W9JSW/Hermes-Lite/FR-Sense/FRSense-BOM.xls

Digi-Key Part Number | Manufacturer | Manufacturer Part Number | Customer Reference | Quantity | Description | Notes
311-1361-1-ND | YAGEO (VA) | CC0805ZRY5V9BB104 | C3 C5 C6 C7 C8 | 5 | CAP CER 0.1UF 50V Y5V 0805
S1011E-03-ND | SULLINS CONNECTOR SOLUTIONS (VA) | PBC03SAAN | P1 | 1 | CONN HEADER .100 SINGL STR 3POS
399-3797-1-ND | KEMET (VA) | T491D476M025AT | C4 | 1 | CAP TANT 47UF 25V 20% 2917
S1011E-02-ND | SULLINS CONNECTOR SOLUTIONS (VA) | PBC02SAAN | P2 | 1 | CONN HEADER .100 SINGL STR 2POS
490-6981-1-ND | MURATA ELECTRONICS (VA) | NFM21PC224R1C3D | C1 C2 | 2 | FILTER HIGH FREQ 220000PF 080
311-1.80KCRCT-ND | YAGEO (VA) | RC0805FR-071K8L | R1 R3 | 2 | RES SMD 1.8K OHM 1% 1/8W 0805
311-1.00KCRCT-ND | YAGEO (VA) | RC0805FR-071KL | R2 R5 | 2 | RES SMD 1K OHM 1% 1/8W 0805
311-220KCRCT-ND | YAGEO (VA) | RC0805FR-07220KL | R4 R6 | 2 | RES SMD 220K OHM 1% 1/8W 0805
311-100KCRCT-ND | YAGEO (VA) | RC0805FR-07100KL | R7 R8 | 2 | RES SMD 100K OHM 1% 1/8W 0805
311-49.9CRCT-ND | YAGEO (VA) | RC0805FR-0749R9L | R9 R10 | 1 | RES SMD 49.9 OHM 1% 1/8W 0805 | Substitute for 50.1 ohm values
490-5987-1-ND | MURATA ELECTRONICS (VA) | BLM21PG220SN1D | L1 | 1 | FERRITE CHIP 22 OHM 0805
1N5711W-FDICT-ND | DIODES INC | 1N5711W-7-F | D1 D2 D3 D4 | 4 | Schottky Diode | Install reversed – silkscreen incorrect
LMC6482IMX/NOPBCT-ND | TEXAS INSTRUMENTS | LMC6482IMX/NOPB | U1 | 1 | LMC6482A Dual Op-Amp
 | Amidon |  | T1 T2 | 2 | FT43-37 Toroid | Kits and Parts
WM5524-ND | MOLEX INC | 0731000105 | P3 P4 | 2 | CONN BNC JACK R/A 50 OHM PCB
