W9JSW/Hermes-Lite/power2/power2-bom.xls

Item | Quantity | Reference | Value | Item | Mfg Part Number | DigiKey Part Number | Notes
1 | 1 | C1 | 47uF 25V | Tantalum Cap | T491D476M025AT | 399-3797-1-ND
2 | 4 | C3 C9 C10 C11 | 100nF | Capacitor | CC0805ZRY5V9BB104 | 311-1361-1-ND | C11 optional
3 | 4 | C5 C6 C7 C8 | NFM21PC224R1C3D | Filter | NFM21PC224R1C3D | 490-6981-1-ND
4 | 2 | C2 C4 | 10uF | Capacitor | GRM219R61E106KA12D | 490-7207-1-ND
5 | 2 | D1 D2 | 1n5711 | Schottky Diode | 1N5711W-7-F | 1N5711W-FDICT-ND
6 | 1 | D3 | BZX84C 3V3 | Zener Diode | BZX84C3V3-TP | BZX84C3V3-TP-ND | Optional
7 | 2 | L1 L2 | BLM21PG220SN1D | Ferrite | BLM21PG220SN1D | 490-5987-1-ND
8 | 1 | P1 (P4) | 2x12 angled socket | can sub 2 2x6 sockets | PPPC122LJBN-RC | S5565-ND
9 | 2 | P2 P5 | CONN_01X02 | Sullins connector | PBC02SAAN | S1011E-02-ND
10 | 1 | P3 | CONN_01X03 | Sullins connector | PBC03SAAN | S1011E-03-ND
11 | 1 | P6 | CONN_01X05 | Can wire directly
12 | 2 | n/a | Socket 1x03 | Regulator Socket | PPPC031LFBN-RC | S7036-ND
13 | 1 | R1 R11 | 1k | resistor | RC0805FR-071KL | 311-1.00KCRCT-ND
14 | 1 | R10 | 820 | resistor | CRCW0805820RFKEA | 541-820CCT-ND | Optional
15 | 1 | R2 | 100 | resistor | RC0805FR-07100RL | 311-100CRCT-ND
16 | 3 | R3 R5 R7 | 100k | resistor | RC0805FR-07100KL | 311-100KCRCT-ND
17 | 1 | R4 | 220k | resistor | RC0805FR-07220KL | 311-220KCRCT-ND
18 | 2 | R6 R8 | 510k | resistor | RC0805JR-07510KL | 311-510KARCT-ND
19 | 1 | R9 | 4.7k | resistor | RC0805FR-074K7L | 311-4.70KCRCT-ND | Optional
20 | 1 | R12 | 270 | resistor | RC0805FR-07270R | 311-270CRCT-ND
21 | 3 | R13 R14 R15 | 10k | resistor | RC0805FR-0710KL | 311-10.0KCRCT-ND
22 | 1 | U1 | ADC78H90CIMT | ADC | ADC78H90CIMTX/NOPB | 296-35239-1-ND
23 | 1 | U2 | Oki 5V Reg | Vert Regulator | OKI-78SR-5/1.5-W36-C | 811-2196-5-ND
24 | 1 | U3 | Oki 3.3V Reg | Vert Regulator | OKI-78SR-3.3/1.5-W36-C | 811-2195-5-ND
25 | 1 | U4 | LMC6482A | Op-amp | LMC6482IMX/NOPB | LMC6482IMX/NOPBCT-ND
26 | 3 | U5 U6 U7 | LTV356 | Opto-isolator | LTV356T | 160-1337-1-ND
 |  | Optional components enable a 12v vs 13.8v sensor for PowerSDR. Not necessary at all...
