W9JSW/Hermes-Lite/FR-Sense/Converter-BOM.xls

Digi-Key Part Number | Manufacturer | Manufacturer Part Number | Customer Reference | Quantity 1 | Description
311-1361-1-ND | YAGEO (VA) | CC0805ZRY5V9BB104 | C3,C6,C8,C10 | 4 | CAP CER 0.1UF 50V Y5V 0805
445-7664-1-ND | TDK CORPORATION (VA) | C2012X5R1A226K125AB | C4,C9 | 2 | CAP CER 22UF 10V 10% X5R 0805
490-5986-1-ND | MURATA ELECTRONICS (VA) | BLM21PG121SN1D | L1,L4 | 2 | FERRITE CHIP 120 OHM 0805
S1011E-04-ND | SULLINS CONNECTOR SOLUTIONS (VA) | PBC04SAAN | P2 | 1 | CONN HEADER .100 SINGL STR 4POS
399-3797-1-ND | KEMET (VA) | T491D476M025AT | C5,C15 | 2 | CAP TANT 47UF 25V 20% 2917
S1011E-02-ND | SULLINS CONNECTOR SOLUTIONS (VA) | PBC02SAAN | P1 | 1 | CONN HEADER .100 SINGL STR 2POS
399-3734-1-ND | KEMET (VA) | T491C106K025AT | C1,C12 | 2 | CAP TANT 10UF 25V 10% 2413
490-6981-1-ND | MURATA ELECTRONICS (VA) | NFM21PC224R1C3D | C2,C11 | 2 | FILTER HIGH FREQ 220000PF 080
308-2342-1-ND | SUMIDA AMERICA COMPONENTS INC (VA) | 252012CDMCDS-1R0MC | L3 | 1 | FIXED IND 1UH 3.1A 35 MOHM SMD
308-2343-1-ND | SUMIDA AMERICA COMPONENTS INC (VA) | 252012CDMCDS-1R5MC | L2 | 1 | FIXED IND 1.5UH 2.5A 55 MOHM SMD
311-10.0KCRCT-ND | YAGEO (VA) | RC0805FR-0710KL | R2,R3 | 2 | RES SMD 10K OHM 1% 1/8W 0805
311-45.3KCRCT-ND | YAGEO (VA) | RC0805FR-0745K3L | R4 | 1 | RES SMD 45.3K OHM 1% 1/8W 0805
311-73.2KCRCT-ND | YAGEO (VA) | RC0805FR-0773K2L | R1 | 1 | RES SMD 73.2K OHM 1% 1/8W 0805
311-1449-1-ND | YAGEO (VA) | CC0603KRX5R5BB225 | C7 | 1 | CAP CER 2.2UF 6.3V 10% X5R 0603
490-5987-1-ND | MURATA ELECTRONICS (VA) | BLM21PG220SN1D | L5 | 1 | FERRITE CHIP 22 OHM 0805
