W9JSW/Hermes-Lite/frontend/v2-RX-Filter/v2rx-bom.xls

Quantity | Reference | Value | Description | Manufacturer | Manufacturer Part Number | Substitution allowed? | Comments | Supplier | Supplier PN | Cost | Sub-Total
5 | C1 C52 C74 C80 C81 | 0.1uF |  | Yageo | CC0805ZRY5V9BB104 | Yes | CAP CER 0.1UF 50V Y5V 0805 | Digi-Key | 311-1361-1-ND | $0.03 | $0.15
7 | C44 C75-C79 C82 | 0.01uF | SMT | Yageo | CC0805KRX7R9BB103 | Yes | CAP CER 10000PF 50V X7R 0805 | Digi-Key | 311-1136-1-ND | $0.71 | $4.97
5 | C18 C23 C37 C45 C62 | 120pF |  | Yageo | CC0805JRNPO9BN121 | Yes | CAP CER 120PF 50V 5% | Digi-Key | 311-1112-1-ND | $0.11 | $0.55
1 | C14 | 82pF |  | Yageo | CC0805JRNPO9BN820 | Yes | CAP CER 82PF 50V 5% | Digi-Key | 311-1110-1-ND | $0.10 | $0.10
4 | C19 C25 C47 C63 | 180pF |  | Yageo | CC0805JRNPO9BN181 | Yes | CAP CER 180PF 50V NPO 5% | Digi-Key | 311-1114-1-ND | $0.06 | $0.22
3 | C29 C43 C51 | 1500pF |  | Kemet | C0805C152J5GACTU | Yes | CAP CER 1500PF 50V NP0 0805 | Digi-Key | 399-8027-1-ND | $0.24 | $0.72
2 | C39 C40 | 270pF |  | Yageo | CC0805JRNPO9BN271 | Yes | CAP CER 270PF 50V 5% | Digi-Key | 311-1116-1-ND | $0.12 | $0.24
4 | C21 C27 C49 C65 | 560pF |  | Yageo | CC0805JRNPO9BN561 | Yes | CAP CER 560PF 50V 5% | Digi-Key | 311-1120-1-ND | $0.14 | $0.56
2 | C22 C66 | 1000pF |  | Yageo | CC0805JRNPO0BN102 | Yes | CAP CER 1000PF 100V NPO 0805 | Digi-Key | 311-1835-1-ND | $0.10 | $0.20
1 | C35 | 220pF |  | Yageo | CC0805JRNPO9BN221 | Yes | CAP CER 220PF 50V 5% | Digi-Key | 311-1115-1-ND | $0.12 | $0.12
2 | C16 C60 | 68pF |  | Yageo | CC0805JRNPO9BN680 | Yes | CAP CER 68PF 50V NPO 5% | Digi-Key | 311-1109-1-ND | $0.10 | $0.20
1 | C20 C26 C48 C64 | 330pF |  | Yageo | CC0805JRNPO9BN331 | Yes | CAP CER 330PF 50V NPO 0805 | Digi-Key | 311-1117-1-ND | $0.11 | $0.11
1 | C41 | 680pF |  | Yageo | CC0805JRNPO9BN681 | Yes | CAP CER 680PF 50V 5% NPO 0805 | Digi-Key | 311-1121-1-ND | $0.15 | $0.15
3 | C28 C42 C50 | 1200pF |  | Yageo | CC0805JRNPO0BN122 | Yes | CAP CER 1200PF 100V NPO 0805 | Digi-Key | 311-1837-1-ND | $0.10 | $0.30
1 | P1 |  | 2x7 header | Sullins | PRPC007DAAN-RC | Yes | CONN HEADER .100" DUAL STR 14POS | Digi-Key | S2011EC-07-ND | $0.46 | $0.46
3 | L1 L15 L8 | 680nH |  | Abracon | AIML-1206-R68 | No | FIXED IND 680NH 150MA 650 MOHM | Digi-Key | 535-11689-1-ND | $0.20 | $0.60
3 | L10 L17 L3 | 820nH |  | Abracon | AIML-1206-R82 | No | FIXED IND 820NH 150MA 650 MOHM | Digi-Key | 535-11690-1-ND | $0.20 | $0.60
3 | L4 L11 L18 | 1.5uH |  | Abracon | AIML-1206-1R5 | No | FIXED IND 1.5UH 50MA 450 MOHM | Digi-Key | 535-11663-1-ND | $0.20 | $0.60
3 | L5 L12 L19 | 2.2uH |  | Abracon | AIML-1206-2R2 | No | FIXED IND 2.2UH 50MA 550 MOHM | Digi-Key | 535-11667-1-ND | $0.20 | $0.60
3 | L6 L13 L20 | 3.9uH |  | Abracon | AIML-1206-3R9 | No | FIXED IND 3.9UH 50MA 700 MOHM | Digi-Key | 535-11672-1-ND | $0.20 | $0.60
3 | L7 L14 L21 | 8.2uH |  | Abracon | AIML-1206-8R2 | No | FIXED IND 8.2UH 25MA 800 MOHM | Digi-Key | 535-11676-1-ND | $0.20 | $0.60
1 | P2 | CONN_01X02 | 1x2 header | Sullins | PBC02SAAN | Yes | CONN HEADER .100" 2POS PCB | Digi-Key | S1011E-02-ND | $0.48 | $0.48
1 | P4 | CONN_01X02 | 1x2 header | Sullins | PBC02SAAN | Yes | CONN HEADER .100" 2POS PCB | Digi-Key | S1011E-02-ND | $0.48 | $0.48
2 | P3 P4 | CONN_02X03 | DNI-Jumper |  |  |  |  |  |  | $0.48 | $0.96
2 | U1 U9 | CD4504 |  | Fairchild | CD4504BM96 | Yes | IC VOLT-LVL SHIFTER HEX 16-SOIC | Digi-Key | 296-14150-1-ND | $0.24 | $0.48
14 | U2-U8 U10-U16 | PE4259-53 |  | Peregrine | 4259-63 | No | IC RF SWITCH SPDT 50 OHM SC70-6 | Digi-Key | 1046-1011-1-ND | $0.65 | $9.10
2 | FB1 FB2 | Ferrite Bead |  | Murata | BLM21PG220SN1D | No | FERRITE CHIP 22 OHM 0805 | Digi-Key | 490-5987-1-ND
 |  |  |  |  |  |  |  |  |  |  | $24.16
