W9JSW/Hermes-Lite/frontend/v2-PushPull-Amp/bom-pp-amp-v1.0.xls

Line Item | Quantity | Designator | Value/Description | Package | Type | Manufacturer | Manufacturer P/N | Substitution Allowed | Comments | Supplier | Supplier P/N | Supplier Price | Total Price
1 | 19 | C1,C7,C8,C9,C11-14, C15-18,C65-69,C85-87 | 0.1 uF | 0805 | SMT | Yageo | CC0805ZRY5V9BB104 |  | CAP CER 0.1UF 50V Y5V 0805 | Digi-Key | 311-1361-1-ND | $0.04 | $0.817
2 | 2 | C10,C84 | 1 uF | 0805 | SMT | Yageo | CC0805ZRY5V8BB105 |  | CAP CER 1UF 25V Y5V 0805 | Digi-Key | 311-1358-1-ND | $0.10 | $0.200
3 | 1 | C14 | 47uF 25v Tantalum | SMT | SMT | Kemet | T491D476M025AT |  | CAP TANT 47UF 25V 20% 2917 | Digi-Key | 399-3797-1-ND | $1.68 | $1.680
4 | 1 | C20 | 10uF 25V | 1206 | SMT | Kemet | T491C106K025AT |  | CAP TANT 10UF 25V 10% 2413 | Digi-Key | 399-3734-1-ND | $0.69 | $0.690
5 | 1 | C19 | 4700pF 50V | 0805 | SMT | Yageo | CC0805JKNPO9BN472 |  | CAP CER 4700PF 50V 5% NPO 0805 | Digi-Key | 311-1832-1-ND | $0.10 | $0.100
 | 1 | extra | 22pF | 0805 | SMT | Yageo | CC0805JRNPO9BN220 | Possible 17/15 filter | CAP CER 22PF 50V NPO 0805 | Digi-Key | 311-1103-1-ND | $0.10
6 | 1 | C30 | 43pF | 0805 | SMT | Johansen | 251R15S430JV4E |  | CAP CER 43PF 250V NP0 0805 | Digi-Key | 712-1389-1-ND | $0.34 | $0.340
 | 1 | extra | 47pF | 0805 | SMT | Yageo | CC0805JRNPO9BN470 | Possible 17/15 filter | CAP CER 47PF 50V NPO 0805 | Digi-Key | 311-1107-1-ND | $0.10
7 | 1 | C5 | 56pf | 0805 | SMT | Yageo | CC0805JRNPO9BN560 |  | CAP CER 56PF 50V 5% NPO 0805 | Digi-Key | 311-1108-1-ND | $0.10 | $0.100
 | 1 | extra | 68pF | 0805 | SMT | Yageo | CC0805JRNPO9BN680 | Possible 17/15 filter | CAP CER 68PF 50V NPO 0805 | Digi-Key | 311-1109-1-ND | $0.10
8 | 4 | C2,C26,C62,C64,extra | 82pF | 0805 | SMT | Yageo | CC0805JRNPO9BN820 | Possible 17/15 filter | CAP CER 82PF 50V 5% NPO 0805 | Digi-Key | 311-1110-1-ND | $0.10 | $0.400
9 | 17 | C25,C29,C61,C70-83 | 100pF | 0805 | SMT | Yageo | CC0805JRNPO9BN101 |  | CAP CER 100PF 50V 5% NPO 0805 | Digi-Key | 311-1111-1-ND | $0.05 | $0.816
10 | 2 | C42,C48 | 130pF | 0805 | SMT | Murata | GRM2165C2A131JA01D |  | CAP CER 130PF 100V NP0 0805 | Digi-Key | 490-1602-1-ND | $0.17 | $0.340
11 | 2 | C4,C6 | 150pF | 0805 | SMT | Yageo | CC0805JRNPO0BN151 |  | CAP CER 150PF 100V 5% NPO 0805 | Digi-Key | 311-1839-1-ND | $0.10 | $0.200
12 | 2 | C24,extra | 180pF | 0805 | SMT | Yageo | CC0805JRNPO9BN181 | Possible 17/15 filter | CAP CER 180PF 50V 5% NPO 0805 | Digi-Key | 311-1114-1-ND | $0.10 | $0.200
13 | 2 | C38,C50 | 220pF | 0805 | SMT | Yageo | CC0805JRNPO9BN221 |  | CAP CER 220PF 50V 5% NPO 0805 | Digi-Key | 311-1115-1-ND | $0.10 | $0.200
14 | 1 | C59 | 240pF | 0805 | SMT | Murata | GRM2165C2A241JA01D |  | CAP CER 240PF 100V NP0 0805 |  | 490-1608-1-ND | $0.20 | $0.200
15 | 4 | C37,C47,C49,C60 | 270pF | 0805 | SMT | Yageo | CC0805JRNPO0BN271 |  | CAP CER 270PF 100V 5% NPO 0805 | Digi-Key | 311-1843-1-ND | $0.10 | $0.400
16 | 2 | C36,C41 | 300pF | 0805 | SMT | Murata | GRM2165C2A301JA01D |  | CAP CER 300PF 100V NP0 0805 | Digi-Key | 490-3304-1-ND | $0.19 | $0.380
17 | 1 | C23 | 360pF | 0805 | SMT | Murata | GRM2165C2A361JA01D |  | CAP CER 360PF 100V NP0 0805 | Digi-Key | 490-3305-1-ND | $0.19 | $0.190
18 | 2 | C22,C58 | 470pF | 0805 | SMT | Yageo | CC0805JRNPO9BN471 |  | CAP CER 470PF 50V 5% NPO 0805 | Digi-Key | 311-1119-1-ND | $0.10 | $0.200
19 | 1 | C35 | 680pf | 0805 | SMT | Yageo | CC0805JRNPO9BN681 |  | CAP CER 680PF 50V 5% NPO 0805 | Digi-Key | 311-1121-1-ND | $0.10 | $0.100
20 | 2 | C21,C57 | 820pF | 0805 | SMT | Kemet | C0805C821J1GACTU |  | CAP CER 820PF 100V NP0 0805 | Digi-Key | 399-8118-1-ND | $0.36 | $0.720
21 | 17 | C3,C27-28,C31-32, C39-40,C43-44,C51-53,C55-56,C63,C88,C89 | DNI | 0805 | SMT | Yageo |  |  | Do not populate at this time | Digi-Key
22 | 2 | C34,C46 | 1200pf | 0805 | SMT | Yageo | CC0805JRNPO0BN122 |  | CAP CER 1200PF 100V 5% NPO 0805 | Digi-Key | 311-1837-1-ND | $0.10 | $0.200
23 | 2 | C33,C45 | 2200pF | 0805 | SMT | Kemet | C0805C222J5GACTU |  | CAP CER 2200PF 50V NP0 0805 | Digi-Key | 399-8042-1-ND | $0.10 | $0.200
24 | 1 | C54 | 0R Jumper | 0805 | SMT | Yageo | RC0805JR-070RL |  | RES SMD 0.0 OHM JUMPER 1/8W 0805 | Digi-Key | 311-0.0ARCT-ND | $0.10 | $0.100
25 | 15 | K1-K15 | 12V Relay |  | TH | HK4100 | HK4100F-DC12V-SHG |  |  | ebay | HK4100F-DC12V-SHG | $0.56 | $8.400
26 | 6 | L4,L5,L10,L11,L16,L17 | T37-2 |  |  | Amidon |  |  |  | Kits and Parts | T37-2 | $0.20 | $1.200
27 | 15 | L1,L2,L6-9,L12-15,L18-22 | T37-6 |  |  | Amidon |  |  |  | Kits and Parts | T37-6 | $0.20 | $3.000
28 | 9 | Opt Extra | T37-10 |  |  | Amidon |  |  |  | Kits and Parts | T37-10 | $0.20 | $1.800
28 | 1 | L3 | FT37-43 |  |  | Amidon |  |  |  | Kits and Parts | FT37-43 | $0.24 | $0.240
29 | 1 | P1 | BNC | BNC | TH | MOLEX INC | 0731000105 |  | CONN BNC JACK R/A 50 OHM PCB | Digi-Key | WM5524-ND | $1.48 | $1.48
30 | 1 | Cable | 2x06 ribbon cable assy |  |  |  |  |  | Connect PA P2 to V2 front end CN2 |  |  |  | $0.00
31 | 1 | P2 | straight 2x06 Pin Hdr |  |  | Sullins |  |  |  | Digi-Key |  | $0.48 | $0.480
32 | 4 | P3,P4,P5,P6 | Straight 2 pin header |  | TH | MOLEX INC | 22292021 | With lock | CONN HEADER 2POS .100 VERT GOLD | Digi-Key | WM2744-ND | $0.45 | $1.800
33 | 1 | Q1 | CZT2222A |  |  | Central Semi | CZT2222A TR |  | TRANS NPN 40V 0.6A SOT223 | Digi-Key | CZT2222A CT-ND | $0.94 | $0.940
34 | 1 | Q2 | RD16HHF1 | TO220 |  | Mitsubishi |  |  |  | PartsPlace | RD16HHF1 | $5.00 | $5.000
35 | 1 | R13 | 4.7 | 0805 | SMT | Yageo | RC0805JR-074R7L |  | RES SMD 4.7 OHM 5% 1/8W 0805 | Digi-Key | 311-4.7ARCT-ND | $0.10 | $0.100
36 | 1 | R15 | 6.8 | 0805 | SMT | Yageo | RC0805FR-076R8L |  | RES SMD 6.8 OHM 1% 1/8W 0805 | Digi-Key | 311-6.80CRCT-ND | $0.10 | $0.100
37 | 1 | R10 | 18 | 0805 | SMT | Yageo | RC0805FR-0718RL |  | RES SMD 18 OHM 1% 1/8W 0805 | Digi-Key | 311-18.0CRCT-ND | $0.10 | $0.100
38 | 2 | R18 | 47 | 0805 | SMT | Yageo | RC0805FR-0747RL |  | RES SMD 47 OHM 1% 1/8W 0805 | Digi-Key | 311-47.0CRCT-ND | $0.10 | $0.200
39 | 2 | R3,R26 | 51 | 0805 | SMT | Yageo | RC0805FR-0751RL |  | RES SMD 51 OHM 1% 1/8W 0805 | Digi-Key | 311-51.0CRCT-ND | $0.23 | $0.460
40 | 3 | R5,R6,R7 | 68 | 0805 | SMT | Yageo | RC0805FR-0768RL |  | RES SMD 68 OHM 1% 1/8W 0805 | Digi-Key | 311-68.0CRCT-ND | $0.00 | $0.000
41 | 2 | R2,R27 | 120 | 0805 | SMT | Yageo | RC0805FR-07120RL |  | RES SMD 120 OHM 1% 1/8W 0805 | Digi-Key | 311-120CRCT-ND | $0.10 | $0.200
42 | 3 | R8,R12,R17 | 270 | 0805 | SMT | Panasonic | ERJ-P06J271V |  | RES SMD 270 OHM 5% 1/2W 0805 | Digi-Key | P270ADCT-ND | $0.12 | $0.360
43 | 1 | R11 | 1k | 0805 | SMT | Yageo | RC0805FR-071KL |  | RES SMD 1K OHM 1% 1/8W 0805 | Digi-Key | 311-1.00KCRCT-ND | $0.10 | $0.100
44 | 1 | R9 | 1.2k | 0805 | SMT | Yageo | RC0805FR-071K2L |  | RES SMD 1.2K OHM 1% 1/8W 0805 | Digi-Key | 311-1.20KCRCT-ND | $0.10 | $0.100
45 | 2 | R1,R28 | 2.7k | 0805 | SMT | Yageo | RC0805JR-072K7L |  | RES SMD 2.7K OHM 5% 1/8W 0805 | Digi-Key | 311-2.70KARCT-ND | $0.10 | $0.200
46 | 3 | R14,R16,R19 | 10k | 0805 | SMT | Yageo | RC0805FR-0710KL |  | RES SMD 10K OHM 1% 1/8W 0805 | Digi-Key | 311-10.0KCRCT-ND | $0.10 | $0.300
47 | 1 | R4 | 39k | 0805 | SMT | Yageo | RC0805FR-0739KL |  | RES SMD 39K OHM 1% 1/8W 0805 | Digi-Key | 311-39.0KCRCT-ND | $0.10 | $0.100
48 | 1 | R10 extra | 5.6 | 0805 | SMT | Yageo | RC0805FR-075R6L | optional values | RES SMD 5.6 OHM 1% 1/8W 0805 | Digi-Key | 311-5.60CRCT-ND | $0.10 | $0.100
49 | 1 | R10 extra | 12 | 0805 | SMT | Yageo | RC0805FR-0712RL | optional values | RES SMD 12 OHM 1% 1/8W 0805 | Digi-Key | 311-12.0CRCT-ND | $0.10 | $0.100
50 | 1 | R10 extra | 24 | 0805 | SMT | Yageo | RC0805FR-0724RL | optional values | RES SMD 24 OHM 1% 1/8W 0805 | Digi-Key | 311-24.0CRCT-ND | $0.10 | $0.100
51 | 1 | R10 extra | 30 | 0805 | SMT | Yageo | RC0805FR-0730RL | optional values | RES SMD 30 OHM 1% 1/8W 0805 | Digi-Key | 311-30.0CRCT-ND | $0.10 | $0.100
52 | 2 | R8/12 extra | 180 | 0805 | SMT | Yageo | RC0805FR-07180RL | optional values | RES SMD 180 OHM 1% 1/8W 0805 | Digi-Key | 311-180CRCT-ND | $0.10 | $0.200
53 | 2 | R8/12 extra | 220 | 0805 | SMT | Yageo | RC0805FR-07220RL | optional values | RES SMD 220 OHM 1% 1/8W 0805 | Digi-Key | 311-220CRCT-ND | $0.10 | $0.200
54 | 2 | R8/12 extra | 430 | 0805 | SMT | Yageo | RC0805FR-07430RL | optional values | RES SMD 430 OHM 1% 1/8W 0805 | Digi-Key | 311-430CRCT-ND | $0.10 | $0.200
55 | 2 | R8/12 extra | 910 | 0805 | SMT | Yageo | RC0805FR-07910RL | optional values | RES SMD 910 OHM 1% 1/8W 0805 | Digi-Key | 311-910CRCT-ND | $0.10 | $0.200
56 | 1 | T2 | BN-43-2402 |  | TH | Amidon |  |  |  | Kits and Parts | BN-43-2402 | $0.24 | $0.240
57 | 2 | T1 | BN-43-202 |  | TH | Amidon |  |  |  | Kits and Parts | BN-43-202 | $0.50 | $1.000
58 | 1 | U1 | LP2951-50D | SOIC8 | SMT | TI | LP2951-50DR |  | IC REG LDO 5V/ADJ 0.1A 8SOIC | Digi-Key | 296-31677-1-ND | $0.62 | $0.620
59 | 1 | VR1 | 1k 25 Turn Potentiometer |  | TH | Murata | PV36W102C01B00 | yes | TRIMMER 1K OHM 0.5W TH | Digi-Key | 490-2874-ND | $1.51 | $1.510
60 |  | 22ft | #26 Enameled Wire |  |  |  |  |  |  |  |  |  |  | $40.003
61 |  |  | RG-316 coax |  |  |  |  |  | 10 inches, can buy on ebay by the foot
62 | 1 | Heatsink | ??mm??mm Aluminum |  |  |  |  | not determined yet | buy from china on ebay |  |  | $0.00 | $0.000
63 | 4 | Screws | 4-40 Slotted Head Pan Screws with nuts |  |  |  |  | yes, can sub M3 if you tap the heatsink | procure locally
64 | 4 | Nylon Standoff | #4 by 1/4in |  |  |  |  | not determined yet |  |  |  |  | $0.000
 |  |  |  |  |  |  |  |  |  |  |  |  | $40.003
