W9JSW/Hermes-Lite/frontend/BPF Superband/bom-superband v1.3.xls

Line Item | Quantity | Designator | Value/Description | Package | Type | Manufacturer | Manufacturer P/N | Substitution Allowed | Comments | Supplier | Supplier P/N | Supplier Price | Total Price
1 | 15 | C1,C2,C3,C4,C12,C15, C16,C18,C19,C20,C26, C29,C30 | 0.1 uF | 0805 | SMT | Yageo | CC0805ZRY5V9BB104 | Yes | Low ESR | Digi-Key | 311-1361-1-ND | $0.10 | $1.500
2 | 4 | C23,C24,C25,C27 | 0.01uF | 0805 | SMT | Yageo | CC0805KRX7R9BB103 | Yes | Low ESR | Digi-Key | 311-1136-1-ND | $0.10 | $0.400
3 | 2 | C17,C28 | 1 uF | 0805 | SMT | Yageo | CC0805ZRY5V8BB105 | Yes | Low ESR | Digi-Key | 311-1358-1-ND | $0.10 | $0.200
4 | 1 | C7 | 47uF 25v Tantalum | SMT | SMT | Kemet | T491D476M025AT | Yes | CAP TANT 47UF 25V 20% 2917 | Digi-Key | 399-3797-1-ND | $1.68 | $1.680
5 | 1 | C22 | 10uF 25V | 1206 | SMT | Kemet | T491C106K025AT | Yes | CAP TANT 10UF 25V 10% 2413 | Digi-Key | 399-3734-1-ND | $0.69 | $0.690
6 | 1 | C21 | 4700pF 50V | 0805 | SMT | Yageo | CC0805KRX7R9BB472 |  | CAP CER 4700PF 50V 10% | Digi-Key | 311-1133-1-ND | $0.10 | $0.100
7 | 1 | D1 | LED Yellow | 0805 | SMT | Rohm | SML-212YTT86 | Yes, any 0805 | LED 591NM YLW WTR CLR 0805 | Digi-Key | 511-1296-1-ND | $0.58 | $0.580
8 | 1 | D2 | LED Red | 0805 | SMT | Rohm | SML-212VTT86 | Yes, any 0805 | LED 639NM RED WTR CLR 0805 | Digi-Key | 511-1295-1-ND | $0.58 | $0.580
9 | 1 | D3 | LED Green | 0805 | SMT | Rohm | SML-212MTT86 | Yes, any 0805 | LED 570NM GREEN WTR CLR 0805 | Digi-Key | 511-1287-1-ND | $0.54 | $0.540
10 |  | D4 | TVS Diode | SOD323 | SMT | Bourns Inc. | CDSOD323-T05LC | No | TVS DIODE 5VWM 9.8VC SOD323 | Digi-Key | CDSOD323-T05LCCT-ND | $0.91 | $0.000
11 | 1 | FB1 | Ferrite Chip | 0805 | SMT | TDK Corporation | MPZ2012S221A | Yes |  | Digi-Key | 445-1568-1-ND | $0.10 | $0.101
12 | 2 | K1,K2 | 12V Relay | DIP10 |  | TE | D3002 | Yes | NEC EA2-12NJ avail Mouser $2.39 | Digi-Key | PB1067-ND | $2.64 | $5.280
13 | 1 | L10 | FT37-43 |  |  | Amidon |  | Yes, 6T BN43-2402 | 11 Turns #26 Wire | Kits and Parts | FT37-43 | $0.24 | $0.240
14 | 1 | P1 | BNC | BNC | TH | Molex | 731000105 | Yes | CONN BNC JACK R/A 50 OHM PCB | Digi-Key | WM5524-ND | $1.48 | $1.48
15 | 3 | P2,P3,P4 | Straight 2 pin header |  |  | Sullins | PBC02SAAN | Yes | CONN HEADER .100" 2POS PCB | Digi-Key | S1011E-02-ND | $0.48 | $1.440
16 | 2 | Q1,Q2 | FDV301 |  |  | Fairchild | FDV301N | No | MOSFET N-CH 25V 220MA SOT-23 | Digi-Key | FDV301NCT-ND | $0.21 | $0.420
17 | 1 | Q3 | RD16HHF1 | TO220 |  | Mitsubishi | RD16HHF1 | No |  | KitsandParts | RD16HHF1 | $5.00 | $5.000
18 | 2 | R1,R2 | 499 Ohm | 0805 | SMT | Yageo | RC0805FR-07499RL | Yes | RES SMD 499 OHM 1% 1/8W 0805 | Digi-Key | 311-499CRCT-ND | $0.10 | $0.200
19 | 4 | R3,R9,R13,R14 | 4.99k | 0805 | SMT | Yageo | RC0805FR-074K99L | Yes | RES SMD 4.99K OHM 5% 1/8W | Digi-Key | 311-4.99KCRCT-ND | $0.10 | $0.400
20 | 1 | R4 | 0 Ohm | 0805 | SMT | Yageo | RC0805JR-070RL | Yes | Select to limit TX current | Digi-Key | 311-0.0ARCT-ND | $0.10 | $0.100
21 | 1 | R5 | 6.8 | 0805 | SMT | Yageo | RC0805FR-076R8L | Yes | RES SMD 6.8 OHM 5% 1/8W | Digi-Key | 311-6.80CRCT-ND | $0.10 | $0.100
22 | 2 | R6,R8,R15,R16 | 10k | 0805 | SMT | Yageo | RC0805FR-0710KL | Yes | RES SMD 10K OHM 5% 1/8W | Digi-Key | 311-10.0KCRCT-ND | $0.10 | $0.200
23 | 3 | R10,R12,R7 | 270 | 0805 | SMT | Panasonic | ERJ-P06J271V | Yes | RES SMD 270 OHM 5% 1/2W 0805 | Digi-Key | P270ADCT-ND | $0.23 | $0.690
24 | 1 | R11 | 18 | 0805 | SMT | Yageo | RC0805FR-0718RL | Yes | RES SMD 18 OHM 1% 1/8W 0805 | Digi-Key | 311-18.0CRCT-ND | $0.00 | $0.000
25 | 2 | T2,T3 | BN-43-2402 |  | TH | Amidon | BN-43-2402 | Yes, BN61 60/40 and higher freq |  | Kits and Parts | BN-43-2402 | $0.24 | $0.480
26 | 1 | T4 | BN-43-202 |  | TH | Amidon | BN-43-202 | No |  | Kits and Parts | BN-43-202 | $0.50 | $0.500
27 | 1 | U1 | LP2951-50D | SOIC8 | SMT | TI | LP2951-50DR | Yes | IC REG LDO 5V/ADJ 0.1A 8SOIC | Digi-Key | 296-31677-1-ND | $0.60 | $0.600
28 | 1 | VR1 | Bourns 3296W 1k 25 Turn |  | TH | Bourns | 3296W-1-102LF | Yes | TRIMMER 1K OHM 0.5W PC PIN | Digi-Key | 3296W-102LF-ND | $2.41 | $2.410
 |  |  | #26 Enameled Wire |  |  |  |  |  | Kitsandparts, radioshack |  |  |  |  | $25.911
 |  |  | #32 Enameled Wire |  |  |  |  | #30 works if careful | Kitsandparts, radioshack
 |  |  | RG-316 coax |  |  |  |  | Yes, Use RG-174 | Procure from ebay, avail by ft.
29 |  | Heatsink | 60mmx60mm Aluminum |  |  |  |  |  | Procure from ebay |  |  | $2.36
30 | 4 | Screws | 4-40 Slotted Head Pan Screws with nuts |  |  |  |  |  | Procure locally
31 | 4 | Nylon Standoff | #4 by 1/4in |  |  |  |  |  | Procure locally |  |  |  | $0.000
 |  | 160M Filter
32 | 3 | L5,L7,L8 | T37-2 |  |  |  |  |  | See Band Configuration 1.2.xls | Kits and Parts | T37-2 | $0.20 | $0.600
33 | 1 | L6 | T50-2 |  |  |  |  |  | See Band Configuration 1.2.xls | Kits and Parts | T50-2 | $0.20 | $0.200
34 | 1 | C10 | 1500pF | 0805 | SMT | Yageo | CC0805KRX7R9BB152 |  | CAP CER 1500PF 50V 10% | Digi-Key | 311-1128-1-ND | $0.10 | $0.100
35 | 1 | C11.1 | 470pF | 0805 | SMT | Yageo | CC0805JRNPO9BN471 |  | CAP CER 470PF 50V 5% | Digi-Key | 311-1119-1-ND | $0.12 | $0.120
36 | 1 | C11.2 | 220pF | 0805 | SMT | Yageo | CC0805JRNPO9BN221 |  | CAP CER 220PF 50V 5% | Digi-Key | 311-1115-1-ND | $0.12 | $0.120
37 | 1 | C13 | 4700pF | 0805 | SMT | Yageo | CC0805KRX7R9BB472 |  | CAP CER 4700PF 50V 10% | Digi-Key | 311-1133-1-ND | $0.10 | $0.100
38 | 1 | C14 | 2200pF | 0805 | SMT | Yageo | CC0805KRX7R9BB222 |  | CAP CER 2200PF 50V 10% | Digi-Key | 311-1129-1-ND | $0.10 | $0.100
 |  | 80/75M Filter
39 | 3 | L1,L3,L4 | T37-2 |  |  |  |  |  | See Band Configuration 1.2.xls | Kits and Parts | T37-2 | $0.20 | $0.600
40 | 1 | L2 | T50-2 |  |  |  |  |  | See Band Configuration 1.2.xls | Kits and Parts | T50-2 | $0.20 | $0.200
41 | 1 | C5.1 | 330pF | 0805 | SMT | Yageo | CC0805JRNPO9BN331 |  | CAP CER 330PF 50V 5% | Digi-Key | 311-1117-1-ND | $0.12 | $0.120
42 | 1 | C5.2 | 220pF | 0805 | SMT | Yageo | CC0805JRNPO9BN221 |  | CAP CER 220PF 50V 5% | Digi-Key | 311-1115-1-ND | $0.12 | $0.120
43 | 2 | C6 | 270pF | 0805 | SMT | Yageo | CC0805JRNPO9BN271 |  | CAP CER 270PF 50V 5% | Digi-Key | 311-1116-1-ND | $0.12 | $0.240
44 | 1 | C8 | 2700pF | 0805 | SMT | Yageo | CC0805KRX7R9BB272 |  | CAP CER 2700PF 50V 10% | Digi-Key | 311-1130-1-ND | $0.10 | $0.100
45 | 1 | C9 | 1500pF | 0805 | SMT | Yageo | CC0805KRX7R9BB152 |  | CAP CER 1500PF 50V 10% | Digi-Key | 311-1128-1-ND | $0.10 | $0.100
 |  | 60/40M Filter
46 | 4 | L5,L6,L7,L8 | T37-2 |  |  |  |  |  | See Band Configuration 1.2.xls | Kits and Parts | T37-2 | $0.20 | $0.800
47 | 1 | C10 | 100pF | 0805 | SMT | Yageo | CC0805JRNPO9BN101 |  | CAP CER 100PF 50V 5% | Digi-Key | 311-1111-1-ND | $0.10 | $0.100
48 | 1 | C11.1 | 150pF | 0805 | SMT | Yageo | CC0805JRNPO9BN151 |  | CAP CER 150PF 50V 5% | Digi-Key | 311-1113-1-ND | $0.11 | $0.110
49 | 1 | C11.2 | 150pF | 0805 | SMT | Yageo | CC0805JRNPO9BN151 |  | CAP CER 150PF 50V 5% | Digi-Key | 311-1113-1-ND | $0.11 | $0.110
50 | 1 | C13.1 | 1500pF | 0805 | SMT | Yageo | CC0805KRX7R9BB152 |  | CAP CER 1500PF 50V 10% | Digi-Key | 311-1128-1-ND | $0.10 | $0.100
51 | 1 | C13.2 | 100pF | 0805 | SMT | Yageo | CC0805JRNPO9BN101 |  | CAP CER 100PF 50V 5% | Digi-Key | 311-1111-1-ND | $0.05 | $0.054
52 | 1 | C14 | 820pF | 0805 | SMT | Yageo | CC0805KRX7R9BB821 |  | CAP CER 820PF 50V 10% | Digi-Key | 311-1194-1-ND | $0.10 | $0.100
 |  | 30/20M Filter
53 | 4 | L1,L2,L3,L4 | T37-6 |  |  |  |  |  | See Band Configuration 1.2.xls | Kits and Parts | T37-6 | $0.20 | $0.800
54 | 1 | C5 | 150pF | 0805 | SMT | Yageo | CC0805JRNPO9BN151 |  | CAP CER 150PF 50V 5% | Digi-Key | 311-1113-1-ND | $0.11 | $0.110
55 | 1 | C6 | 82pF | 0805 | SMT | Yageo | CC0805JRNPO9BN820 |  | CAP CER 82PF 50V 5% | Digi-Key | 311-1110-1-ND | $0.10 | $0.100
56 | 1 | C8.1 | 470pF | 0805 | SMT | Yageo | CC0805JRNPO9BN471 |  | CAP CER 470PF 50V 5% | Digi-Key | 311-1119-1-ND | $0.12 | $0.120
57 | 1 | C8.2 | 220pF | 0805 | SMT | Yageo | CC0805JRNPO9BN221 |  | CAP CER 220PF 50V 5% | Digi-Key | 311-1115-1-ND | $0.12 | $0.120
58 | 1 | C9 | 390pF | 0805 | SMT | Yageo | CC0805JRNPO9BN391 |  | CAP CER 390PF 50V 5% | Digi-Key | 311-1118-1-ND | $0.11 | $0.110
 |  | 17/15M Filter
59 | 4 | L5,L6,L7,L8 | T37-6 |  |  |  |  |  | See Band Configuration 1.2.xls | Kits and Parts | T37-6 | $0.20 | $0.800
60 | 1 | C10 | 100pF | 0805 | SMT | Yageo | CC0805JRNPO9BN101 |  | CAP CER 100PF 50V 5% | Digi-Key | 311-1111-1-ND | $0.10 | $0.100
61 | 1 | C11 | 47pF | 0805 | SMT | Yageo | CC0805JRNPO9BN470 |  | CAP CER 47PF 50V 5% | Digi-Key | 311-1107-1-ND | $0.10 | $0.100
62 | 1 | C13.1 | 560pF | 0805 | SMT | Yageo | CC0805JRNPO9BN561 |  | CAP CER 560PF 50V 5% | Digi-Key | 311-1120-1-ND | $0.14 | $0.140
63 | 1 | C13.2 | 68pF | 0805 | SMT | Yageo | CC0805JRNPO9BN680 |  | CAP CER 68PF 50V 5% | Digi-Key | 311-1109-1-ND | $0.10 | $0.100
64 | 1 | C14 | 270pF | 0805 | SMT | Yageo | CC0805JRNPO9BN271 |  | CAP CER 270PF 50V 5% | Digi-Key | 311-1116-1-ND | $0.12 | $0.120
 |  | 12/10M Filter
65 | 4 | L1,L2,L3,L4 | T37-6 |  |  |  |  |  | See Band Configuration 1.2.xls | Kits and Parts | T37-6 | $0.20 | $0.800
66 | 1 | C5 | 68pF | 0805 | SMT | Yageo | CC0805JRNPO9BN680 |  | CAP CER 68PF 50V 5% | Digi-Key | 311-1109-1-ND | $0.10 | $0.100
67 | 1 | C6 | 33pF | 0805 | SMT | Yageo | CC0805JRNPO9BN330 |  | CAP CER 33PF 50V 5% | Digi-Key | 311-1105-1-ND | $0.10 | $0.100
68 | 1 | C8.1 | 390pF | 0805 | SMT | Yageo | CC0805JRNPO9BN391 |  | CAP CER 390PF 50V 5% | Digi-Key | 311-1118-1-ND | $0.11 | $0.110
69 | 1 | C8.2 | 82pF | 0805 | SMT | Yageo | CC0805JRNPO9BN820 |  | CAP CER 82PF 50V 5% | Digi-Key | 311-1110-1-ND | $0.10 | $0.100
70 | 1 | C9.1 | 100pF | 0805 | SMT | Yageo | CC0805JRNPO9BN101 |  | CAP CER 100PF 50V 5% | Digi-Key | 311-1111-1-ND | $0.11 | $0.110
71 | 1 | C9.2 | 82pF | 0805 | SMT | Yageo | CC0805JRNPO9BN820 |  | CAP CER 82PF 50V 5% | Digi-Key | 311-1110-1-ND | $0.10 | $0.100
 |  |  |  |  |  |  |  |  |  |  |  |  | $34.245 | $1.389
