W9JSW/Hermes-Lite/frontend/Megabasic/bom.xls

Line Item | Quantity | Designator | Value/Description | Package | Type | Manufacturer | Manufacturer P/N | Substitution Allowed | Comments | Supplier | Supplier P/N | Supplier Price | Total Price
1 | 4 | C1,C2,C3,C4 | 0.1 uF | 0805 | SMT | Yageo | CC0805ZRY5V9BB104 | Yes | Low ESR | Digi-Key | 311-1361-1-ND | 0.022 | 0.09
2 | 1 | FB1 | Ferrite Chip | 0805 | SMT | TDK Corporation | MPZ2012S221A | Yes |  | Digi-Key | 445-1568-1-ND | 0.101 | 0.10
3 | 1 | R1 | 0 Ohm | 0805 | SMT | Yageo | RC0805JR-070RL | Yes | Select to limit TX current | Digi-Key | 311-0.0ARCT-ND | 0.018 | 0.02
4 | 1 | D1 | TVS Diode | SOD323 | SMT | Bourns Inc. | CDSOD323-T05LC | See Comments | May adjust to limit peak voltages | Digi-Key | CDSOD323-T05LCCT-ND | 0.910 | 0.91
5 | 2 | T1,T2 | BN-43-2402 |  | TH | Amidon | BN-43-2402 | See Comments | May change to improve balun | Amidon | BN-43-2402 | 0.700 | 1.40
6 | 2 | P1,P2 | BNC Connector | BNC | TH | Molex Inc. | 731000105 | Yes |  | Digi-Key | WM5524-ND | 1.480 | 2.96
7 | 2 | J1,J2 | Copper Wire Jumper |  |  |  |  |  |  |  |  | 0.000 | 0.00
 | 13 |  |  |  |  |  |  |  |  |  |  |  | 5.48
