W9JSW/Hermes-Lite/frontend/Megabasic/frontend-bom.xls

Reference | Value | Footprint | Description | Digikey
CN1 | EDGE | HERMESLITE:EDGE | PCI-E Board Edge connector
T2 | 8:1 | HERMESLITE:TRANSFREV | BN43-2402 core
T1 | 4:1 | HERMESLITE:TRANSFREV | BN43-2402 core
C3 | 0.1 uF | SMD_Packages:SMD-0805 | Ceramic Capacitor | 311-1361-1-ND
C4 | 0.1 uF | SMD_Packages:SMD-0805 | Ceramic Capacitor | 311-1361-1-ND
C2 | 0.1 uF | SMD_Packages:SMD-0805 | Ceramic Capacitor | 311-1361-1-ND
D1 | DIODESCH2 | HERMESLITE:SOD323 | TVS Diode as in basic frontend | CDSOD323-T05LCCT-ND
R1 | 0 | Resistors_SMD:R_0805_HandSoldering | Resistor
C1 | 0.1 uF | SMD_Packages:SMD-0805 | Ceramic Capacitor | 311-1361-1-ND
FB1 | FB | SMD_Packages:SMD-0805 | Ferrite Bead as in basic frontend
Q1 | FDV301 | HERMESLITE:SOT-23-GDS | MOSFET Fairchild
D2 | GREEN LED (PWR ON) | LEDs:LED-0805 | LED
R3 | 4.99K | Resistors_SMD:R_0805_HandSoldering | Resistor
R4 | 4.99k | Resistors_SMD:R_0805_HandSoldering | Resistor
D3 | RED LED (PTT) | LEDs:LED-0805 | LED
R2 | 10k | Resistors_SMD:R_0805_HandSoldering | Resistor
P3 | CONN_01X12 | Pin_Headers:Pin_Header_Straight_1x12 | Optional pin header
U2 | 74LS145 | Housings_SOIC:SOIC-16_3.9x9.9mm_Pitch1.27mm | TI 74LS145 SOIC-16 package | 296-26504-5-ND
U1 | 4050 | Housings_SOIC:SOIC-16_3.9x9.9mm_Pitch1.27mm | CD4050 hex buffer SOIC-16 package | 296-31503-1-ND
RR1 | RR9 - 10k | Discret:r_pack9 | resistor pack | 4610X-AP1-103LFCT-ND
R5 | 10k | Resistors_SMD:R_0805_HandSoldering | Resistor
P1 | CONN_01X02 | Pin_Headers:Pin_Header_Straight_1x02
P2 | CONN_01X02 | Pin_Headers:Pin_Header_Straight_1x02
J2 | CONN_02X01 | HERMESLITE:JUMPER | optional grounding jumper
J1 | CONN_02X01 | HERMESLITE:JUMPER | optional grounding jumper
P4 | Control for Megaband | Pin_Headers:Pin_Header_Straight_1x07 | Optional pin header
