W9JSW/Hermes-Lite/frontend/v2-RX-Filter/v2rx.csv

Reference | Value | Footprint | Datasheet
P5 | CONN_01X02 | Pin_Headers:Pin_Header_Straight_1x02
P2 | CONN_01X02 | Pin_Headers:Pin_Header_Straight_1x02
C7 | DNI | HERMESLITE:C_0805
C21 | 560pF | HERMESLITE:C_0805
C28 | 1200pF | HERMESLITE:C_0805
C42 | 1200pF | HERMESLITE:C_0805
C72 | DNI | HERMESLITE:C_0805
L20 | 3.9uH | HERMESLITE:Choke_SMD_1206_Standard
L6 | 3.9uH | HERMESLITE:Choke_SMD_1206_Standard
U8 | PE4259-53 | HERMESLITE:sc70-6
U16 | PE4259-53 | HERMESLITE:sc70-6
U15 | PE4259-53 | HERMESLITE:sc70-6
U7 | PE4259-53 | HERMESLITE:sc70-6
U6 | PE4259-53 | HERMESLITE:sc70-6
U5 | PE4259-53 | HERMESLITE:sc70-6
U4 | PE4259-53 | HERMESLITE:sc70-6
U14 | PE4259-53 | HERMESLITE:sc70-6
U13 | PE4259-53 | HERMESLITE:sc70-6
U12 | PE4259-53 | HERMESLITE:sc70-6
U1 | 4504 | Housings_SOIC:SOIC-16_3.9x9.9mm_Pitch1.27mm
P1 | CONN_02X07
L13 | 3.9uH | HERMESLITE:Choke_SMD_1206_Standard
C50 | 1200pF | HERMESLITE:C_0805
C65 | 560pF | HERMESLITE:C_0805
C58 | DNI | HERMESLITE:C_0805
C14 | DNI | HERMESLITE:C_0805
C35 | DNI | HERMESLITE:C_0805
C8 | DNI | HERMESLITE:C_0805
C22 | 1000pF | HERMESLITE:C_0805
C29 | 1500pF | HERMESLITE:C_0805
C43 | 1500pF | HERMESLITE:C_0805
C73 | DNI | HERMESLITE:C_0805
L21 | 8.2uH | HERMESLITE:Choke_SMD_1206_Standard
L7 | 8.2uH | HERMESLITE:Choke_SMD_1206_Standard
L14 | 8.2uH | HERMESLITE:Choke_SMD_1206_Standard
C51 | 1500pF | HERMESLITE:C_0805
C66 | 1000pF | HERMESLITE:C_0805
C59 | DNI | HERMESLITE:C_0805
C15 | DNI | HERMESLITE:C_0805
C36 | DNI | HERMESLITE:C_0805
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
C45 | 120pF | HERMESLITE:C_0805
C60 | 68pF | HERMESLITE:C_0805
C53 | DNI | HERMESLITE:C_0805
C9 | DNI | HERMESLITE:C_0805
C30 | DNI | HERMESLITE:C_0805
U9 | 4504 | Housings_SOIC:SOIC-16_3.9x9.9mm_Pitch1.27mm
P4 | CONN_02X03
P3 | CONN_02X03
C52 | 0.1uF | HERMESLITE:C_0805
C44 | 10uF
