W9JSW/Hermes-Lite/frontend/LPF Superband/Band Configuration v1.3.xls

 |  |  |  |  | Original Filter Values using Band Pass Filters (obsolete)
 | 160 |  | 80/75 |  | 60/40 |  | 30/20 |  | 17/15 |  | 12/10
L5 | 5.184uH 36T | L1 | 3.364uH 29T | L5 | 1.936uH 22T | L1 | 1.083uH 19T | L5 | 0.675uH 15T | L1 | 0.507uH 13T
 | T37-2 20" #26 |  | T37-2 13" #26 |  | T37-2 13" #26 |  | T37-6 11" #26 |  | T37-6 10" #26 |  | T37-6 9" #26
L6 | 11.664uH 54T | L2 | 7.396uH 43T | L6 | 3.600uH 30T | L2 | 2.028uH 26T | L6 | 1.452 uH 22T | L2 | 1.083uH 19T
 | T37-2 29" #26 |  | T37-2 24" #26 |  | T37-2 17" #26 |  | T37-6 15" #26 |  | T37-6 13" #26 |  | T37-6 12" #26
L7 | 3.364uH 29T | L3 | 1.296uH 18T | L7 | 0.784uH 14T | L3 | 0.432uH 12T | L7 | 0.243uH 9T | L3 | 0.192uH 8T
 | T37-2 17" #26 |  | T37-2 11" #26 |  | T37-2 9" #26 |  | T37-6 8" #26 |  | T37-6 7" #26 |  | T37-6 6" #26
L8 | 1.600uH 20T | L4 | 0.676uH 10T | L8 | 0.400uH 10T | L4 | 0.243uH 9T | L8 | 0.108uH 6T | L4 | 0.075uH 5T
 | T37-2 12" #26 |  | T37-2 9" #26 |  | T37-2 7" #26 |  | T37-6 6" #26 |  | T37-6 5" #26 |  | T37-6 5" #26
C10 | 1500pF | C5 | 550pF (330+220) | C10 | 330pF | C5 | 150pF | C10 | 100pF | C5 | 68pF
C11 | 690pF (470+220) | C6 | 270pf | C11 | 183pF (150+33) | C6 | 82pF | C11 | 47pF | C6 | 33pF
C13 | 4700pF | C8 | 2700pf | C13 | 1600pf (1500+100) | C8 | 690pF (470+220) | C13 | 628pF (560+68) | C8 | 472pF (390+82)
C14 | 2200pF | C9 | 1500pf | C14 | 820pF | C9 | 390pF | C14 | 270pF | C9 | 182pF (100+82)
 |  |  | The nomenclature of e.g. (300+220) denotes that 2 values are stacked one upon the other to install
 |  |  |  |  | Filter values for Superband LPF v1.3
 | 160 |  | 80/75 |  | 60/40 |  | 30/20 |  | 17/15 |  | 12/10
L3 | jumper across | L1 | jumper across | L3 | 1.02uH 16T | L1 | 430nH 12T | L3 | 300nH 10T | L1 | 240nH 9T
 |  |  |  |  | T37-2 11” #26 |  | T37-6 9" #26 |  | T37-6 8" #26 |  | T37-6 7" #26
L4 | 2.92uH 27T | L2 | 1.44uH 19T | L4 | 1.02uH 16T | L2 | 360nH 11T | L4 | 300nH 10T | L2 | 240nH 9T
 | T37-2 20" #26 |  | T37-2 12" #26 |  | T37-2 11” #26 |  | T37-6 9" #26 |  | T37-6 8" #26 |  | T37-6 7" #26
C10 | jumper across | C5 | jumper across | C10 | jumper across | C5 | 437pf (390+47) | C10 | 82pf | C5 | jumper across
C11 | jumper across | C6 | jumper across | C11 | jumper across | C6 | 68pf | C11 | 27pf | C6 | jumper across
C13 | 3300pf | C8 | 1800pf | C13 | 560pf | C8 | 690pF (470+220) | C13 | 470pf | C8 | 270pf
C14 | 3300pf | C9 | 1800pf | C14 | 300pf (150+150) | C9 | 390pF | C14 | 253pf (220+33) | C9 | 150pf
C33 | 220pf | C32 | 150pf | C33 | 150pf | C32 | 120pf | C33 | 220pf | C32 | none
 | invalid |  | invalid |  | invalid |  | untested |  | untested |  | invalid
