W9JSW/Hermes-Lite/frontend/v2-PushPull-Amp/INtegration_pre_V2_drawing.pdf

## BASIC RF BOARD v1.2

# Pre V2 INTERWIRING (Ribbon cable)

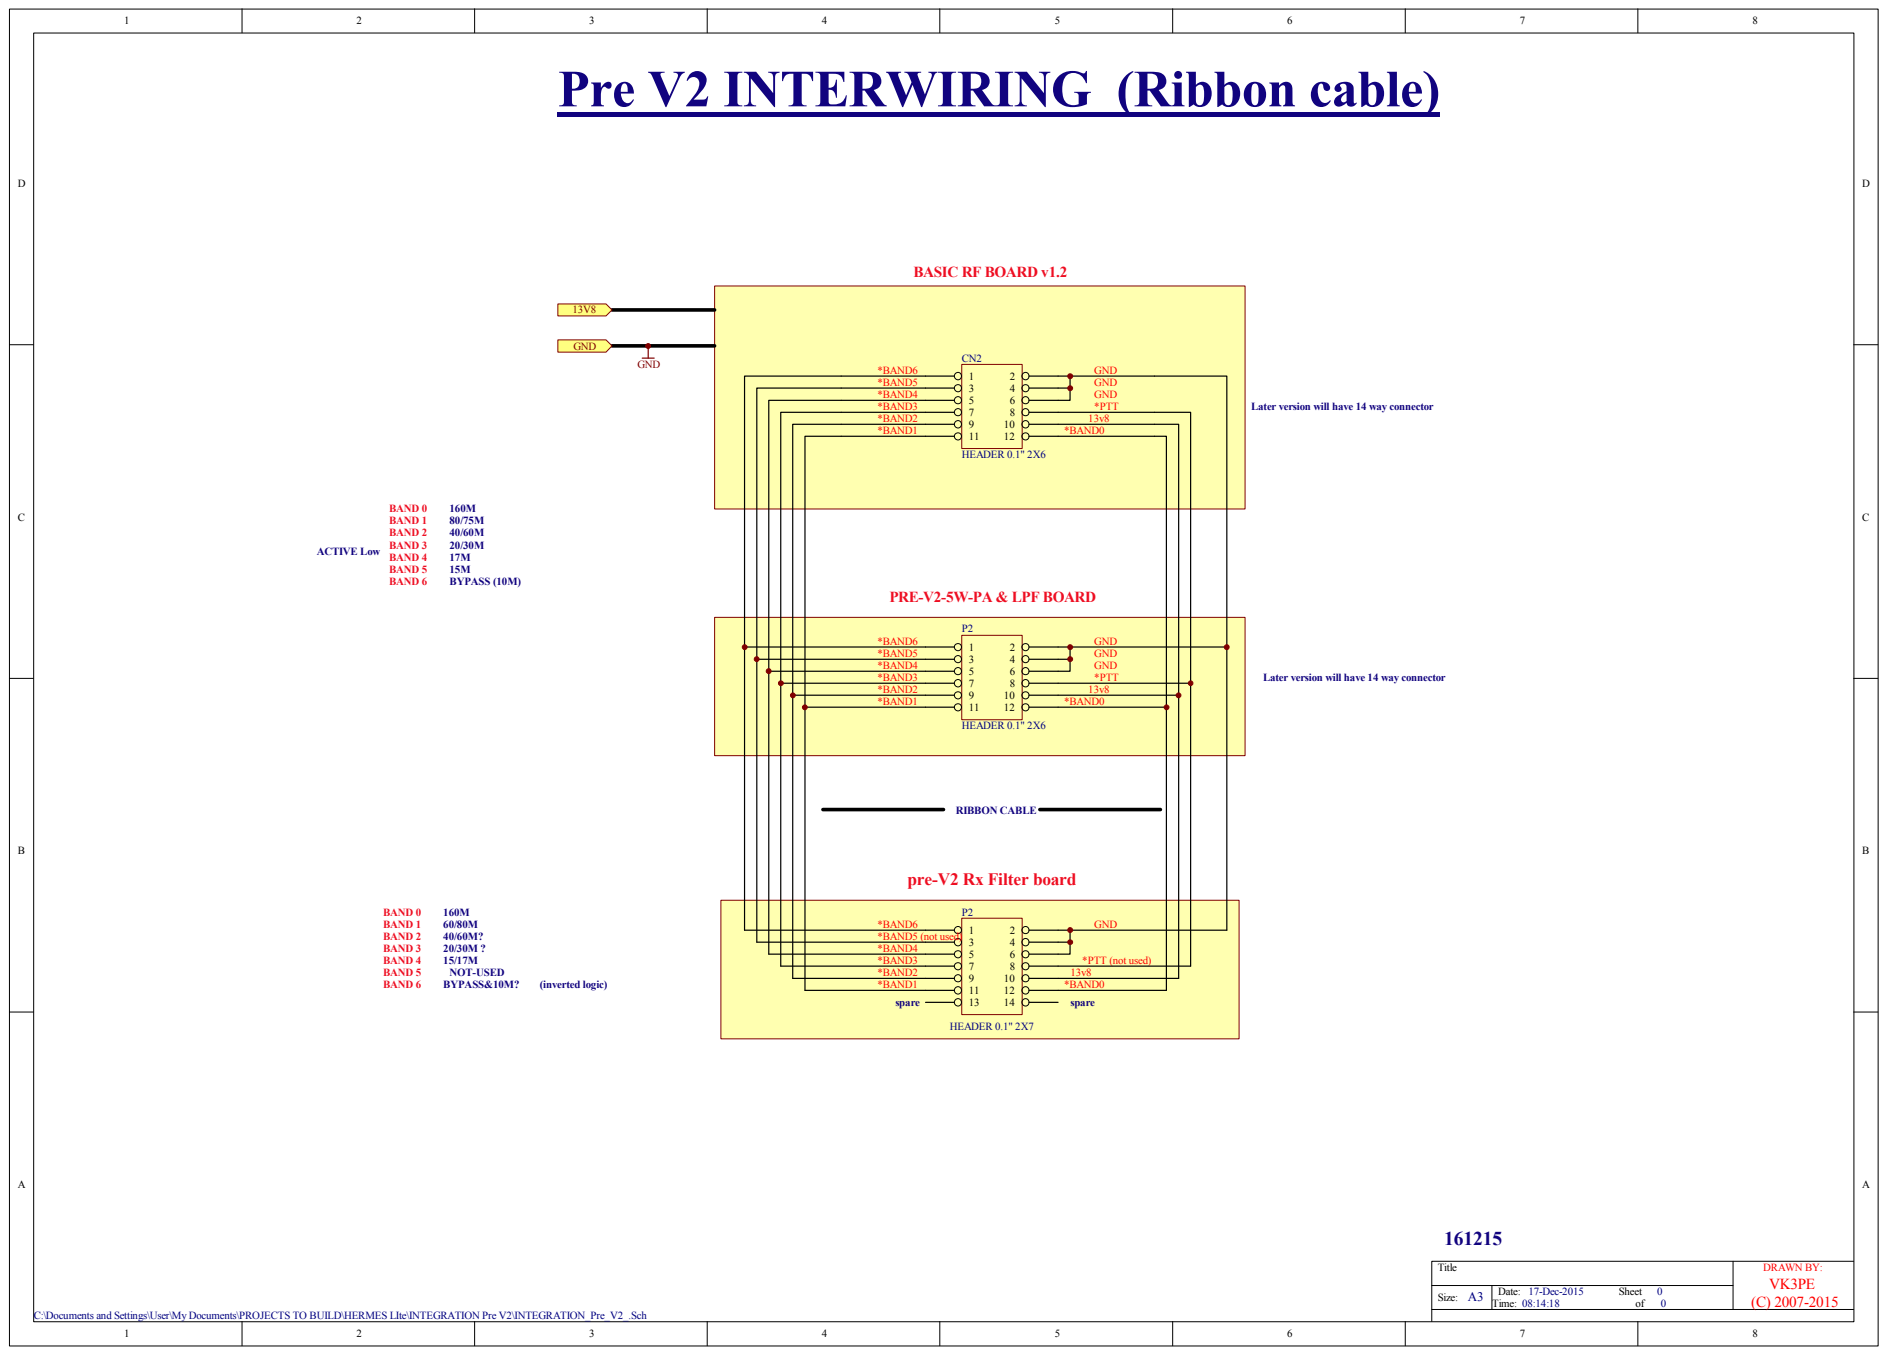
[picture p9: page 1]
17-Dec-2015 08:14:18; Title; Size:; Date:; Sheet Time:; DRAWN BY: VK3PE (C) 2007-2015; HEADER 0.1" 2X6; *BAND1; *BAND0; *BAND2; *BAND3; *BAND4; *BAND5; *BAND6; GND; GND GND *PTT; BAND 0 BAND 1 BAND 2 BAND 3 BAND 4 BAND 5 BAND 6; 160M 80/75M 40/60M 20/30M 17M 15M BYPASS (10M); BYPASS&10M?; NOT-USED; RIBBON CABLE; ACTIVE Low; HEADER 0.1" 2X7; *BAND5 (not used); (inverted logic); spare

Later version will have 14 way connector

PRE-V2-5W-PA & LPF BOARD

pre-V2 Rx Filter board

*PTT (not used)

C:\Documents and Settings\User\My Documents\PROJECTS TO BUILD\HERMES LIte\INTEGRATION Pre V2\INTEGRATION_Pre_V2_.Sch
