W9JSW/Hermes-Lite/frontend/v2-PushPull-Amp/Filters/Elsie 40M-60M adding 33pf.pdf

## QRP Labs 40M Low Pass Filter (1) and (2) adding 33pf across C29, C41 and C53

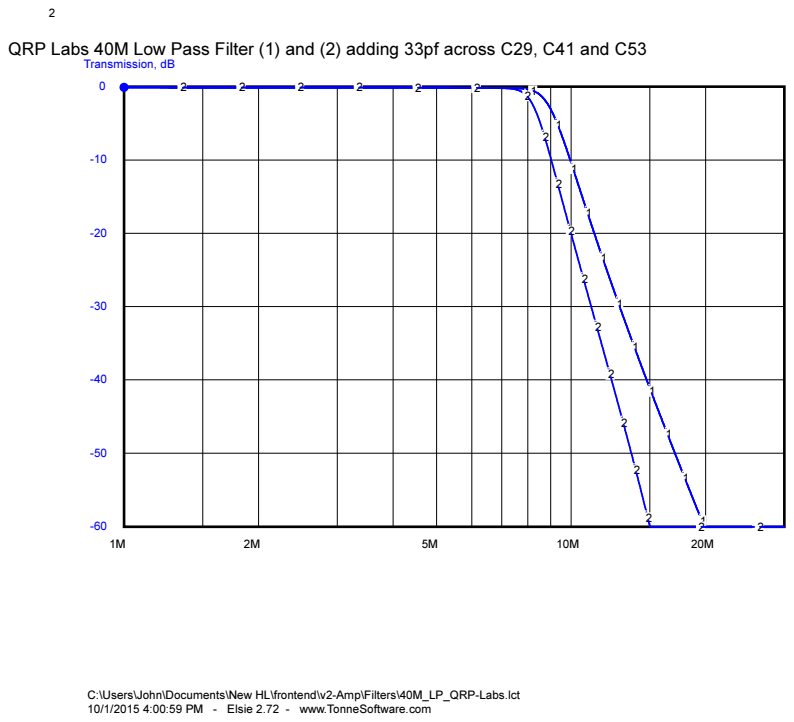
[picture p10: page 1]
Transmission, dB

C:\Users\John\Documents\New HL\frontend\v2-Amp\Filters\40M_LP_QRP-Labs.lct
10/1/2015 4:00:59 PM - Elsie 2.72 - www.TonneSoftware.com
