W9JSW/Hermes-Lite/power2/Power2 ADC Power Schematic v1.4.pdf

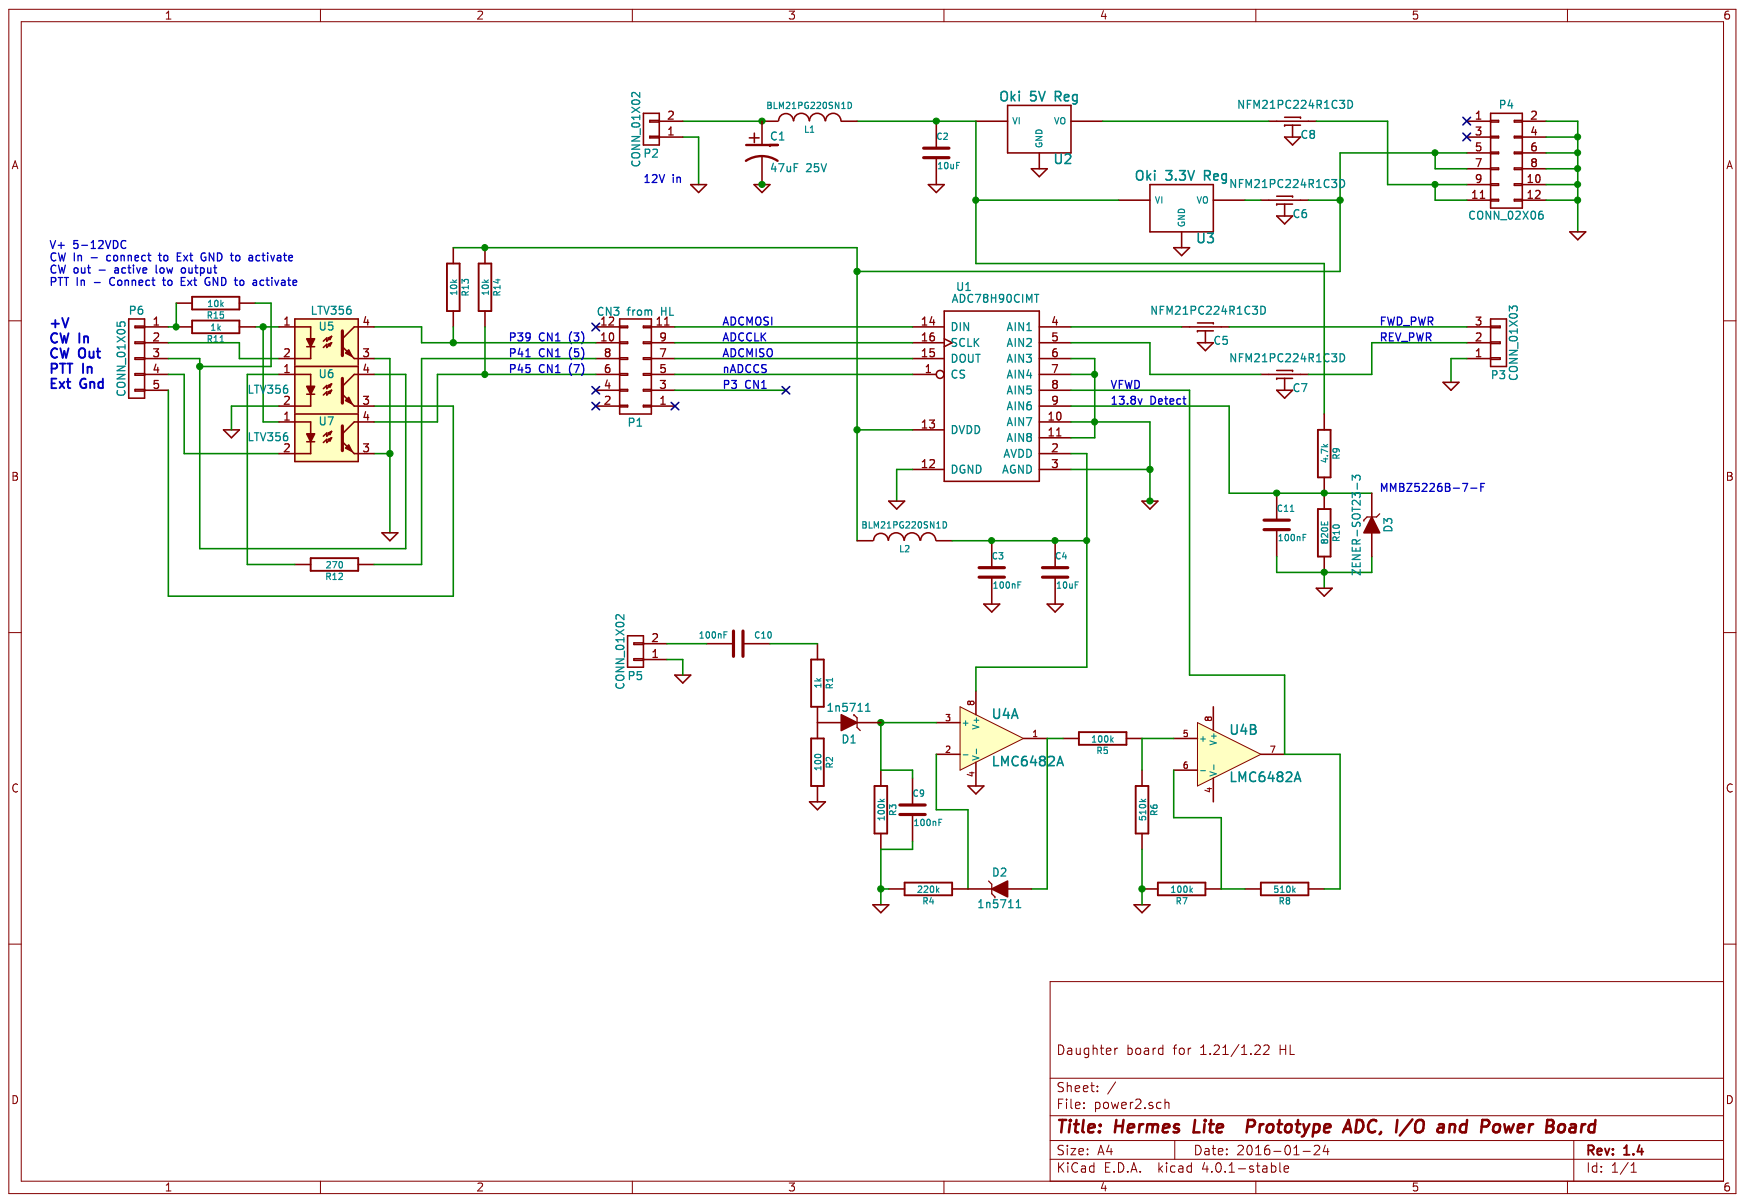
[picture p11: page 1]
