W9JSW/Hermes-Lite/FR-Sense/Power2 ADC Power Schematic.pdf

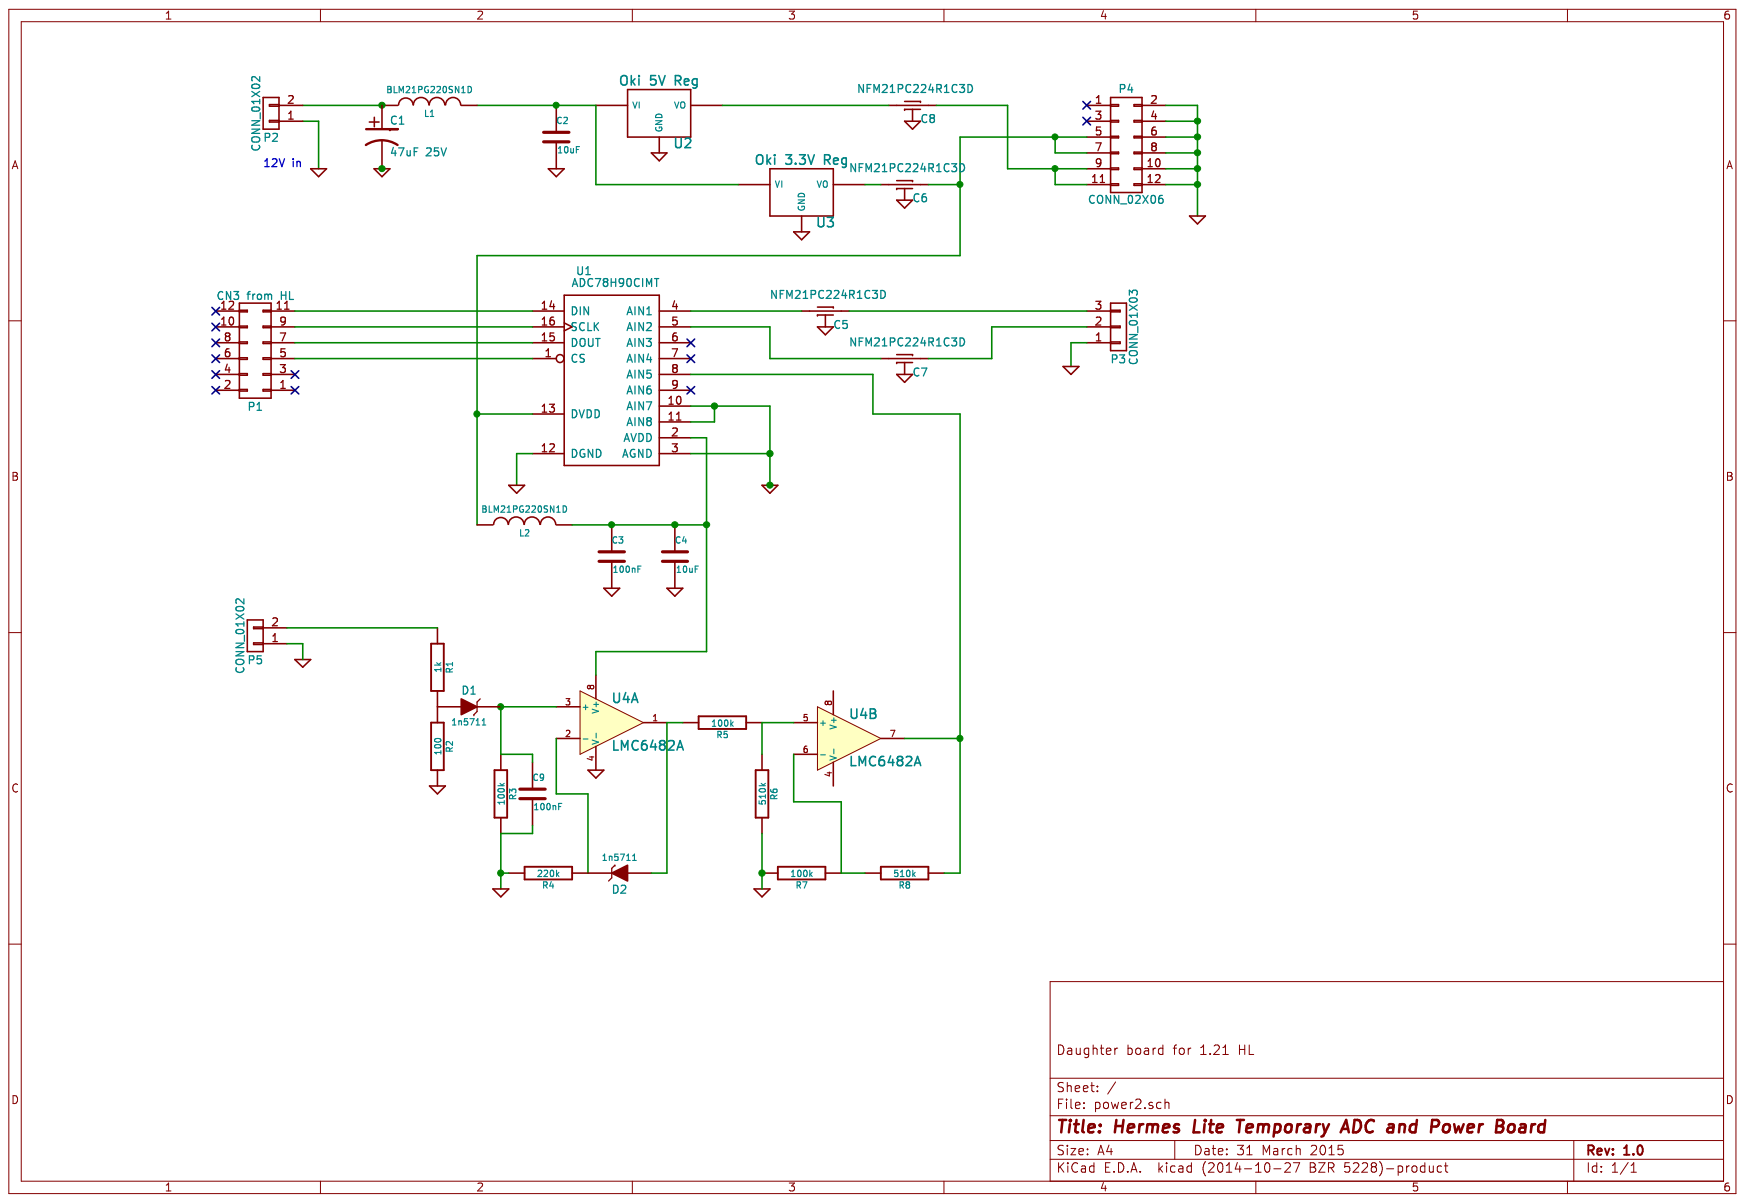
[picture p12: page 1]
