W9JSW/Hermes-Lite/frontend/Megabasic/gerber-print.pdf

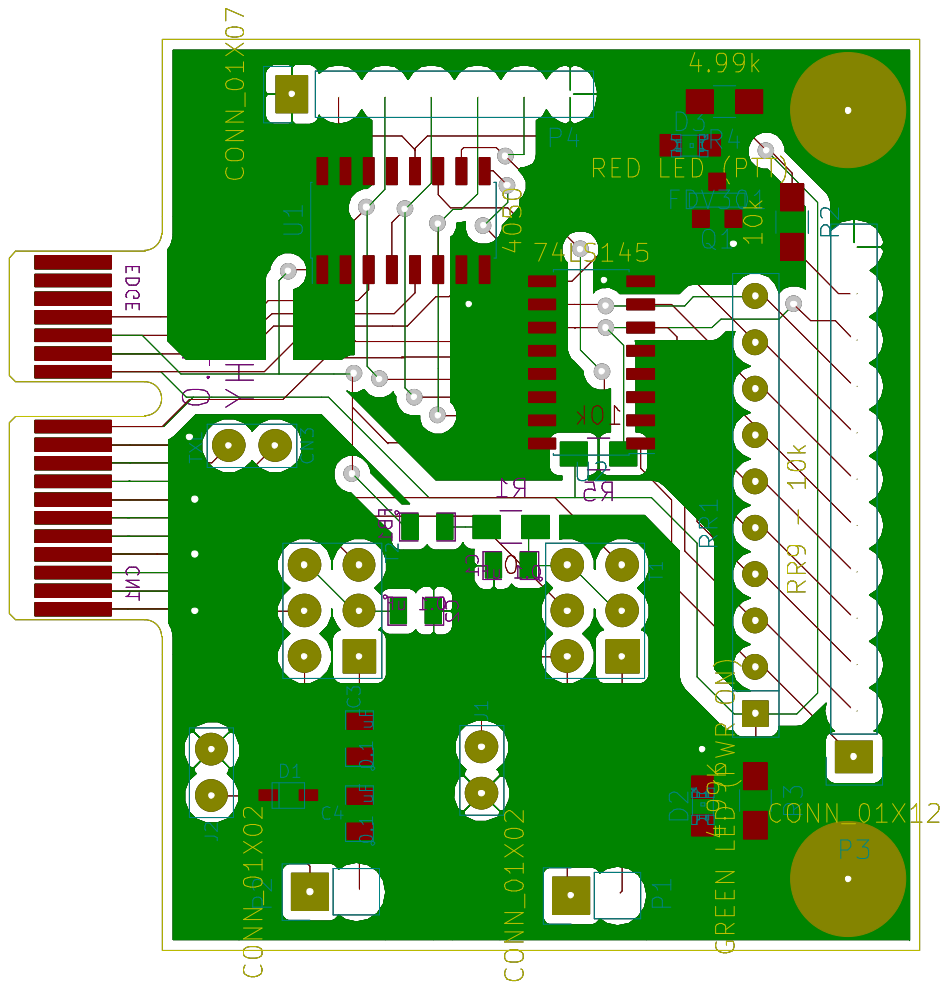
[picture p13: page 1]
