W9JSW/Hermes-Lite/FR-Sense/Fwd Rev Sense Board.pdf

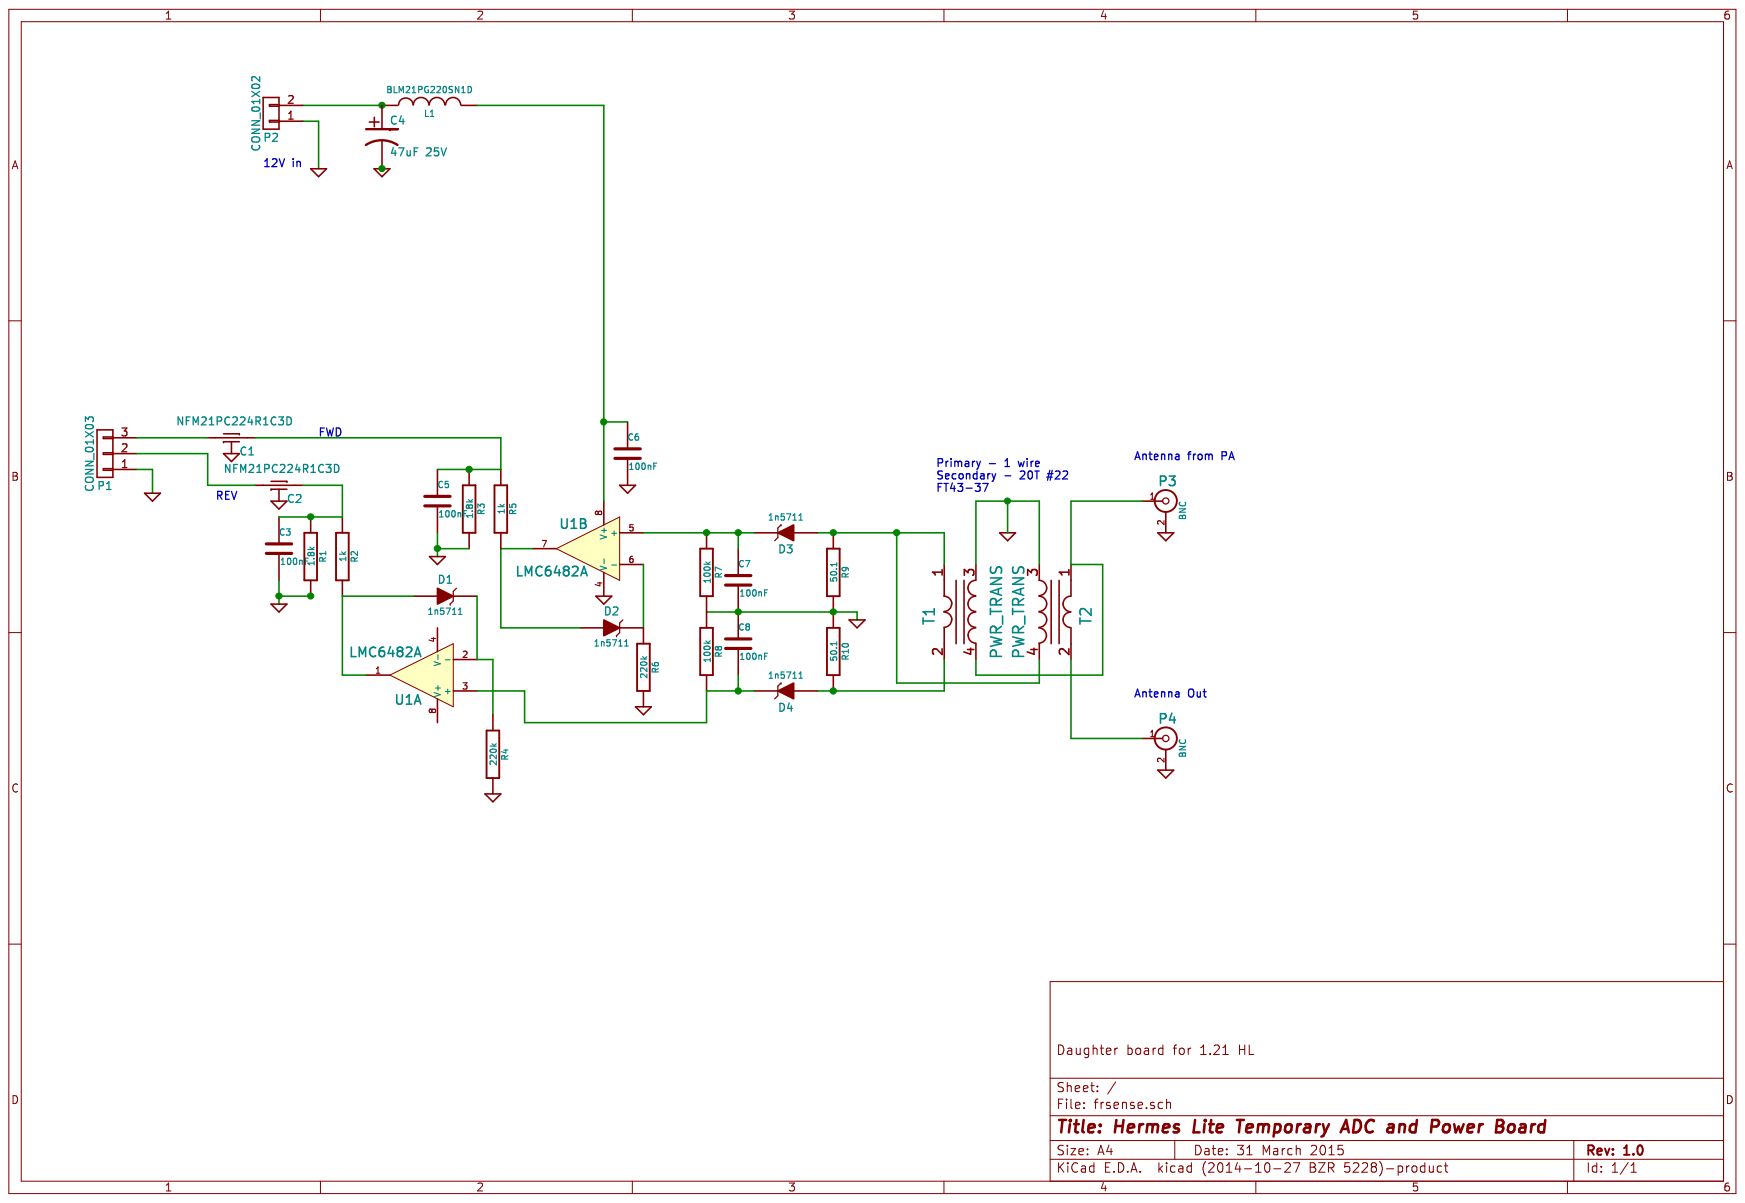
[picture p14: page 1]
