W9JSW/Hermes-Lite/frontend/v2-Amp/Pre-V2 5W Power Amplifier V1.1.pdf

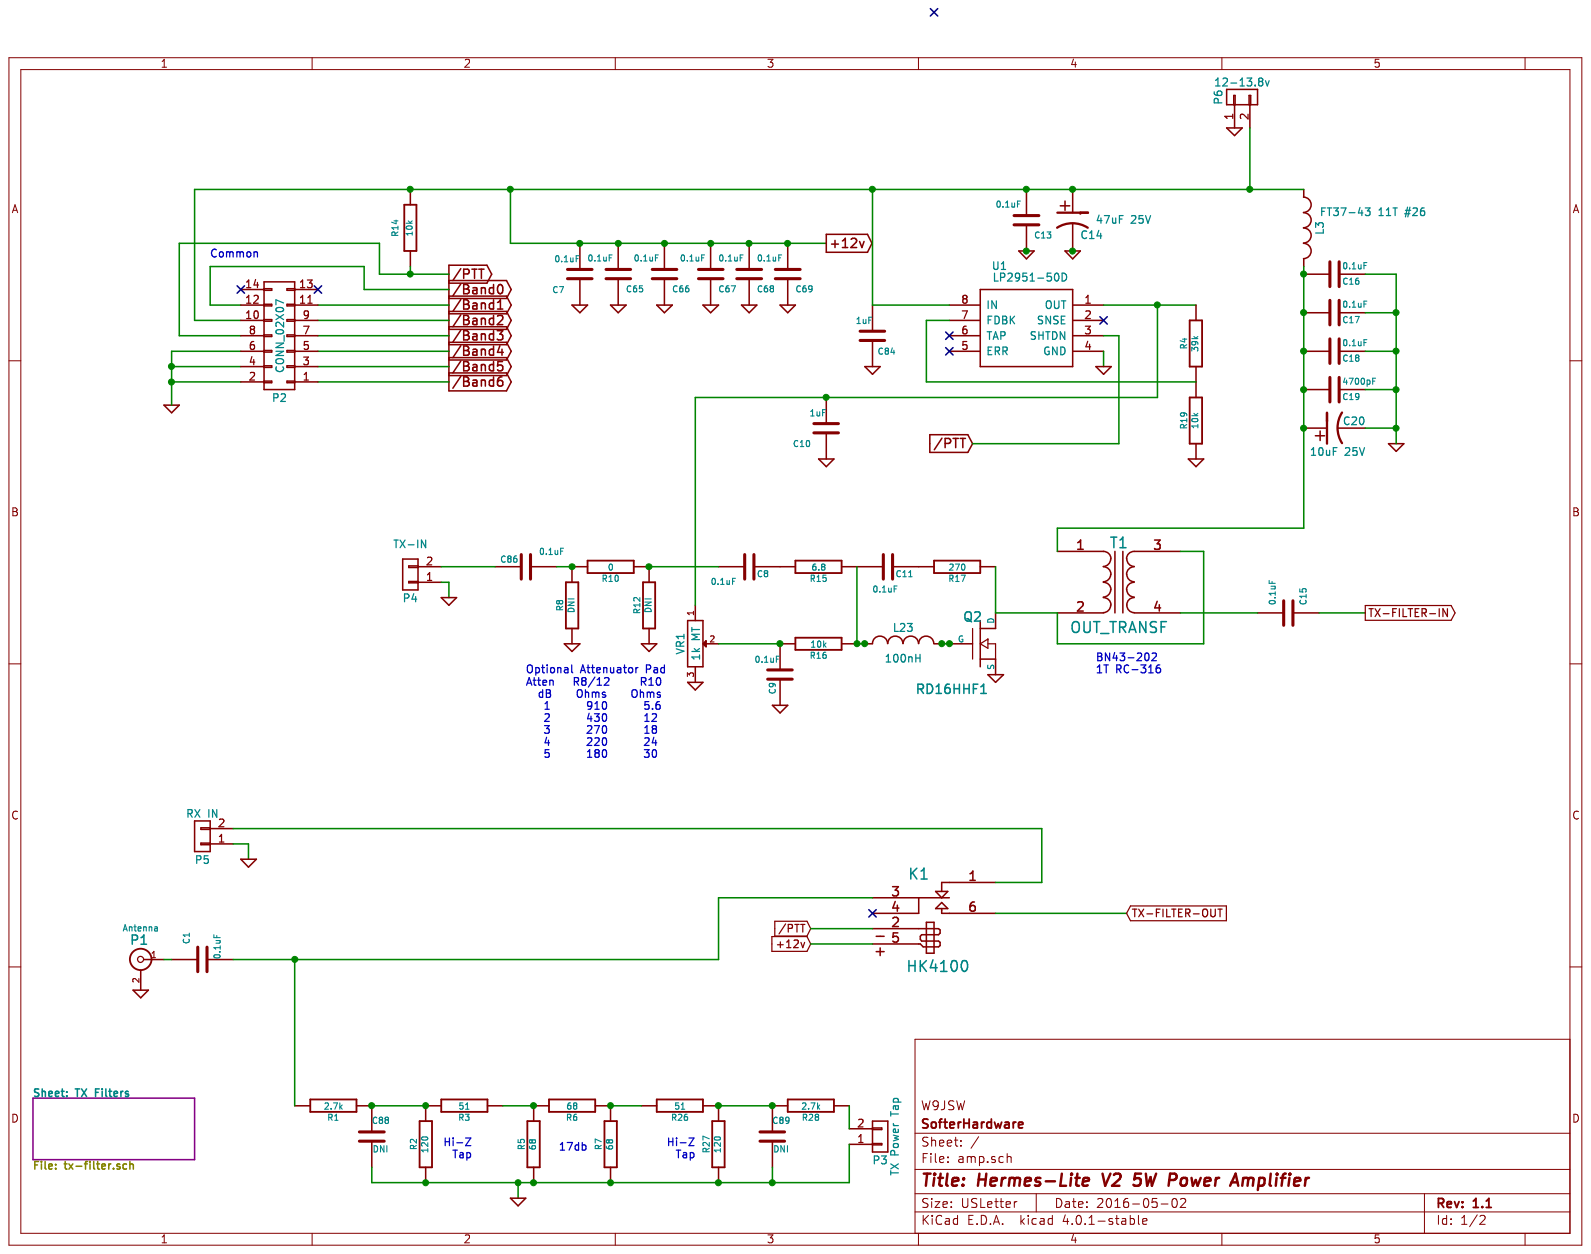
[picture p15: page 1]

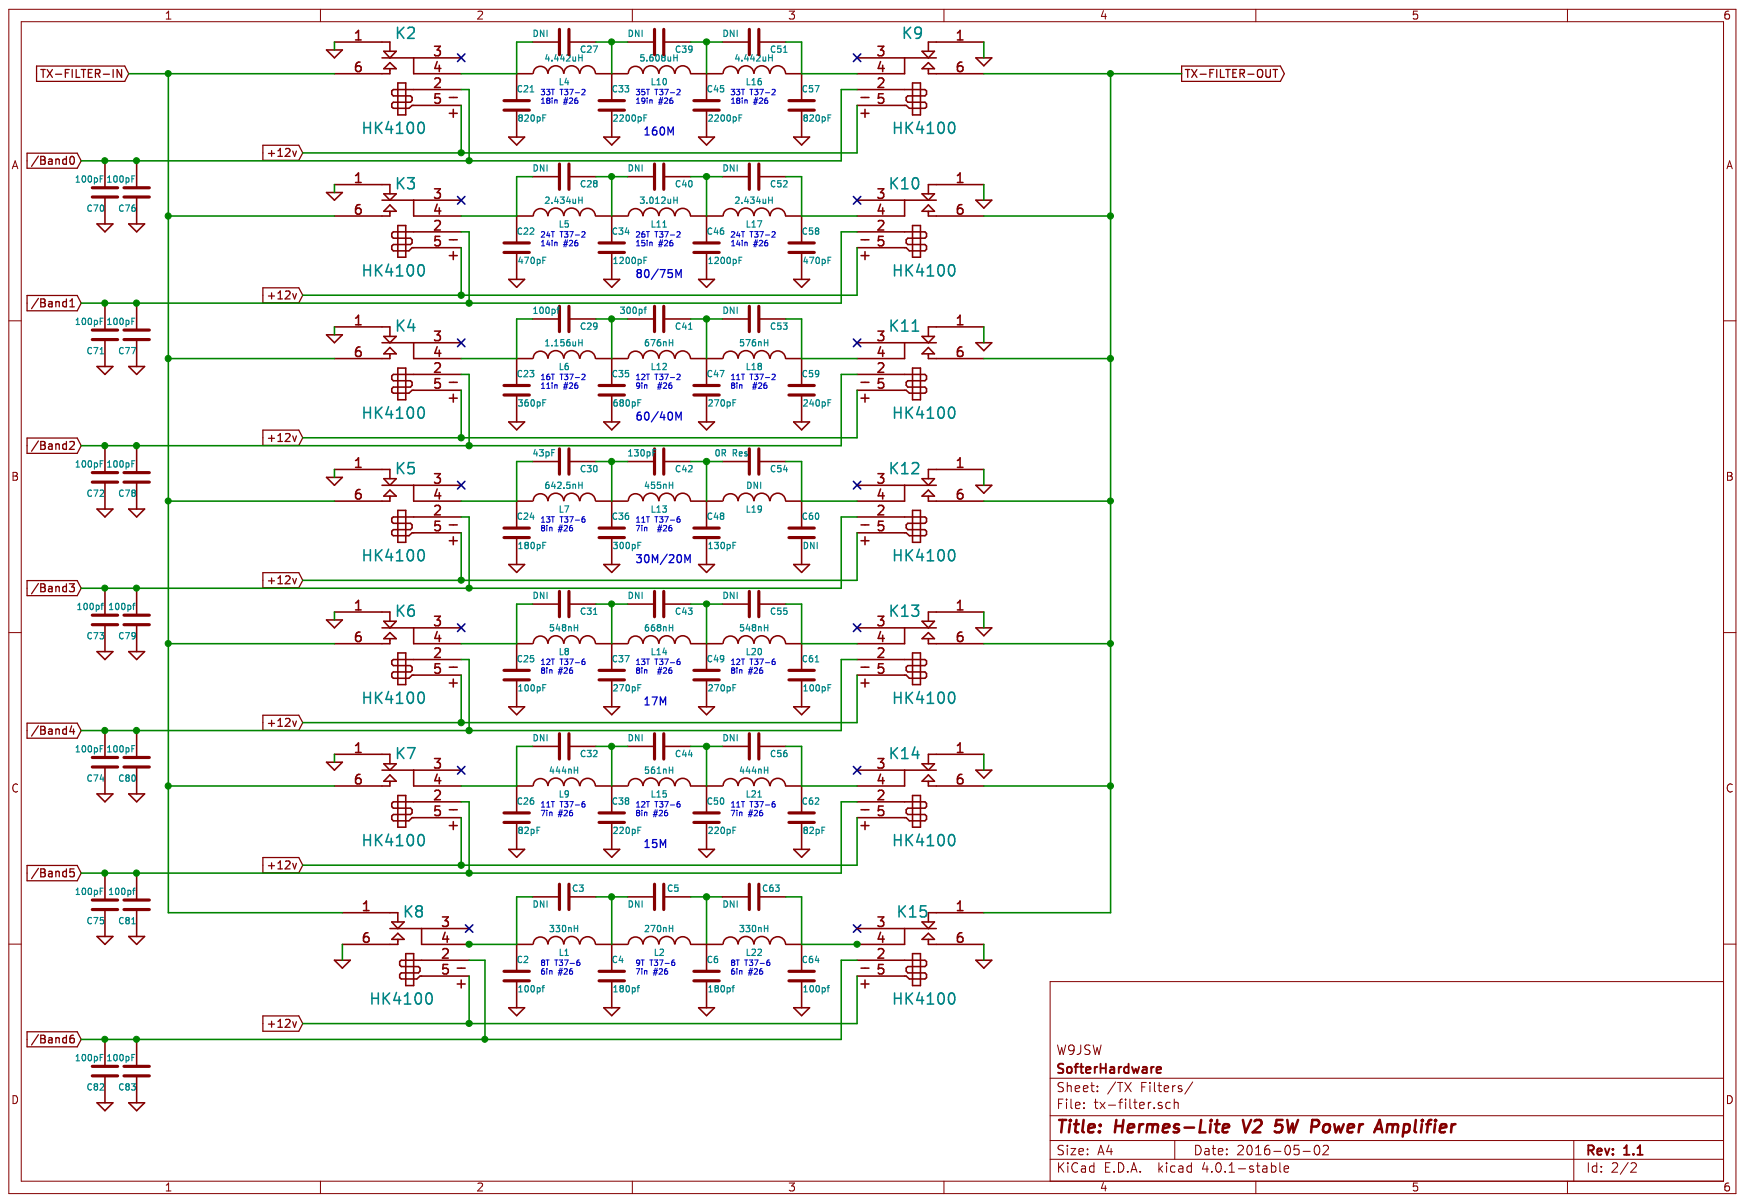
[picture p16: page 2]
