W9JSW/Hermes-Lite/frontend/v2-PushPull-Amp/Pre-V2 10W Push-Pull Power Amplifier V1.0.pdf

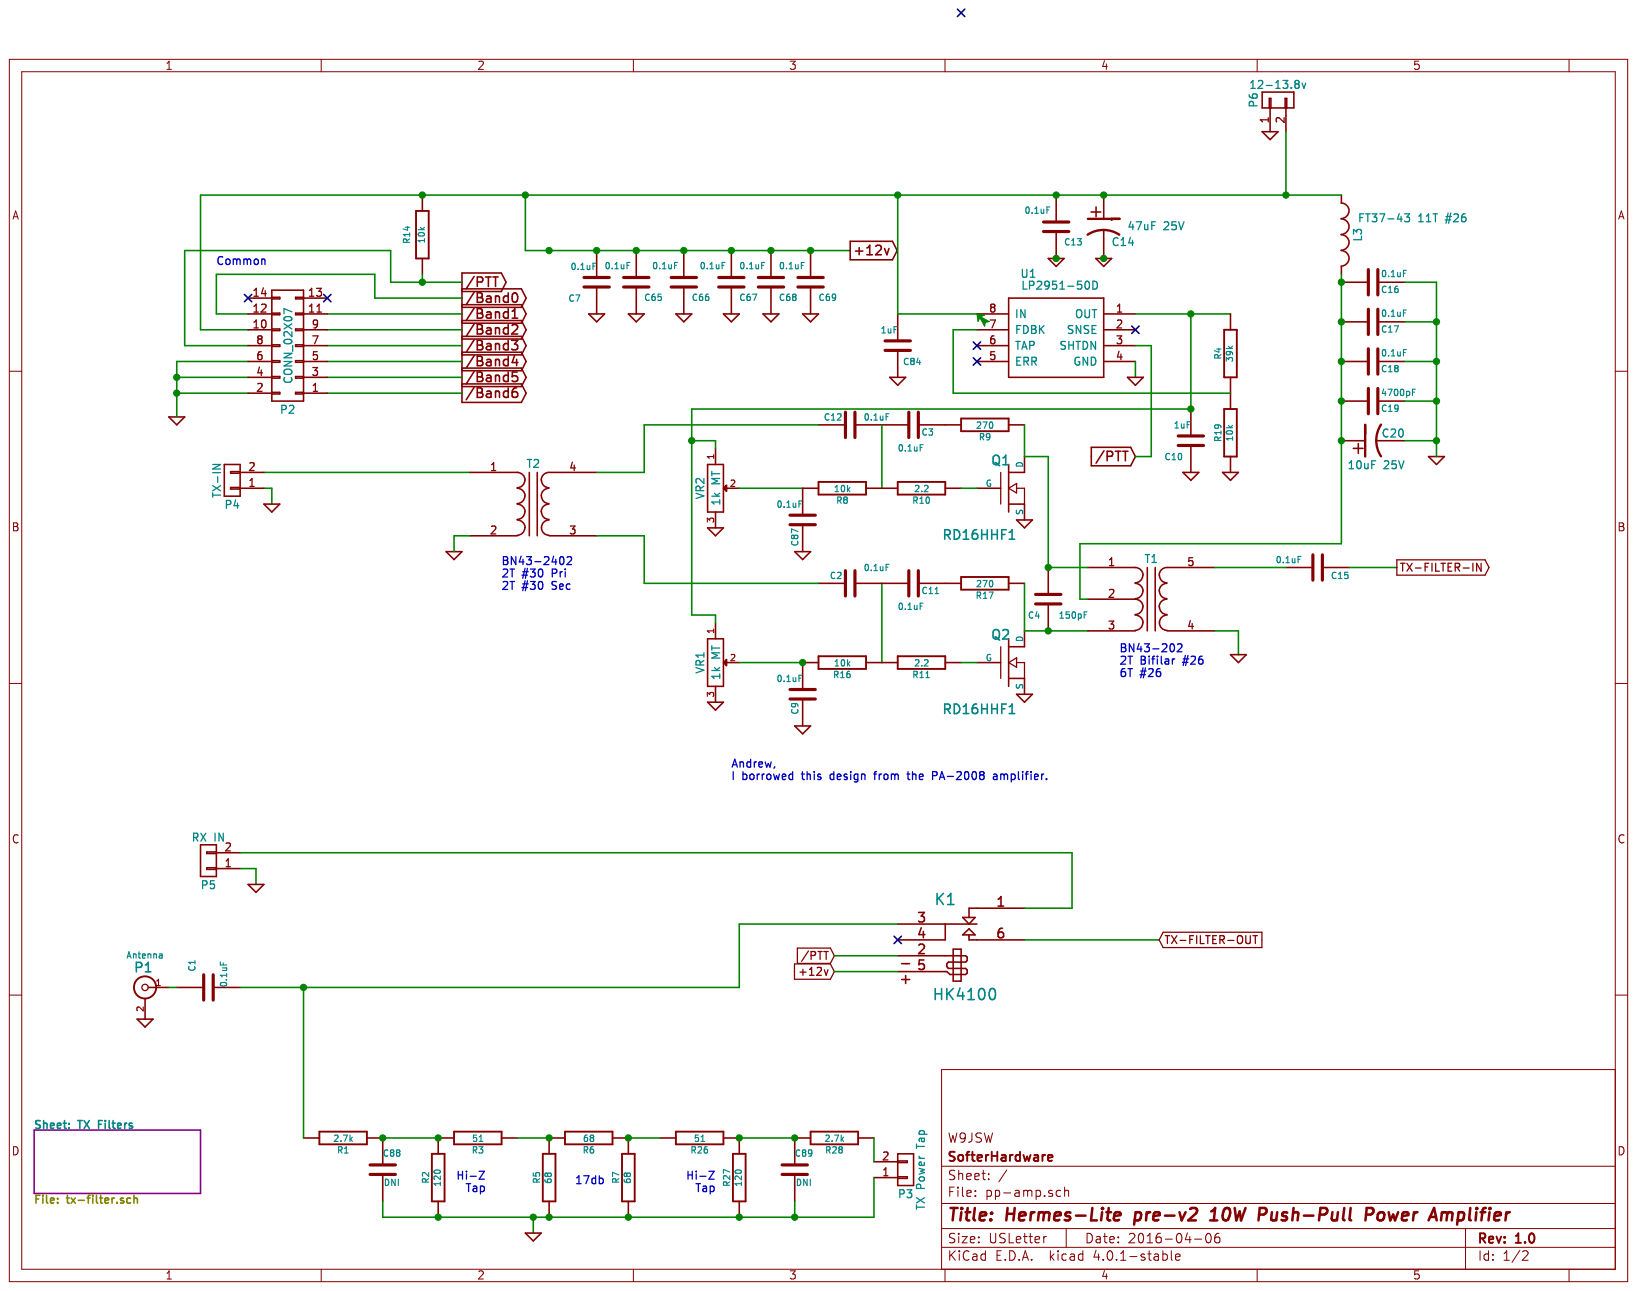
[picture p17: page 1]

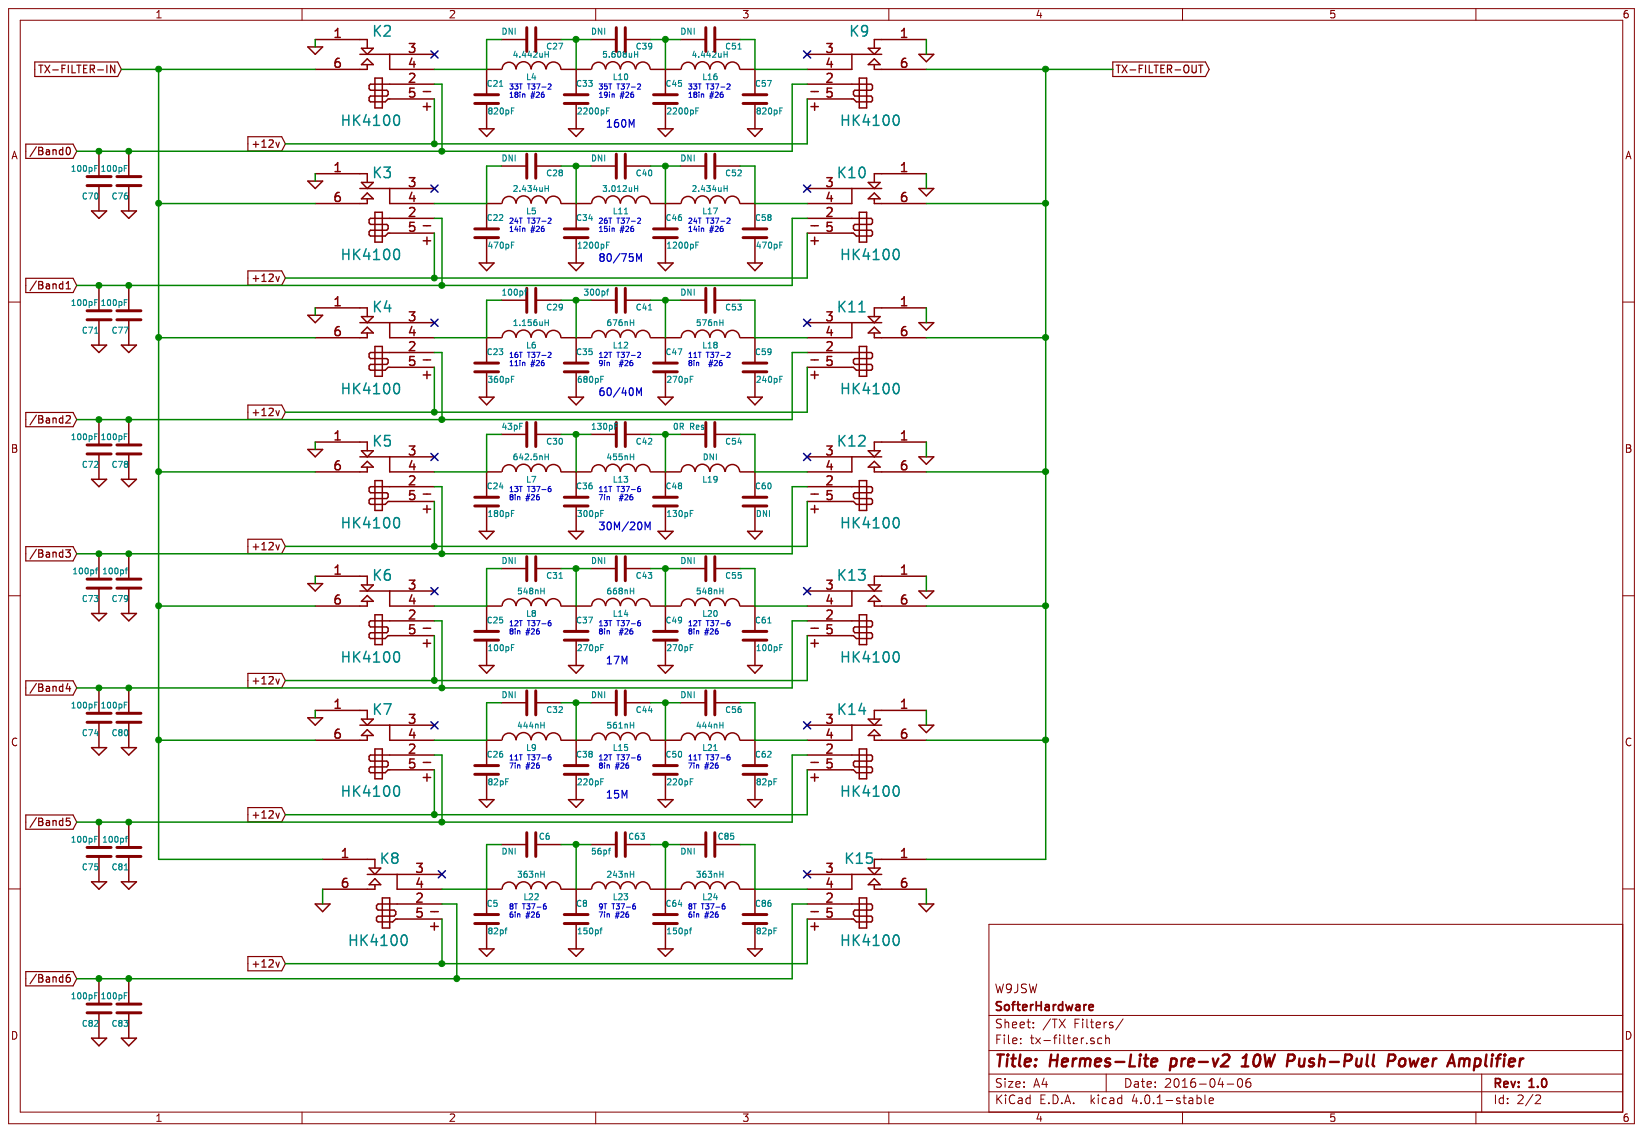
[picture p18: page 2]
