W9JSW/Hermes-Lite/frontend/v2-RX-Filter/pre-V2 RX Filter Board v1.0.pdf

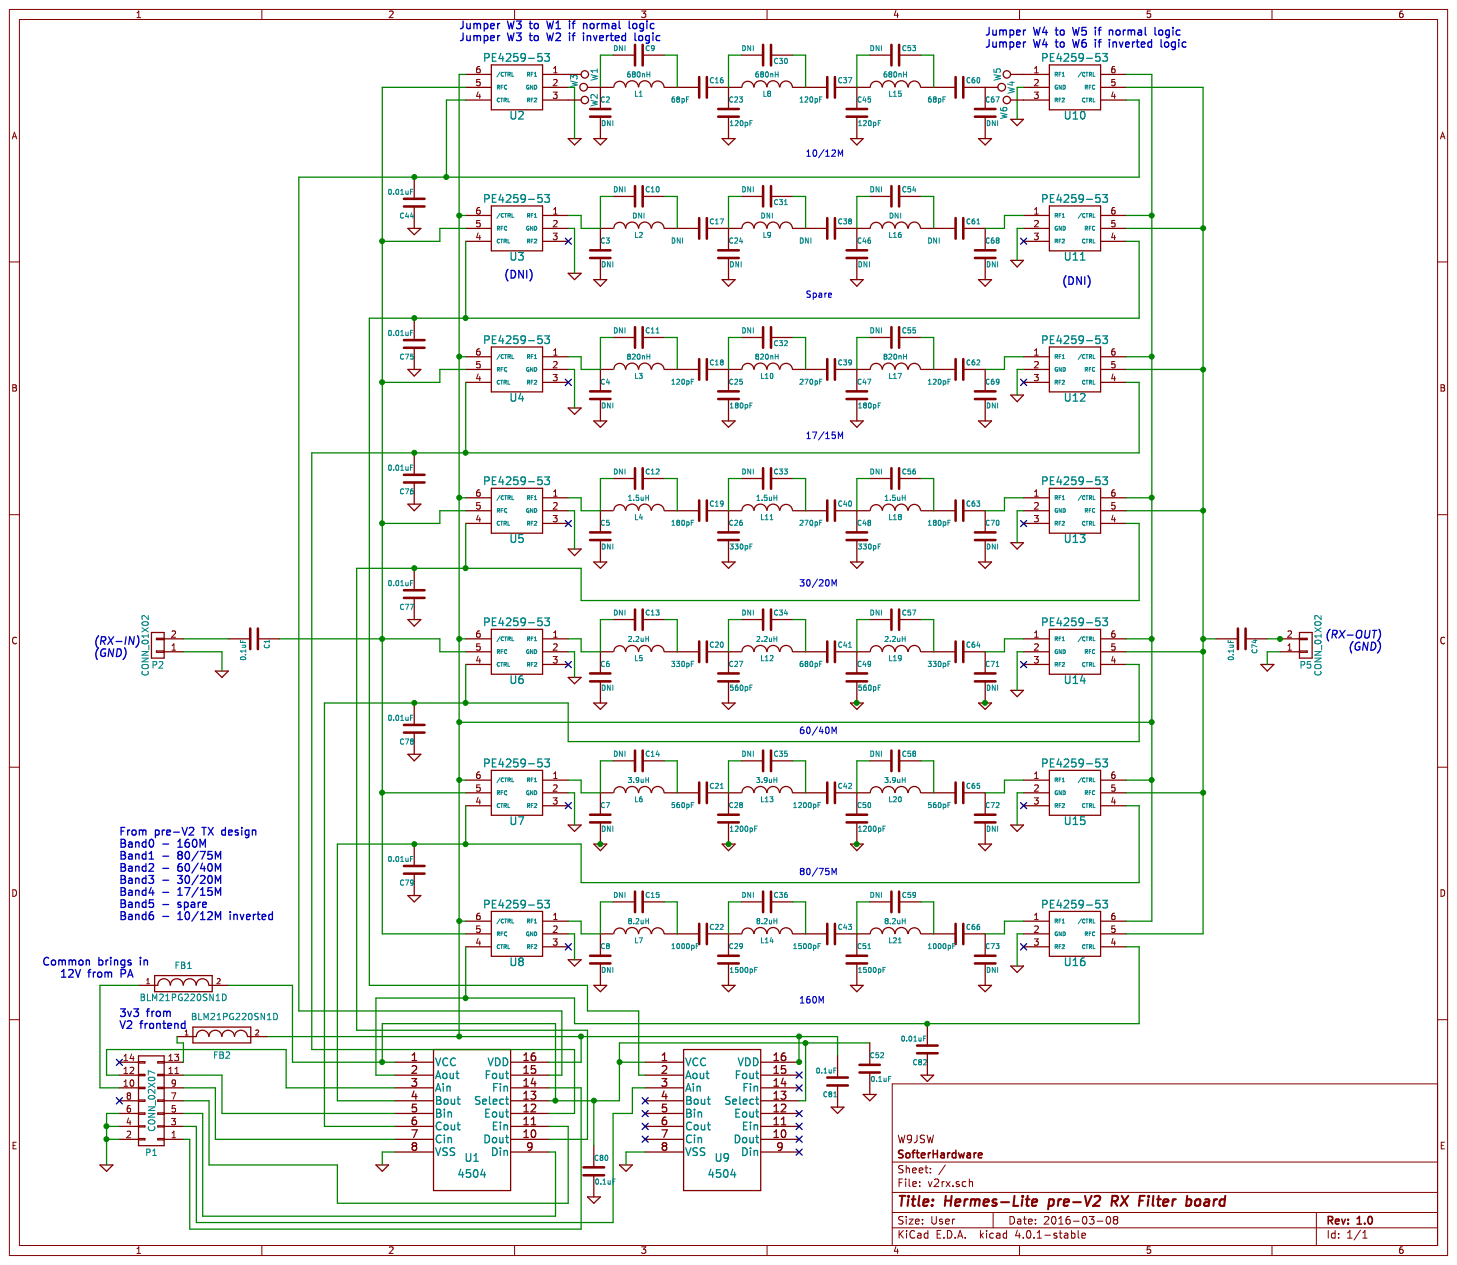
[picture p19: page 1]
