W9JSW/Hermes-Lite/frontend/BPF Superband/RF Frontend - Basic Superband 5W Power Amplifier V1.3.pdf

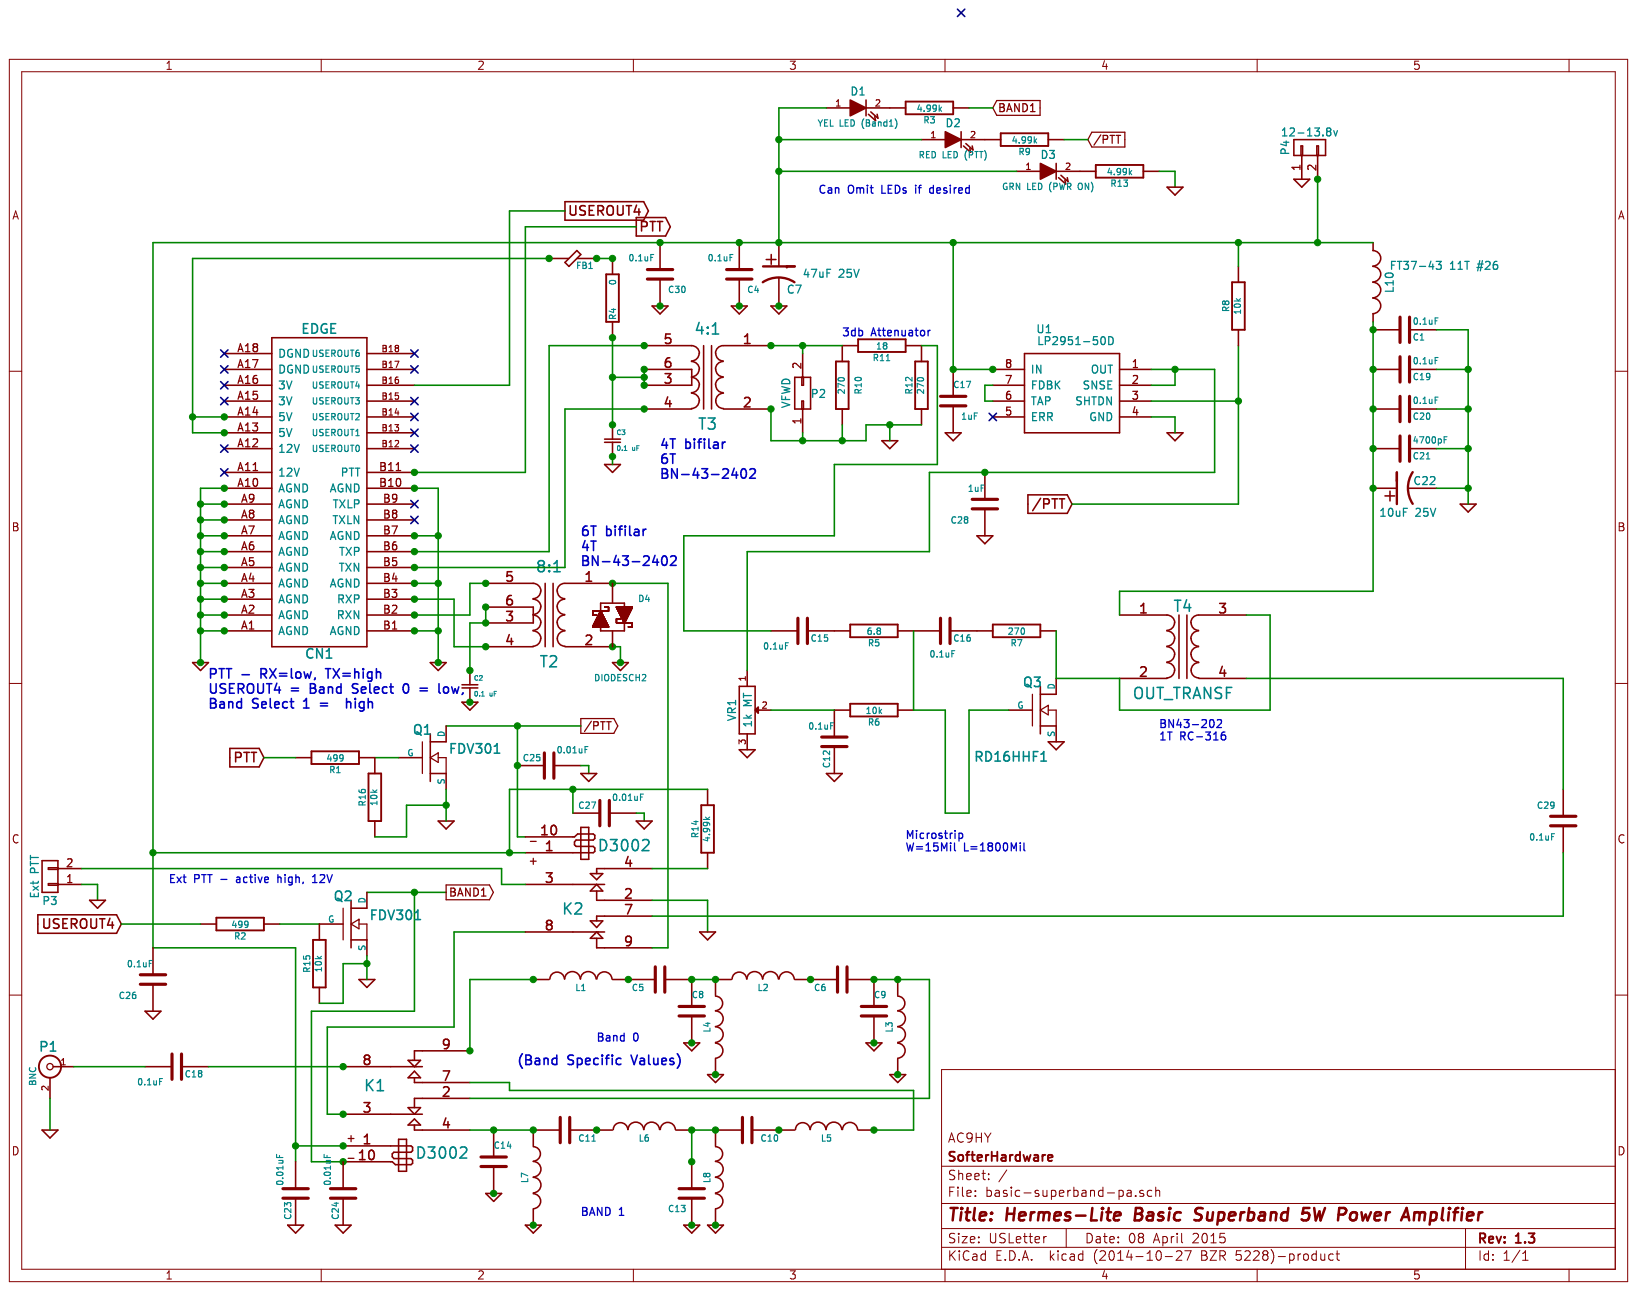
[picture p20: page 1]
