W9JSW/Hermes-Lite/frontend/BPF Superband/10-12-sharper-plot-rev2.pdf

## 12m/10m sharper shoulders Rev 2

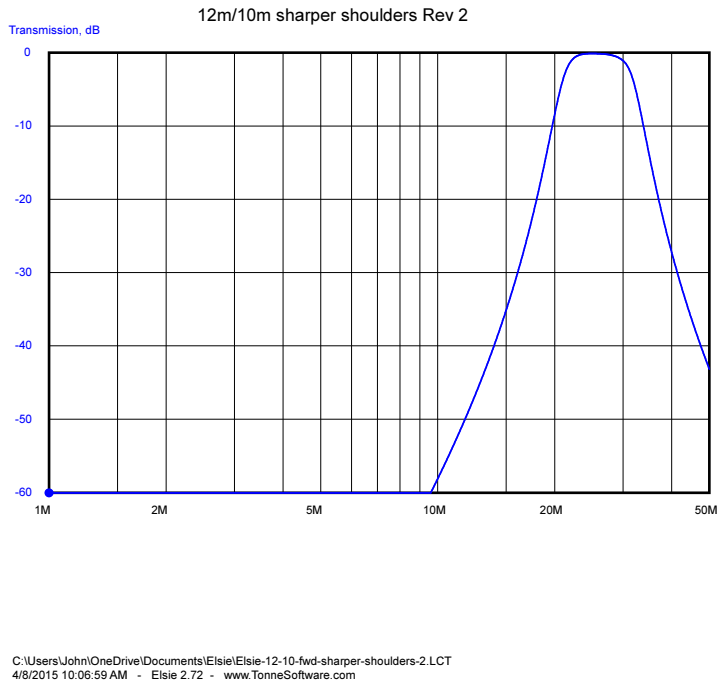
[picture p21: page 1]
Transmission, dB

C:\Users\John\OneDrive\Documents\Elsie\Elsie-12-10-fwd-sharper-shoulders-2.LCT
4/8/2015 10:06:59 AM - Elsie 2.72 - www.TonneSoftware.com
