W9JSW/Hermes-Lite/frontend/BPF Superband/10-12-sharper-plot.pdf

## 12m/10m sharper shoulders

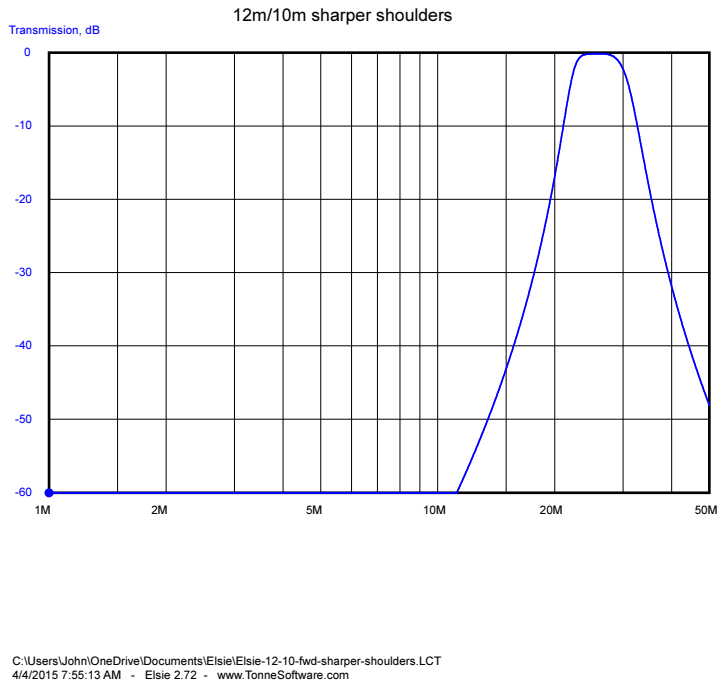
[picture p22: page 1]
Transmission, dB

C:\Users\John\OneDrive\Documents\Elsie\Elsie-12-10-fwd-sharper-shoulders.LCT
4/4/2015 7:55:13 AM - Elsie 2.72 - www.TonneSoftware.com
