W9JSW/Hermes-Lite/frontend/BPF Superband/30 MHz Filter Plot rev 2.pdf

### 30Mz Low Pass

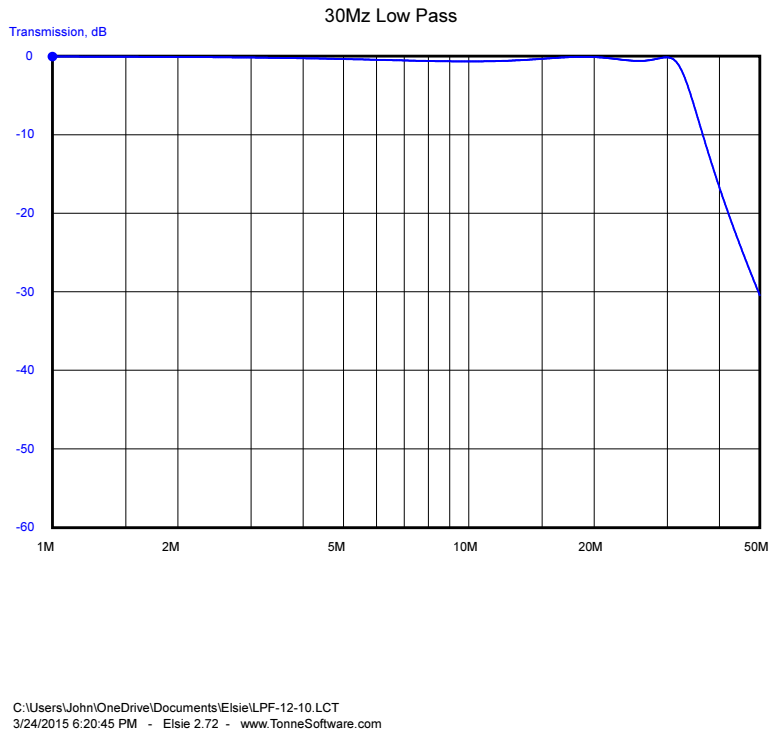
[picture p23: page 1]
Transmission, dB

C:\Users\John\OneDrive\Documents\Elsie\LPF-12-10.LCT
3/24/2015 6:20:45 PM - Elsie 2.72 - www.TonneSoftware.com
