W9JSW/Hermes-Lite/frontend/BPF Superband/30 MHz Filter Plot.pdf

### 30 MHz Low Pass

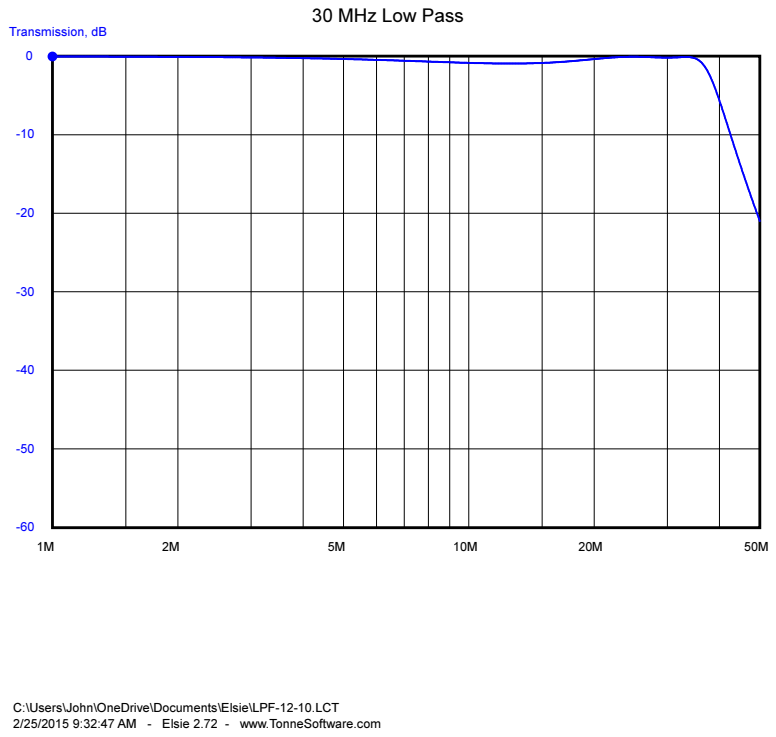
[picture p24: page 1]
Transmission, dB

C:\Users\John\OneDrive\Documents\Elsie\LPF-12-10.LCT
2/25/2015 9:32:47 AM - Elsie 2.72 - www.TonneSoftware.com
