W9JSW/Hermes-Lite/frontend/BPF Superband/all-bands.pdf

## 160m, 80/75m, 60/40m, 30/20m,17/15m and 12/10m Bands Composite View

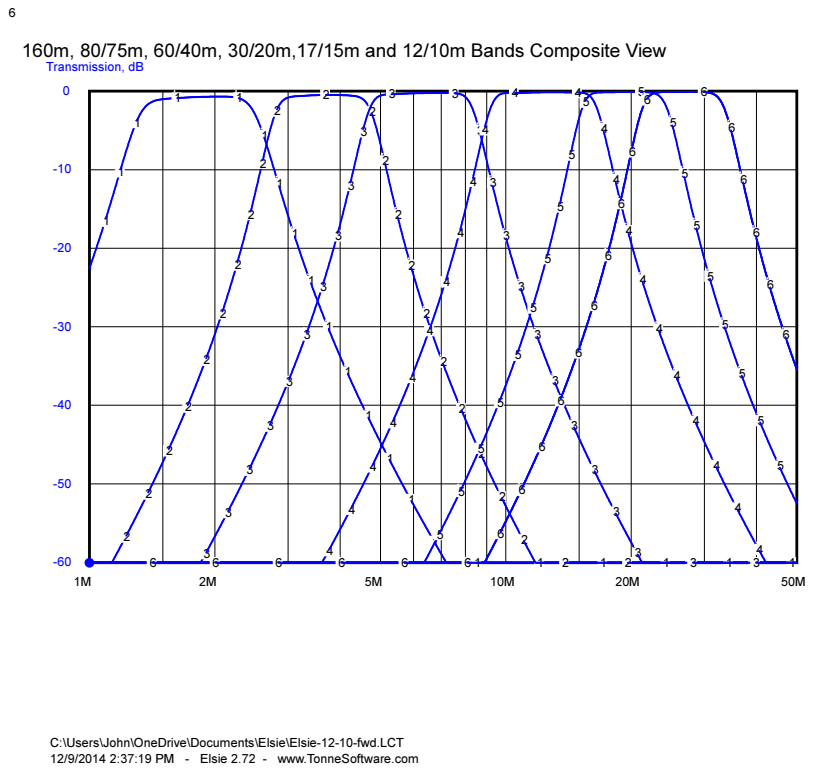
[picture p25: page 1]
Transmission, dB

C:\Users\John\OneDrive\Documents\Elsie\Elsie-12-10-fwd.LCT
12/9/2014 2:37:19 PM - Elsie 2.72 - www.TonneSoftware.com
