W9JSW/Hermes-Lite/frontend/BPF Superband/Elsie-17-15-lpf.pdf

### 17m/15m LPF

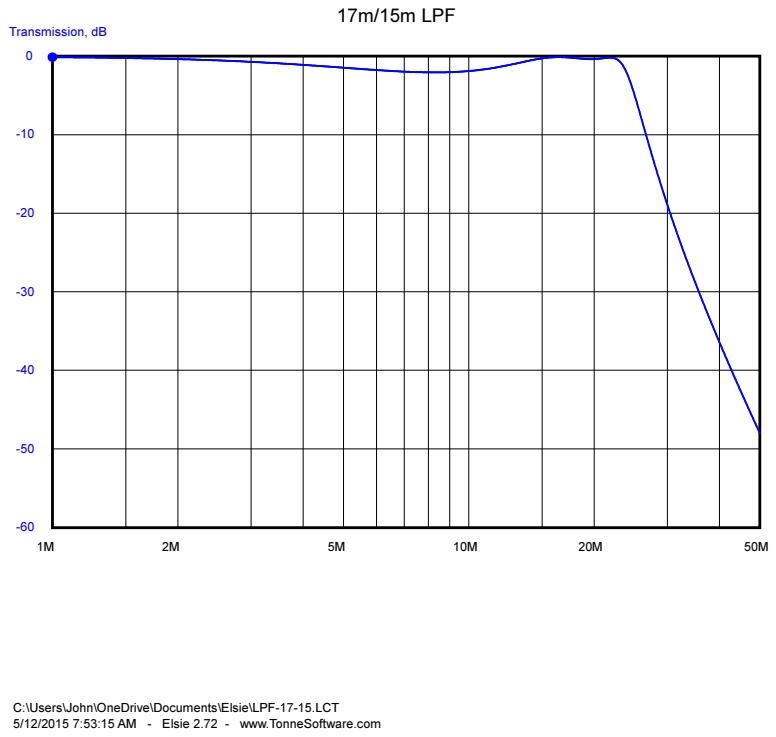
[picture p26: page 1]
Transmission, dB

C:\Users\John\OneDrive\Documents\Elsie\LPF-17-15.LCT
5/12/2015 7:53:15 AM - Elsie 2.72 - www.TonneSoftware.com
