W9JSW/Hermes-Lite/frontend/BPF Superband/Input LPF Plot.pdf

## Input LPF to PA

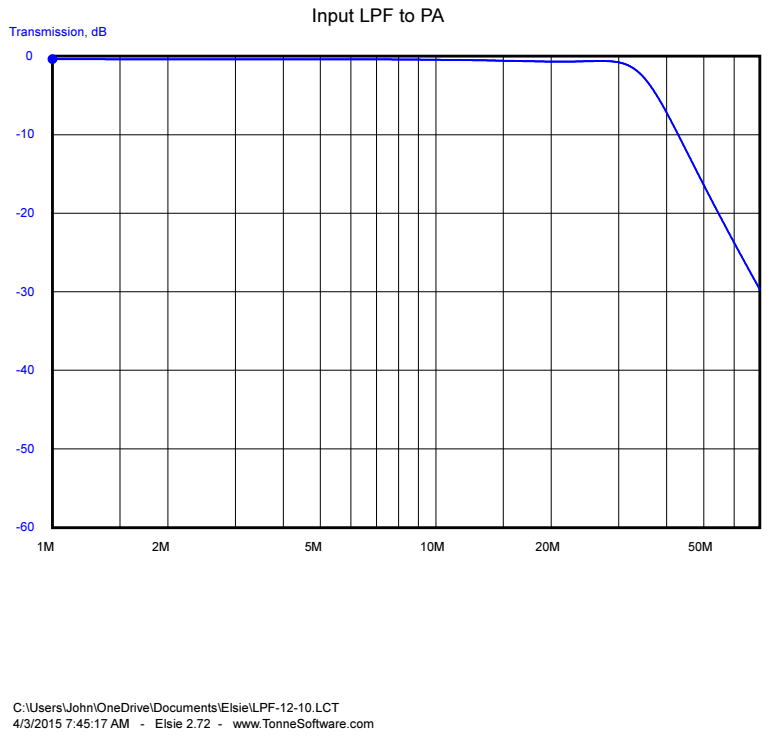
[picture p27: page 1]
Transmission, dB

C:\Users\John\OneDrive\Documents\Elsie\LPF-12-10.LCT
4/3/2015 7:45:17 AM - Elsie 2.72 - www.TonneSoftware.com
