W9JSW/Hermes-Lite/frontend/LPF Superband/RF Frontend - Basic Superband 5W Power Amplifier V1.3.pdf

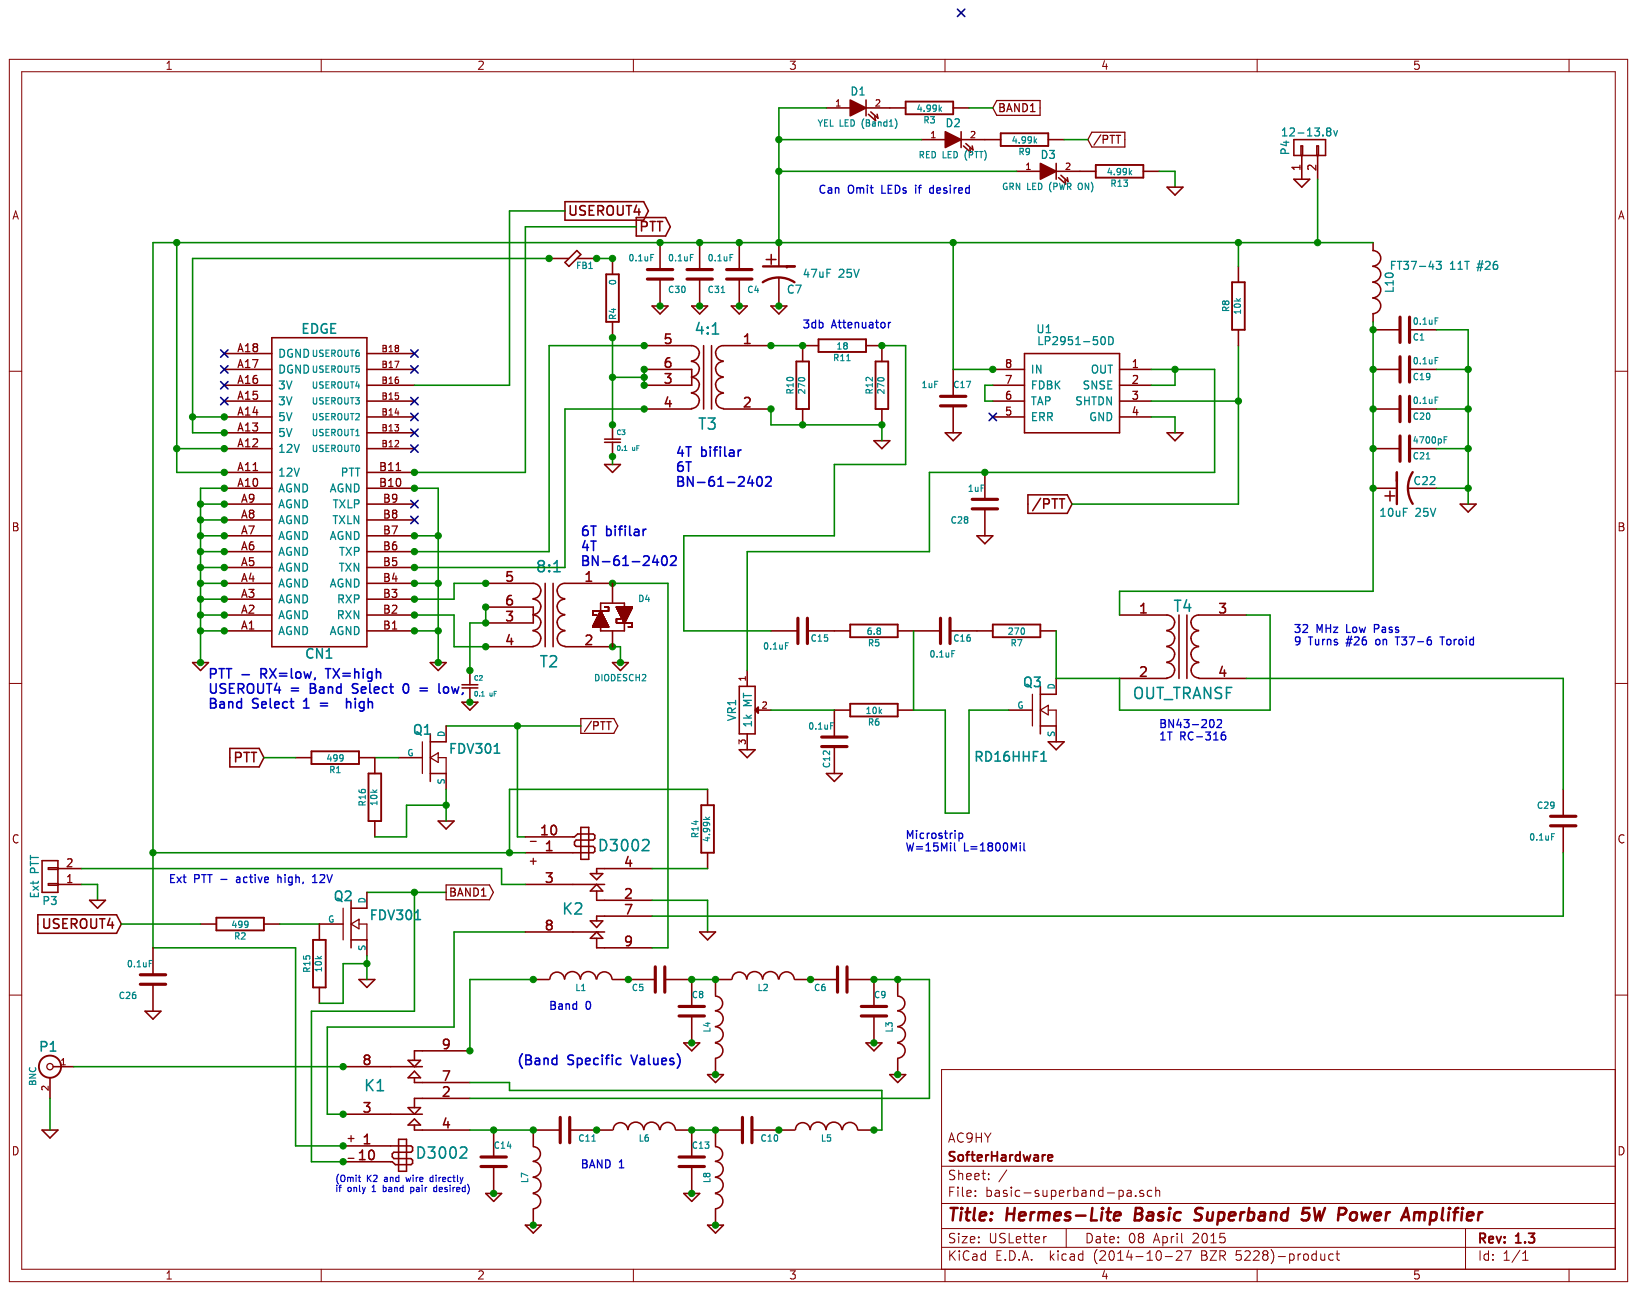
[picture p28: page 1]
