W9JSW/Hermes-Lite/frontend/LPF Superband/RF Frontend - Basic Superband LPF 5W Power Amplifier V1.3.pdf

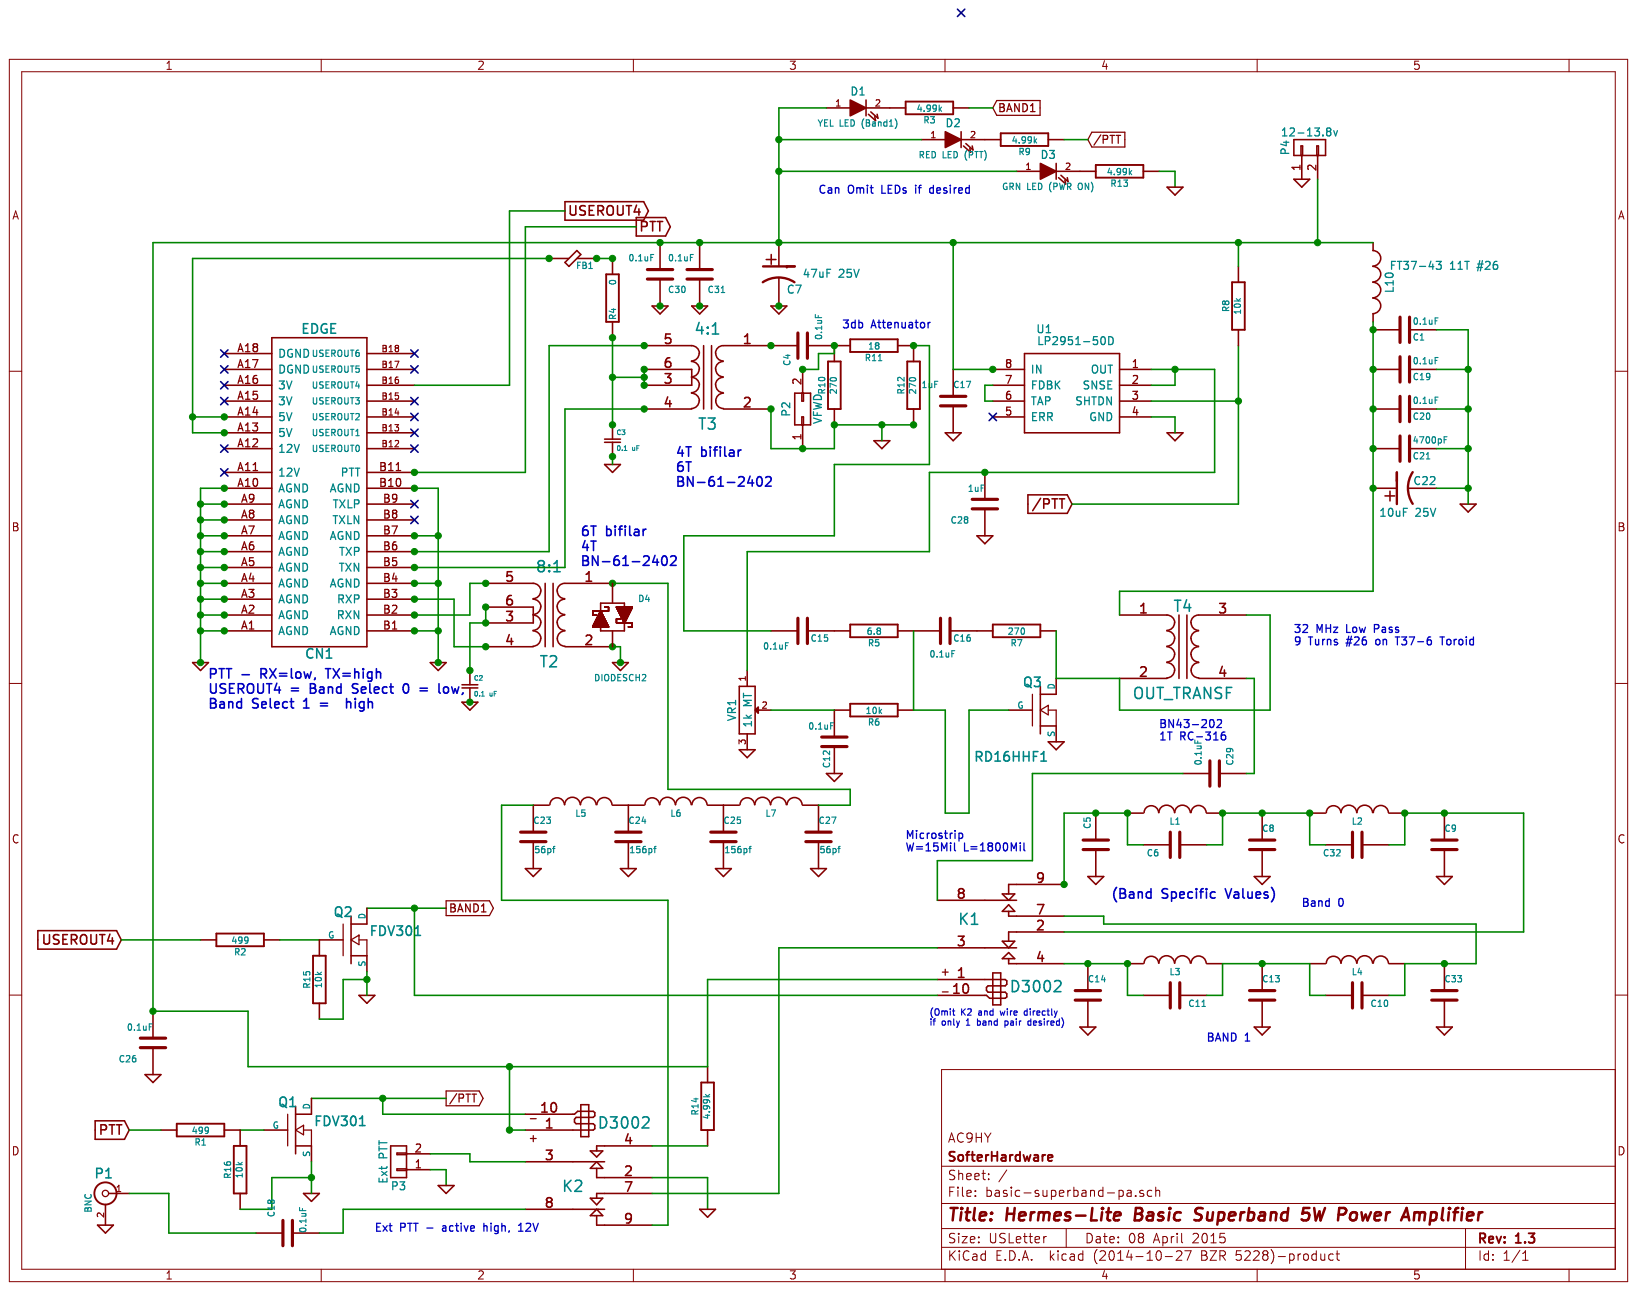
[picture p29: page 1]
