W9JSW/Hermes-Lite/frontend/Megaband-v2/Hermes Lite Megaband2 5W Power Amplifier.pdf

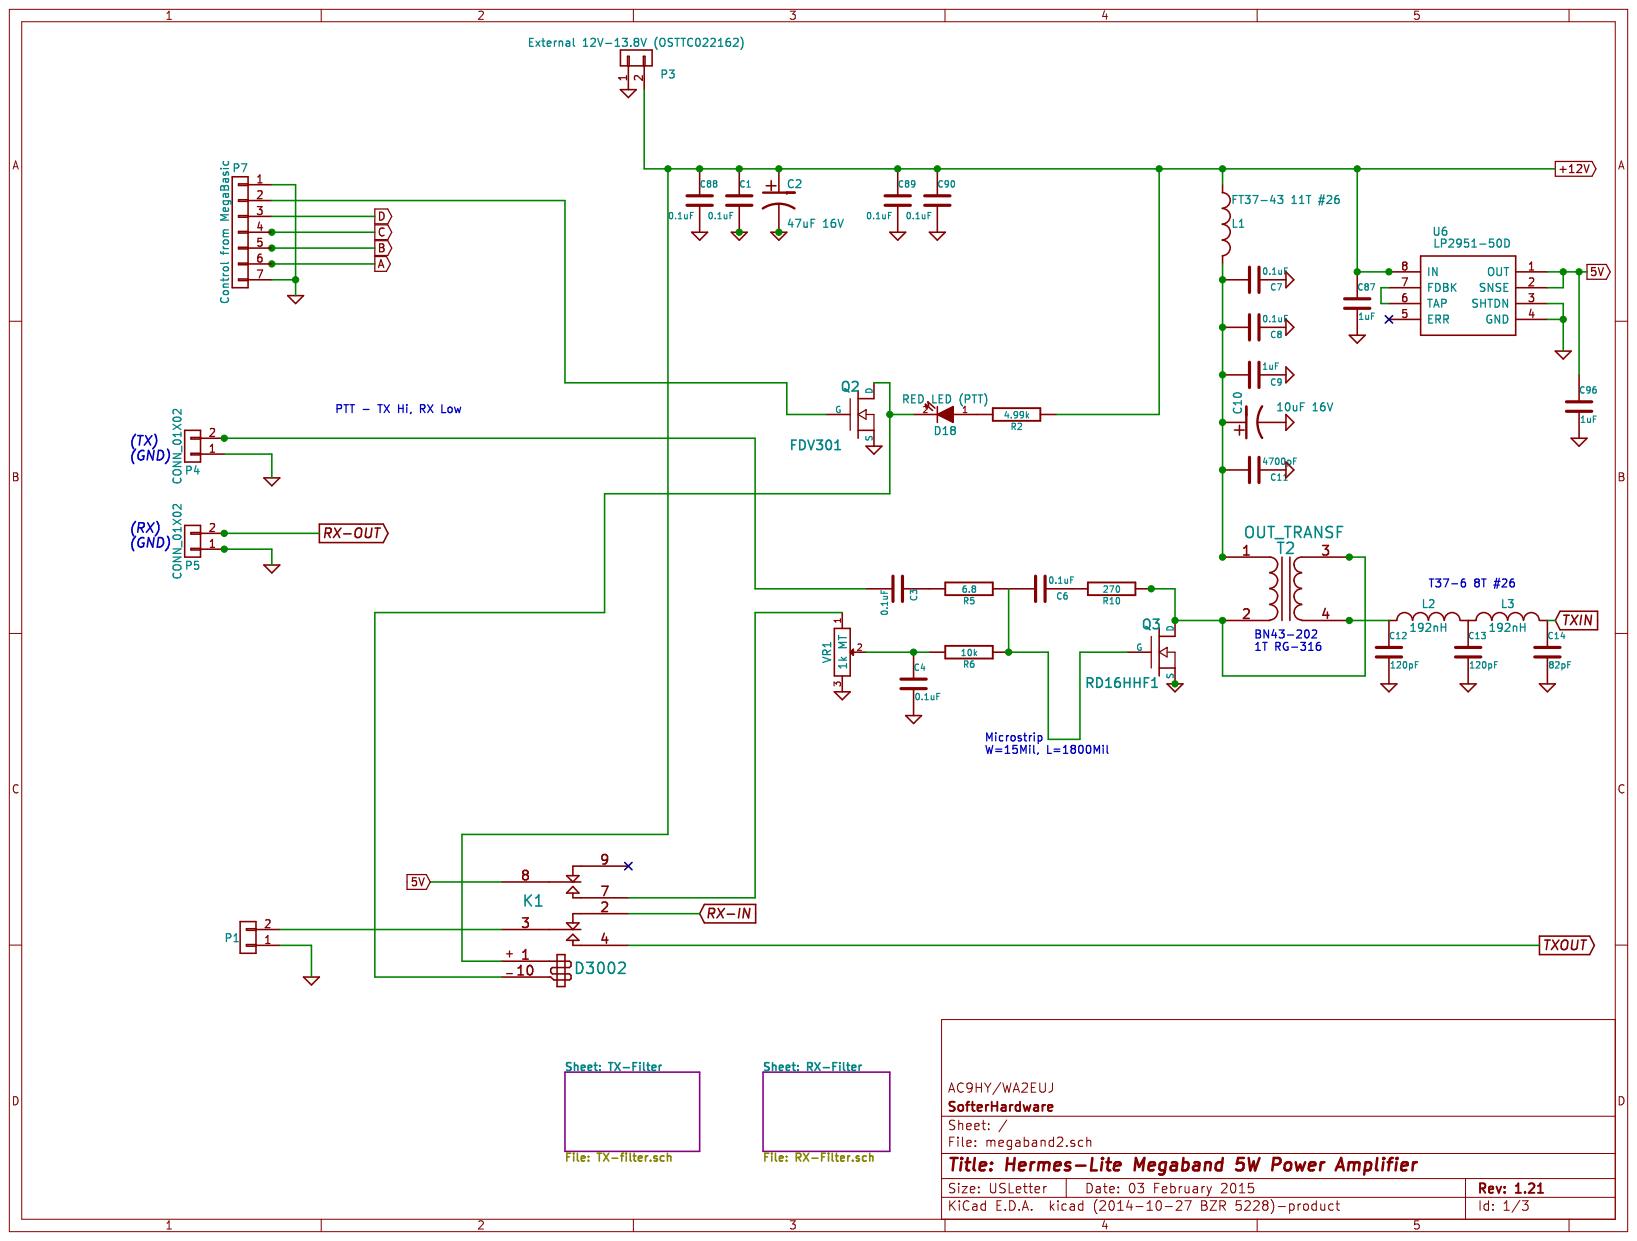
[picture p30: page 1]

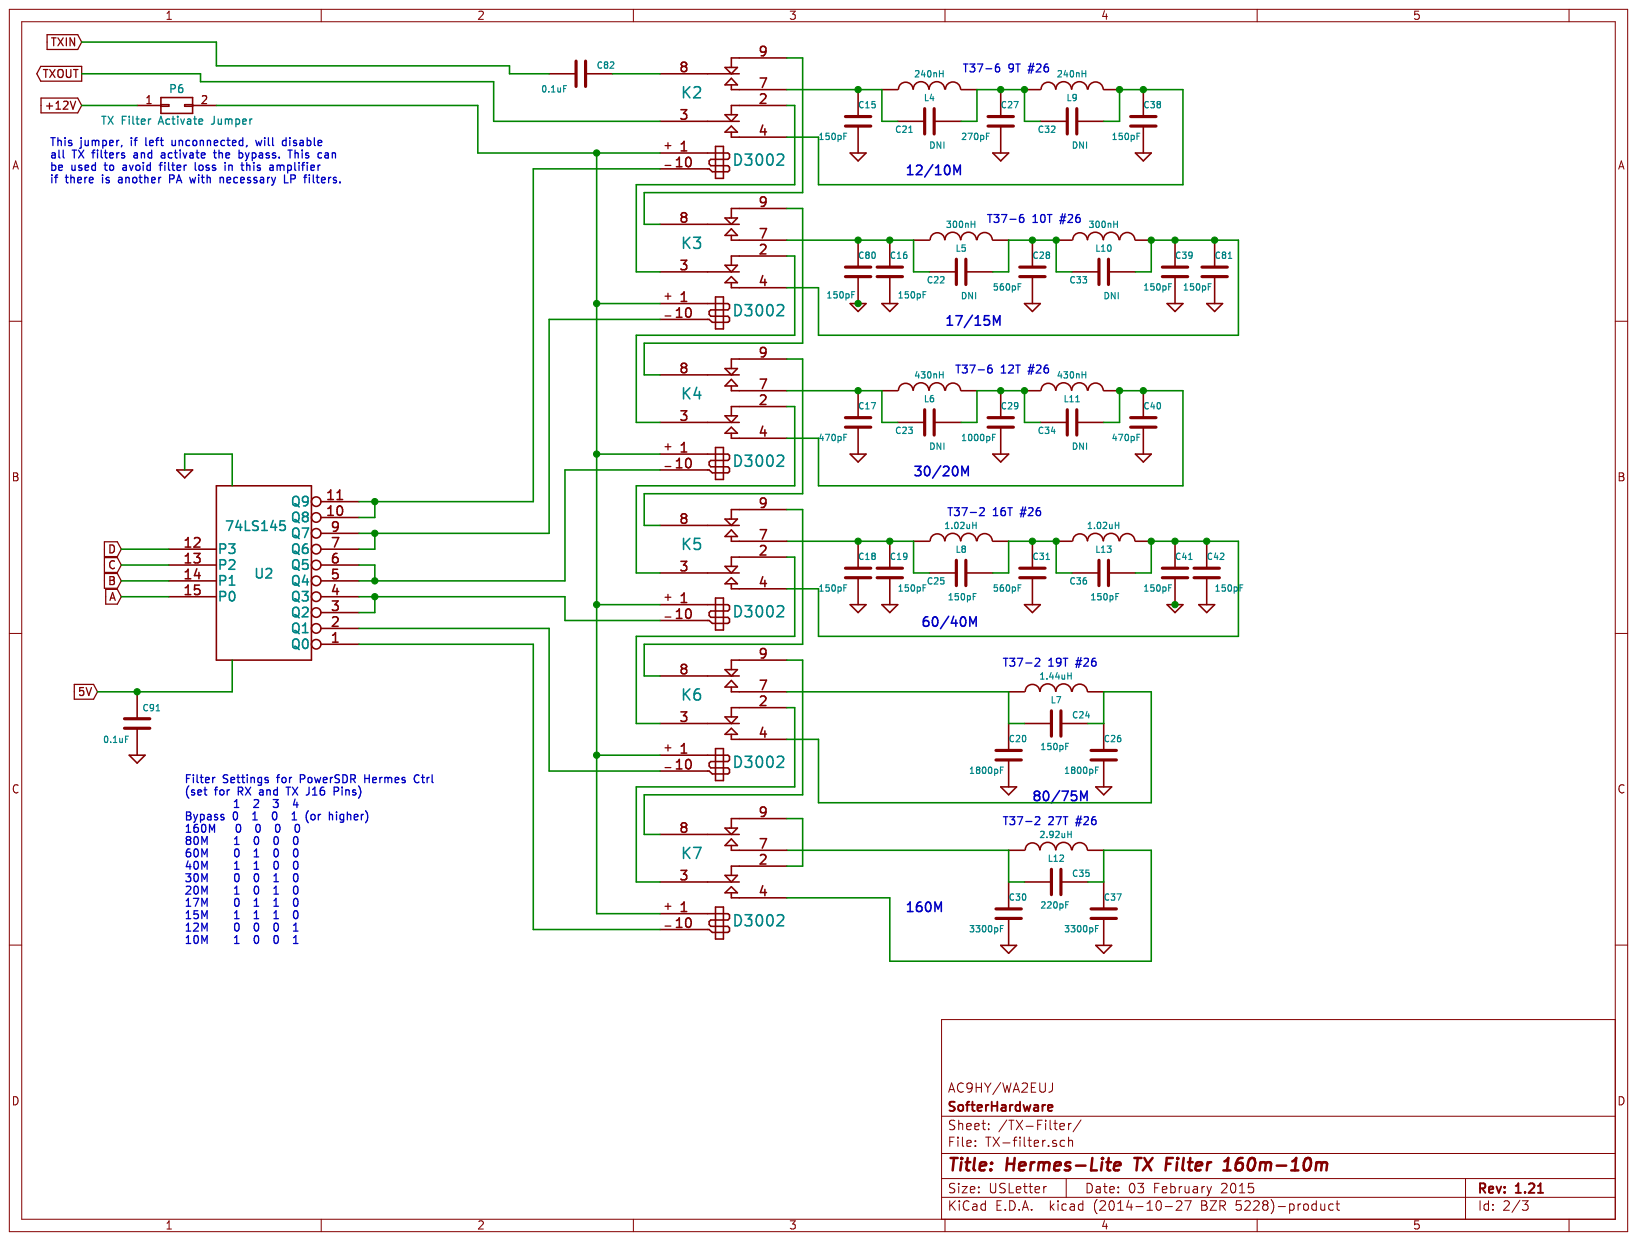
[picture p31: page 2]

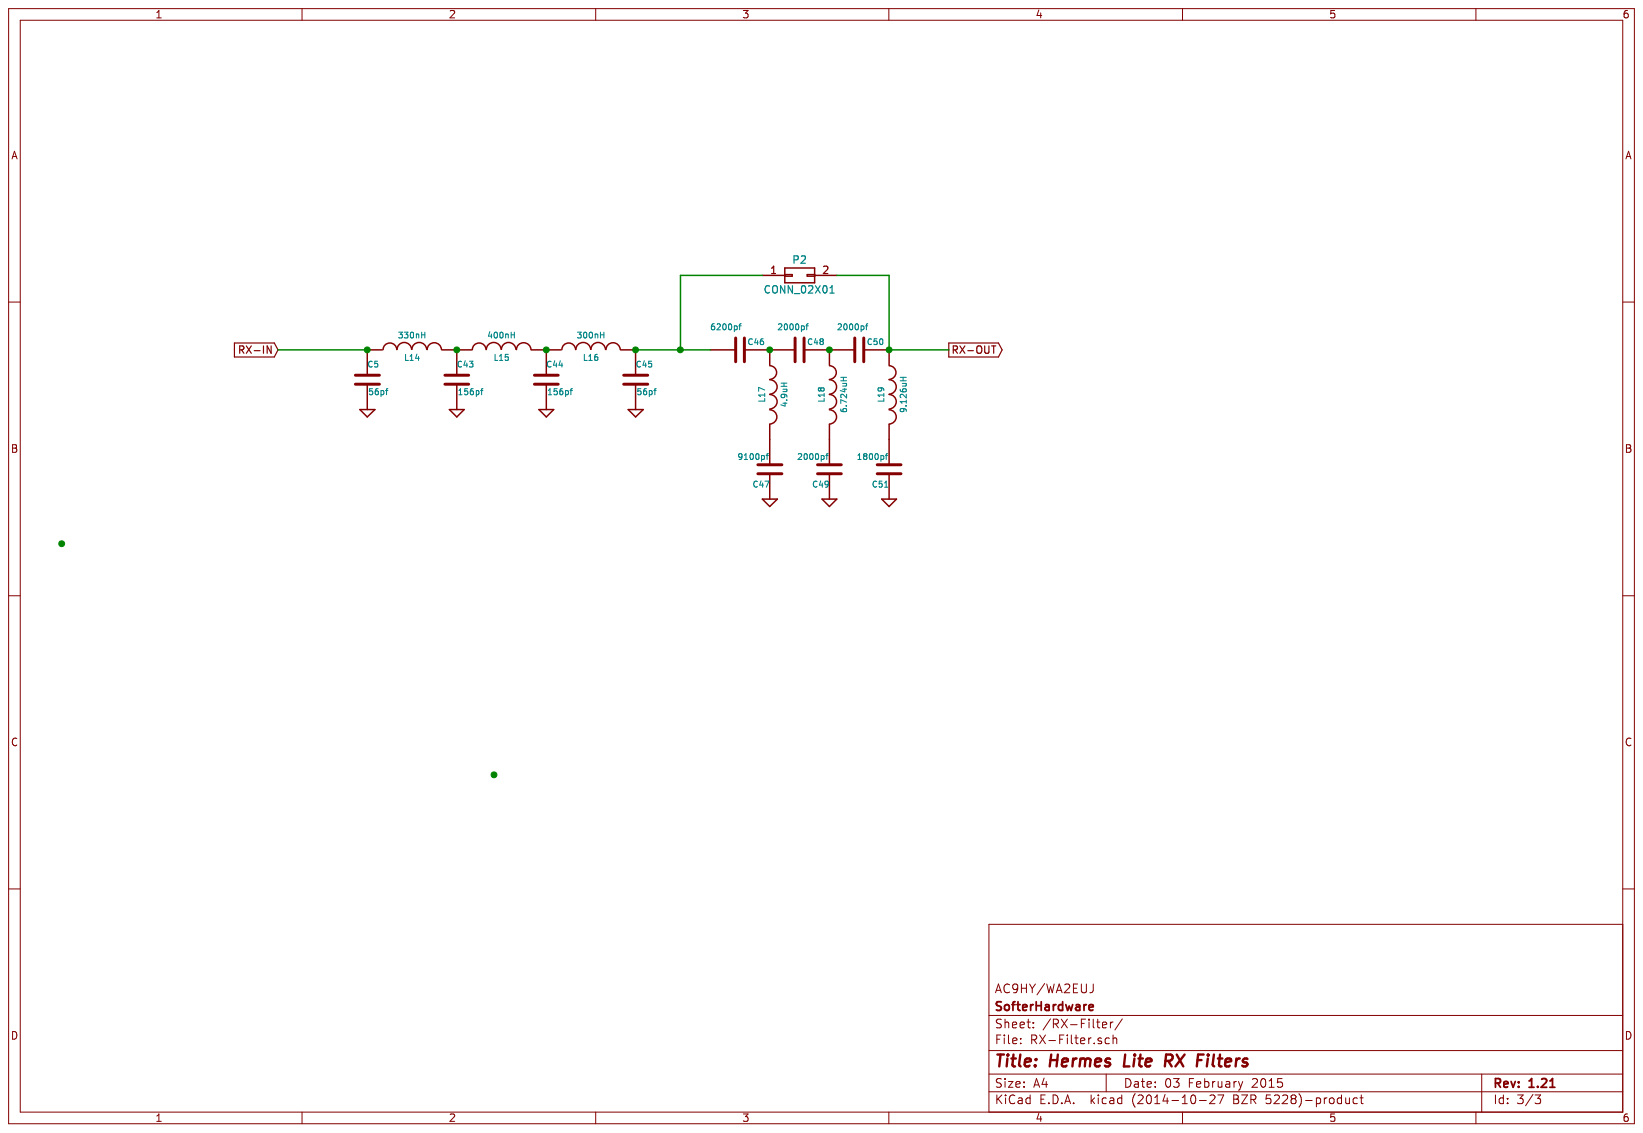
[picture p32: page 3]
