W9JSW/Hermes-Lite/frontend/Megabasic/frontend.pdf

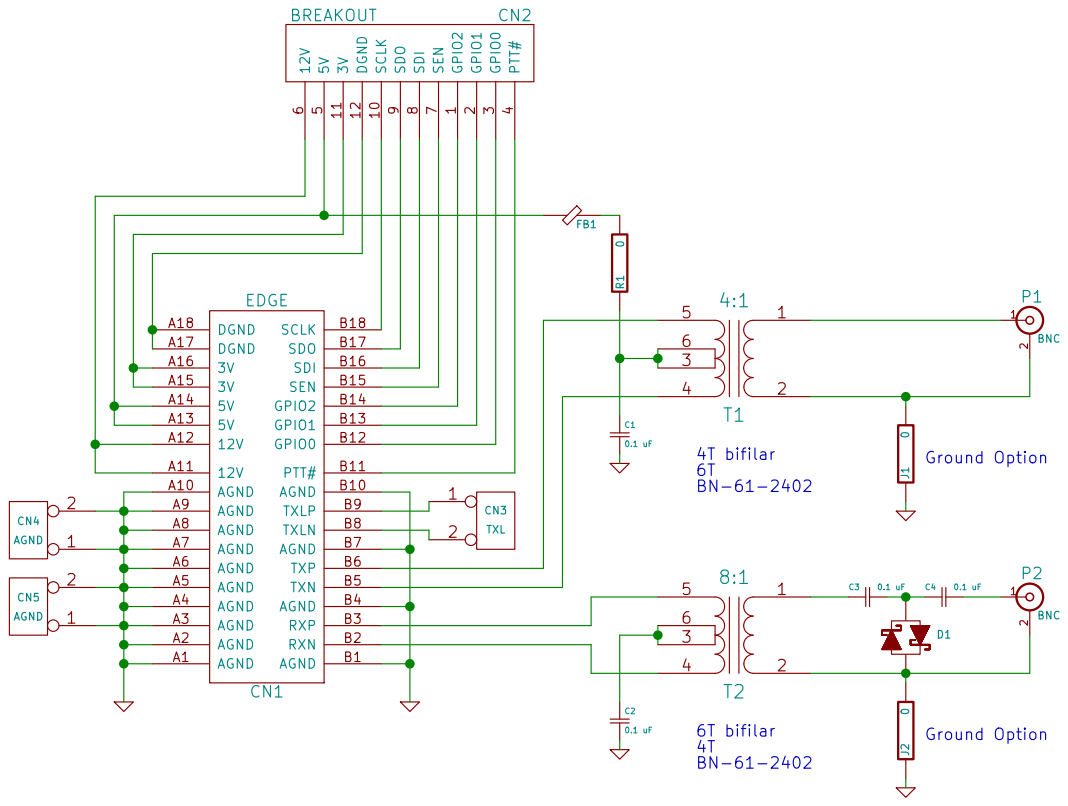
[picture p33: page 1]

File: frontend.sch Sheet: / SofterHardware KF7O

Id: 1/1 Title: Basic Hermes-Lite RF Frontend
