W9JSW/Hermes-Lite/frontend/Megabasic/Megabasic Frontend.pdf

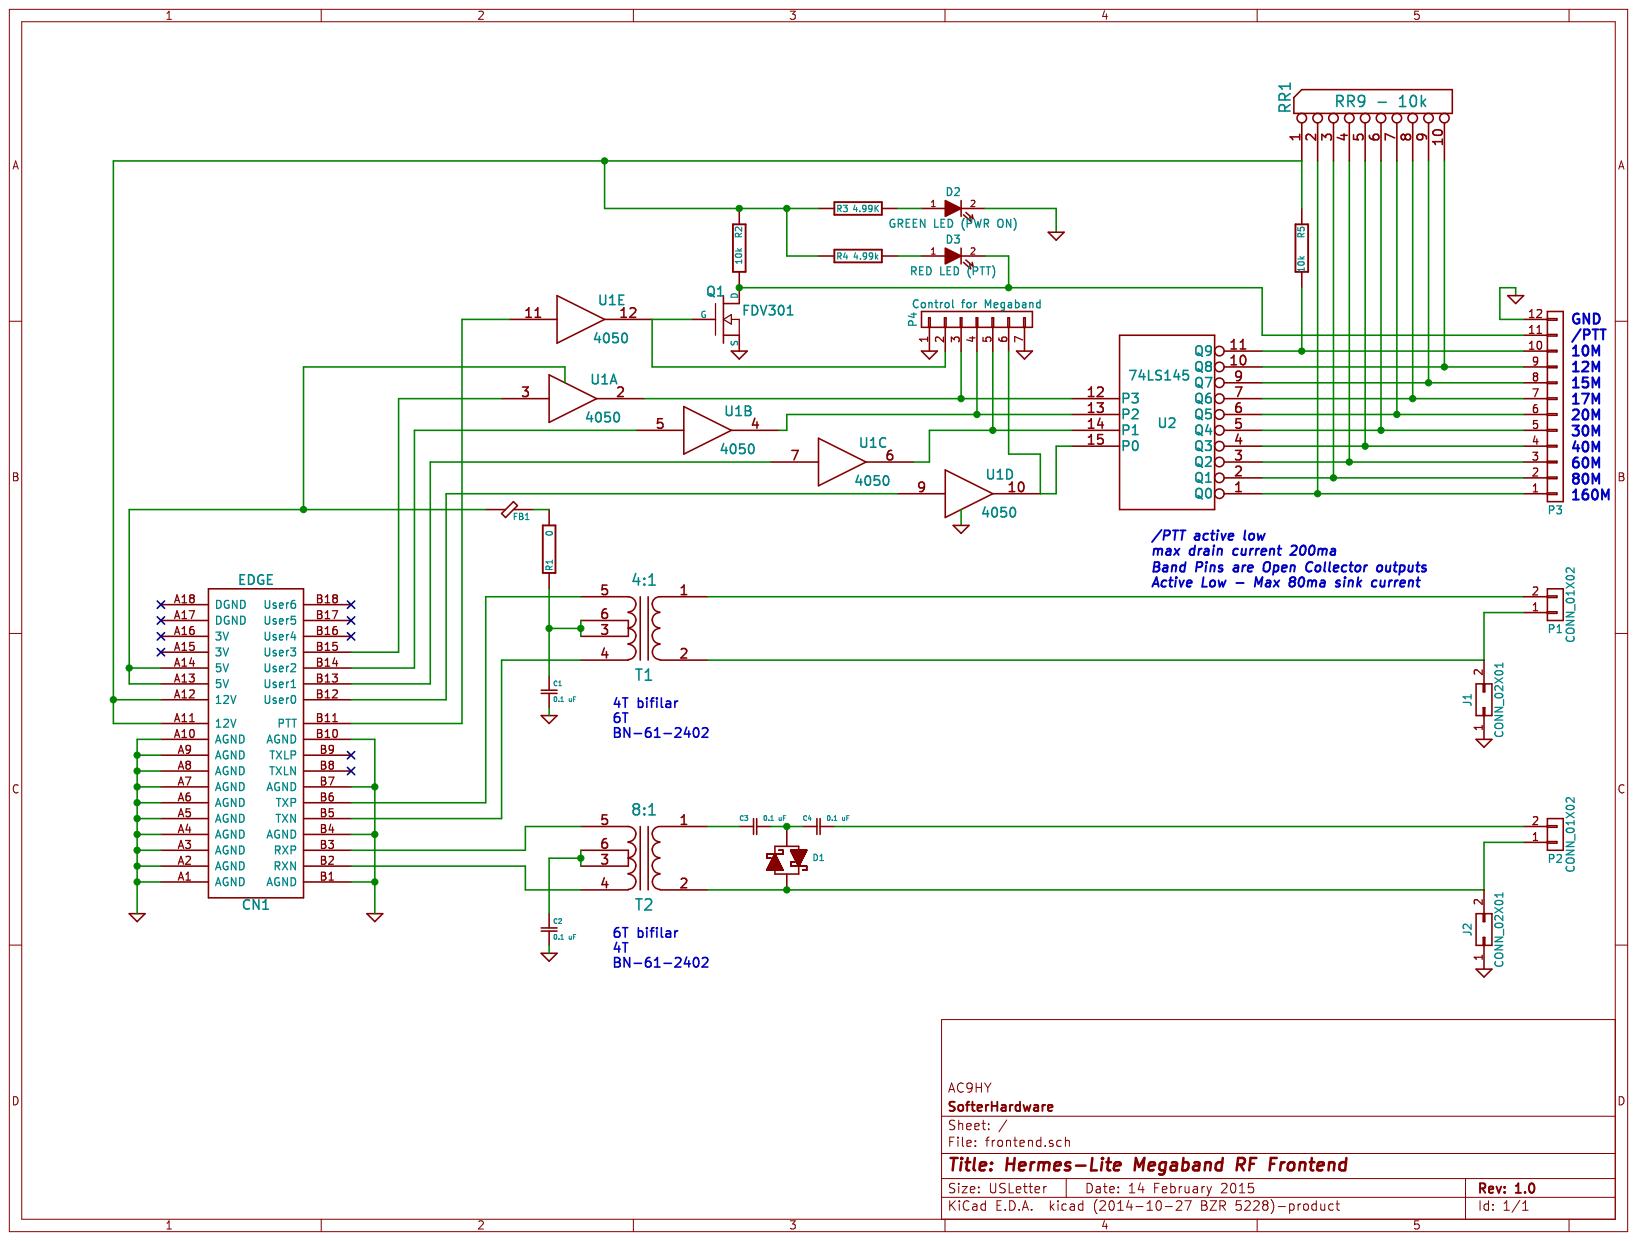
[picture p34: page 1]
