W9JSW/Hermes-Lite/frontend/Megabasic/SMA - J569-ND.pdf

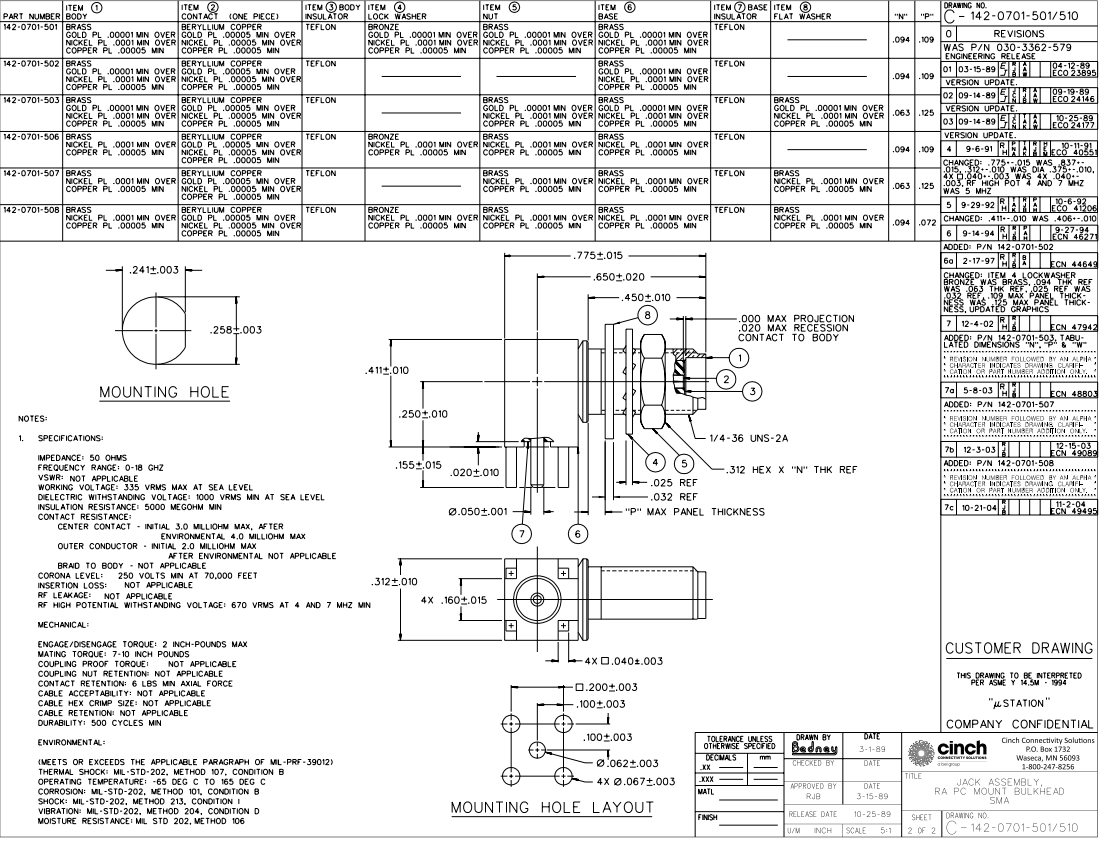
[picture p35: page 1]
UNCONTROLLED COPY
