W9JSW/Hermes-Lite/power2/Power2 ADC Power Schematic v1.3.pdf

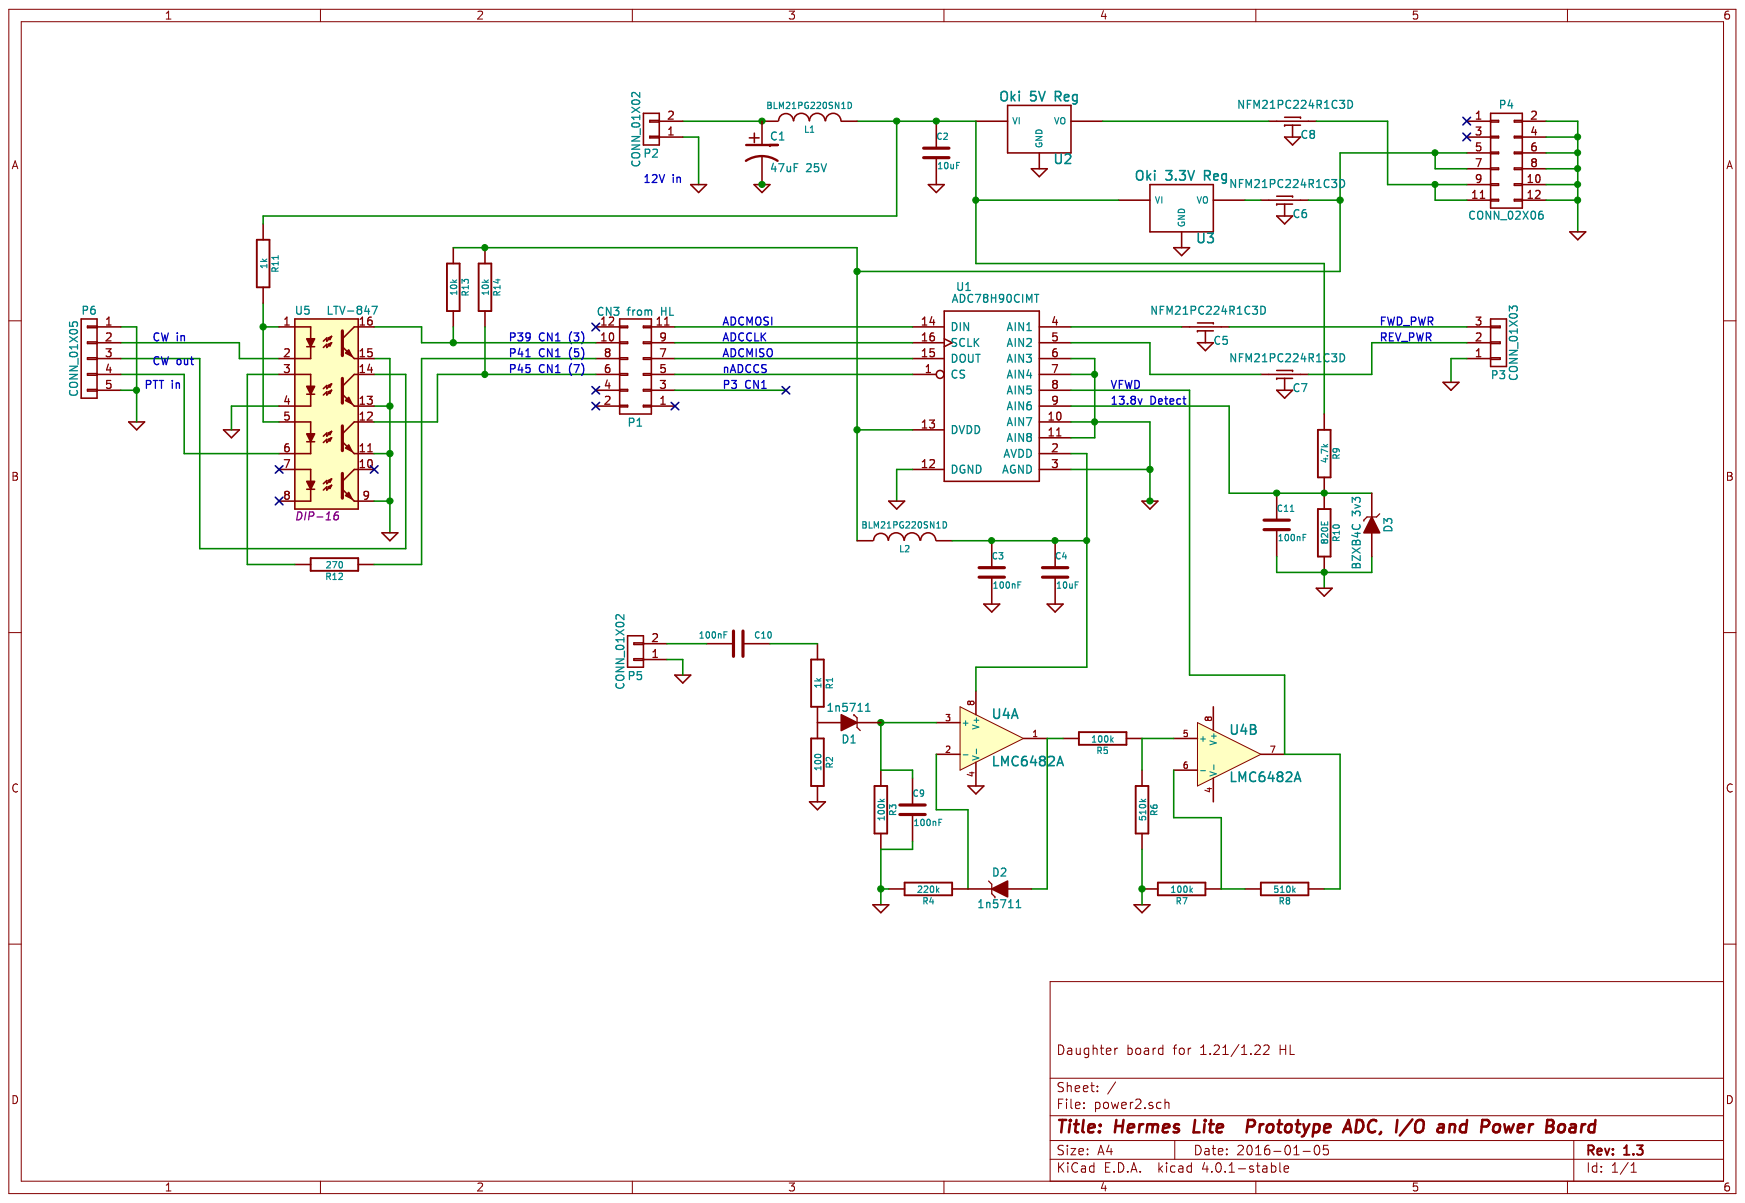
[picture p36: page 1]
