W9JSW/Hermes-Lite/power2/Power2 ADC Power Schematic v1.2.pdf

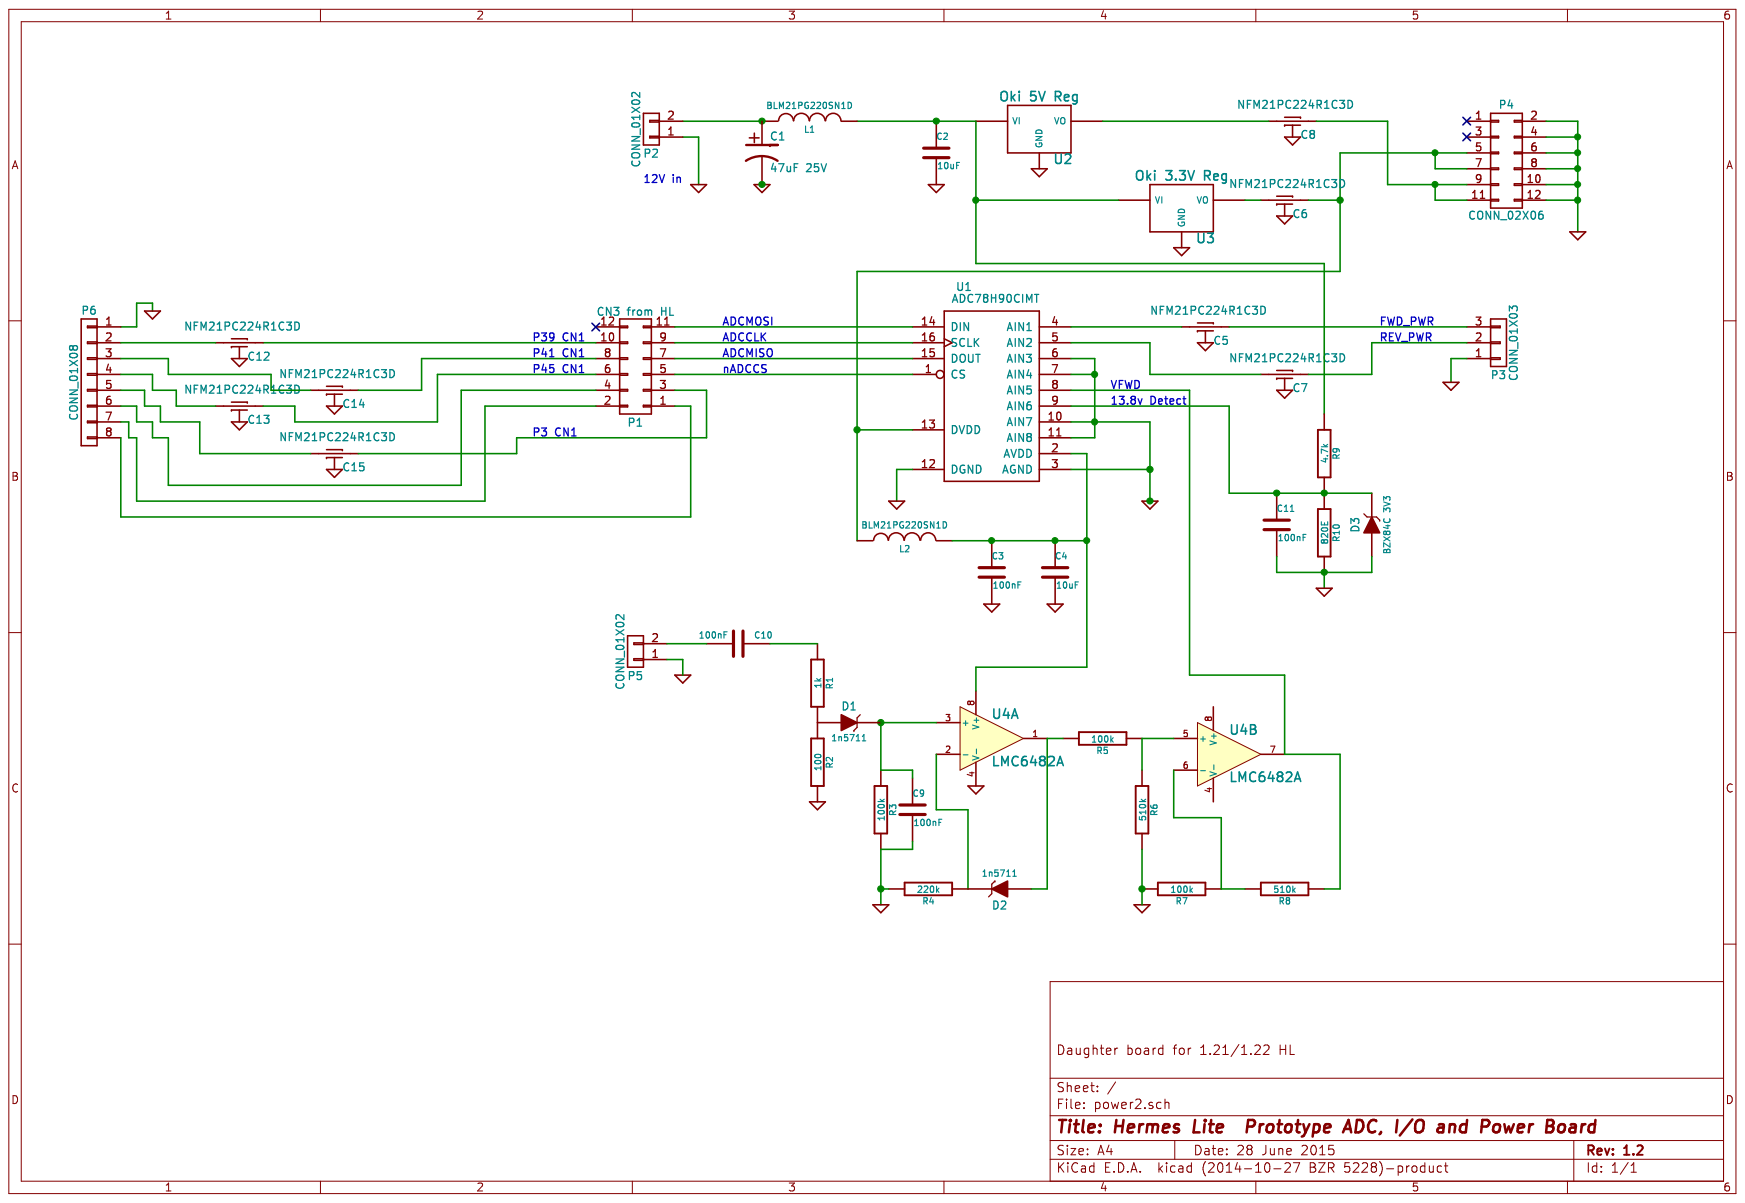
[picture p37: page 1]
