W9JSW/Hermes-Lite/frontend/BPF Superband/RF Frontend - Basic Superband 5W Power Amplifier V1.2.pdf

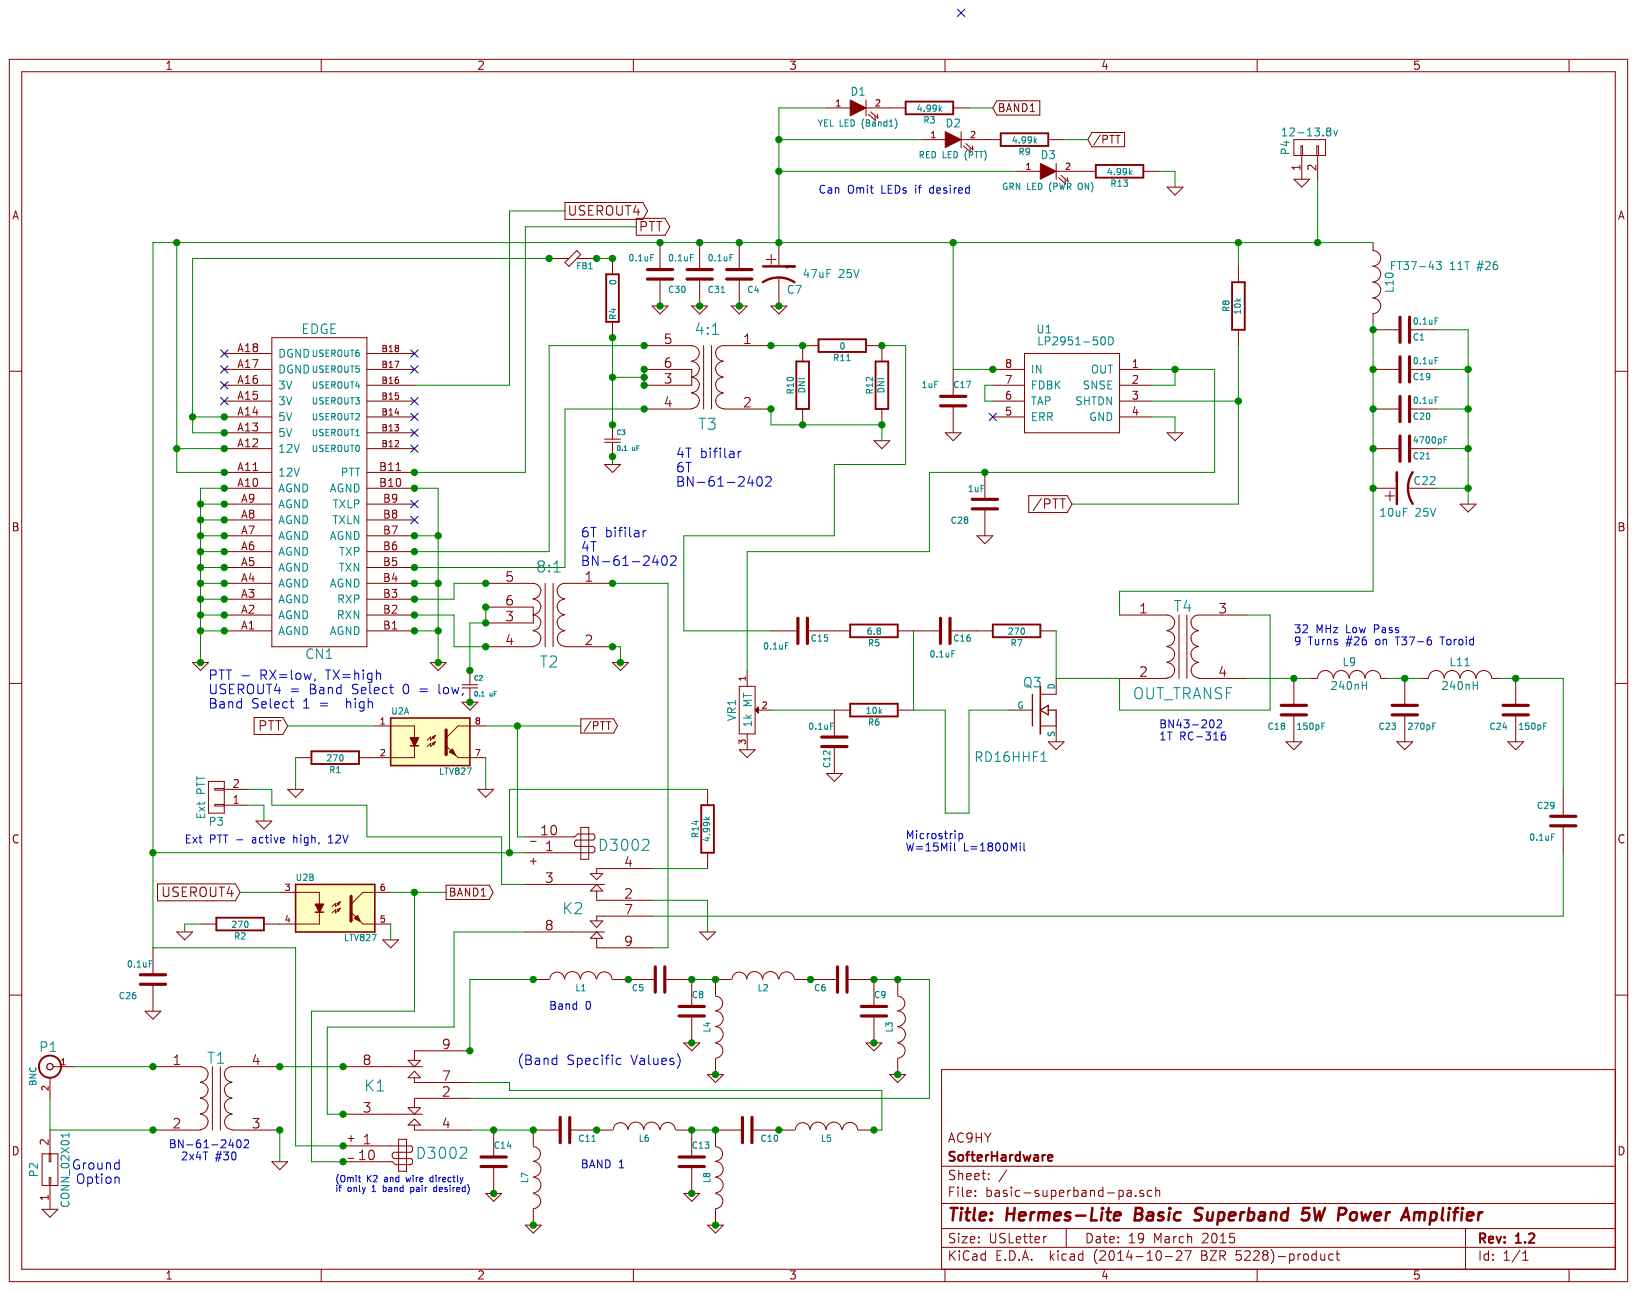
[picture p38: page 1]
