W9JSW/Hermes-Lite/(list of files, drawings)

Other design files:
frontend/v2-RX-Filter/v2rx.dsn
