W9JSW/Hermes-Lite/(commit log)

2015-07-02 New push of files from AC9HY
    [Band Configuration v1.2.xls, Band Configuration v1.3.xls, RX-Filter.sch, TX-filter.sch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]
2015-07-02 Moving files from AC9HY
    [Converter-BOM.xls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]
2015-08-14 New pre-v2 files
    [basic-superband-pa-B_Cu.gbl, basic-superband-pa-B_Mask.gbs, basic-superband-pa-B_Paste.gbp, basic-superband-pa-B_SilkS.gbo, basic-superband-pa-Edge_Cuts.gbr, basic-superband-pa-F_Cu.gtl, basic-superband-pa-F_Mask.gts, basic-superband-pa-F_Paste.gtp]
2015-08-19 Further updates to the pre-V2 amp
    [basic-superband-pa.csv, basic-superband-pa.kicad_pcb, basic-superband-pa.sch, bom-superband v1.3.xls, frontend.sch, tx-filter.sch]
2015-09-01 Added preamp to v2
    [Band Configuration v1.2.xls, ElsieConfiguration.CFG, RX-Filter.sch, TX-filter.sch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]
2015-09-02 80M Filter had a typo said 10T should be 13T
    [Band Configuration v1.3.xls]
2015-09-03 Updated filter values
    [Band Configuration v1.3.xls]
2015-09-05 Completion of Norton addition
    [amp-B_Cu.gbl, amp-B_Mask.gbs, amp-B_SilkS.gbo, amp-Edge_Cuts.gbr, amp-F_Cu.gtl, amp-F_SilkS.gto, amp-In1_Cu.gbr, amp-In2_Cu.gbr]
2015-09-06 additional R added in preamp
    [amp-B_Cu.gbl, amp-B_Mask.gbs, amp-B_SilkS.gbo, amp-Edge_Cuts.gbr, amp-F_Cu.gtl, amp-F_Mask.gts, amp-F_SilkS.gto, amp-In1_Cu.gbr]
2015-09-06 Updates to pure signal tap
    [amp-B_Cu.gbl, amp-B_Mask.gbs, amp-B_SilkS.gbo, amp-Edge_Cuts.gbr, amp-F_Cu.gtl, amp-F_Mask.gts, amp-F_SilkS.gto, amp-drl_map.gbr]
2015-09-07 1.0 fab version
    [amp-B_Cu.gbl, amp-B_Mask.gbs, amp-B_SilkS.gbo, amp-Edge_Cuts.gbr, amp-F_Cu.gtl, amp-F_Mask.gts, amp-F_SilkS.gto, amp-drl_map.gbr]
2015-09-11 updated bom
    [amp.csv, bom-amp-v1.0.xls]
2015-09-16 Few more bom updates
    [bom-amp-v1.0.xls]
2015-10-02 Starting V1.1 updates
    [amp.sch, bom-amp-v1.0.xls, bom-superband v1.2.xls, tx-filter.sch]
2015-10-17 Filter updates
    [amp.sch, tx-filter.sch]
2015-10-22 Updates for bias and 40/60 filter
    [amp.sch, tx-filter.sch]
2015-12-13 more changd for v2
    [amp.csv, amp.kicad_pcb, amp.sch, bom-amp-v1.0.xls, bom.xls, j16ext.kicad_pcb, j16ext.sch, tx-filter.sch]
2015-12-13 new kicad 4.0.1 stable
    [v2rx.sch]
2015-12-31 v2rx changes and update to new kicad
    [RX-Filter.sch, TX-filter.sch, amp.sch, frontend.sch, megaband-bom.xls, power2.sch, tx-filter.sch, v2rx-bom.xls]
2016-01-21 Latest Rx updates
    [power2.sch, v2rx.kicad_pcb, v2rx.sch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]
2016-02-29 Updates for v1.1 amp and V1.4 ADC
    [amp-B.Cu.gbl, amp-B.Mask.gbs, amp-B.SilkS.gbo, amp-B_Cu.gbl, amp-Edge.Cuts.gm1, amp-F.Cu.gtl, amp-F.Mask.gts, amp-F.SilkS.gto]
2016-03-12 New RX Filter Board Layout
    [new-10W-pa-B_Cu.gbl, new-10W-pa-B_Mask.gbs, new-10W-pa-B_SilkS.gbo, new-10W-pa-Edge_Cuts.gbr, new-10W-pa-F_Cu.gtl, new-10W-pa-F_Mask.gts, new-10W-pa-F_SilkS.gto, new-10W-pa-drl_map.gbr]
2016-03-19 Added additional bypass caps
    [v2rx-B.Cu.gbl, v2rx-B.Mask.gbs, v2rx-B.SilkS.gbo, v2rx-Edge.Cuts.gm1, v2rx-F.Cu.gtl, v2rx-F.Mask.gts, v2rx-F.SilkS.gto, v2rx-drl_map.gbr]
2016-04-06 Forked V2-amp to a Push pull derivative
    [amp-B.Cu.gbl, amp-B.Mask.gbs, amp-B.SilkS.gbo, amp-Edge.Cuts.gm1, amp-F.Cu.gtl, amp-F.Mask.gts, amp-F.SilkS.gto, amp-drl_map.gbr]
2016-04-23 Went back to using input transformer with 50R unbalanced input
    [pp-amp.kicad_pcb, pp-amp.sch, tx-filter.sch]
2016-05-03 Ver 1.1 changes
    [amp-B.Cu.gbl, amp-B.Mask.gbs, amp-B.SilkS.gbo, amp-Edge.Cuts.gm1, amp-F.Cu.gtl, amp-F.Mask.gts, amp-F.SilkS.gto, amp-drl_map.gbr]
2016-05-07 Updates to 10M filter
    [amp-B.Cu.gbl, amp-B.Mask.gbs, amp-B.SilkS.gbo, amp-Edge.Cuts.gm1, amp-F.Cu.gtl, amp-F.Mask.gts, amp-F.SilkS.gto, amp-drl_map.gbr]
2016-06-21 Updates for v1.1
    [amp-B.Cu.gbl, amp-B.Mask.gbs, amp-B.SilkS.gbo, amp-Edge.Cuts.gm1, amp-F.Cu.gtl, amp-F.Mask.gts, amp-F.SilkS.gto, amp-drl_map.gbr]
2017-02-11 bom change
    [amp.kicad_pcb, bom-amp-v1.1.xls]
2019-06-09 Updated BOM to current PCB
    [FRSense-BOM.xls]
