W9JSW/Hermes-Lite/(notices)

Notices in the files:
frontend/Megaband-v2/megaband2.kicad_pcb:
© AC9HY/WA2EUJ 2015 Ver 1.2
frontend/v2-PushPull-Amp/pp-amp.kicad_pcb:
© 2016 W9JSW/ZL2APV
frontend/BPF Superband/basic-superband-pa.kicad_pcb:
© 2015 W9JSW
frontend/LPF Superband/basic-superband-pa.kicad_pcb:
© 2015 W9JSW/WA2EUJ
frontend/Megabasic/frontend.kicad_pcb:
© 2015 AC9HY
frontend/v2-RX-Filter/v2rx.kicad_pcb:
© W9JSW 2016 Ver 1.0
FR-Sense/frsense.kicad_pcb:
© 2015 W9JSW ver 1.0
frontend/v2-Amp/amp.kicad_pcb:
© 2016 W9JSW
power2/power2.kicad_pcb:
© 2016 W9JSW ver 1.4
